euclidprobe/euclidprobe.github.io/pages/mydoc/02a_Omron.md

---
title: "Omron Fotek Conversion mounts for Euclid Probe"
keywords: tool mount, Omron Fotek
tags: [mounts]
last_updated: February 5, 2022
permalink: 02a_Omron.html
sidebar: mydoc_sidebar
folder: mydoc
toc: false
summary: Euclid Probe Conversion Mount Omron Fotek 
---

### Omron Mounts

The modular building blocks provided are meant to be integrated into users own printer and other CNC machine designs.  

They are provided in surface mounted and recessed configurations, with pilot holes for M2.5 self tapping screws, M3 tap pilot holes and bores for M3 heatserts. 

<div style="width:100%;text-align:center;"> <a href="stls\Omron\02_OmronFotec.png" data-lity>
</a>

 <a href="stls\Omron\02_OmronFotec90.png" data-lity>
</a></div>  

<P>
Omron Mounts are <a href='https://github.com/nionio6915/Euclid_Probe/tree/stls/Mount%20Adapters/Omron' target="_blank"><b> here.</b></a>
