euclidprobe/euclidprobe.github.io/pages/mydoc/02c_Voron.md

---
title: "Voron Overview"
keywords: Voron
tags: [mounts, docks]
last_updated: February 5, 2022
permalink: 02c_Voron.html
sidebar: mydoc_sidebar
folder: mydoc
toc: true
summary: Voron Probe Docks & Mounts Overview 
---

## Mounts & Docks for Voron
Below is a general summary for Voron printers. More specific information on the individual model pages. 

Screen snips, CAD's and stl's in are <a href="https://raw.githubusercontent.com/nionio6915/Euclid_Probe/main/stls/Voron/" targer="blank">in the github repo</a> and linked from the individual pages. 

Voron printers can utilize the Omton/Fotek conversion mount for existing builds. 

Modified carraige shells (both MGN9 & MGN 12 versions) locate the toolboard in the same realtive (X,Y) location as the inductive probe, but ~4.5mm higher. 

{% include note.html content="Using conversion mounts offers the most flexibility and fine tuning of probe height." %}

{% include note.html content="<b> Stealthburner / CW2 has been implemented. As the source was finally released, we have integrated Euclid's mounting into the native carriage.    
.</b>" %}

## Clcockwork1 - 2xMGN9 Rail & MGN12 - Afterburner Native Mounts
The left and right halves of the Afterburner carriage are modified to accept the probe with M3 screws and heatserts or M2.5 self tapping screws from underneath. Fine tuning and tweaking credited to garbqgebag.  

<div style="width:100%;text-align:center;">
<a href="images\02-voron\afterburner-1.8.png" data-lity>
</a>

<a href="images\02-voron\Voron_Afterburner-Native.png" data-lity>
</a>

<a href="images\02-voron\image1.jpg" data-lity>
</a>

<a href="images\02-voron\image2.jpg" data-lity>
</a>
</div>  

## Omron Mounts  
The standard Omron mount is 0 degree relative rotation to the mounting face of the Omron device. Adjustment slots are similar to the original device.  Designed to be printed upside-down without supports.  Screens are out of date, but the stls and CAD models are updated

<div style="width:100%;text-align:center;"> <a href="stls\Omron\02_OmronFotec.png" data-lity>
</a>  

 <a href="stls\Omron\02_OmronFotec90.png" data-lity>
</a>  
</div>  

Omron Mounts are <a href='https://github.com/nionio6915/Euclid_Probe/tree/main/stls/Mount%20Adapters/Omron' target="_blank"><b> here.</b></a>

## Skinny Mount- Improved Airflow mount by v6cl 
Github user v6cl posted a video to Youtube that we came across and we were impressed by their deployment. They designed a ‘skinny mount’ to  <a href="https://github.com/v6cl/My-Voron2.4-Customs/tree/main/euclid_mount_slim" targer="blank">open up the cooling vents in the toolhead.</a>

<div style="width:100%;text-align:center;"> <a href="images\02-voron\v6cl.png" data-lity>
</a>  

 <a href="images\02-voron\v6cl_dtl.png" data-lity>
</a>  
</div>  
<br>  

Their repo is at <a href="https://github.com/v6cl/My-Voron2.4-Customs">https://github.com/v6cl/My-Voron2.4-Customs</a>  

## Stealthburner / Clockwork2 - MGN12 Native Mounts

New in the github repo are the revised Omron-Fotek Inductive Sensor adapters, .stp's and .stl's. 

 <div style="width:100%;text-align:center;"> 
  <a href="images\02-voron\CW2_Native.jpg" data-lity>  
 </a>

  <a href="images\02-voron\OmronFotekV4.jpg" data-lity>  
 </a>

</div>
<hr>
The left and right halves of the native carriage shells for Voron Stealthburner / CW2 / Clockwork 2 have been modified to accept the probe with M2.5 self tapping screws from underneath. 

## Trident & 2.4 Native Gantry Dock & Mount 

The mount attaches with screws in the holes of the left side motor bracket and clears the radius of the cable chain. M5x16 & M5x30's  
     
The dock attaches to the mount with an M5 nut dropped in the keyholed channel and thru-bolts with an M5x16 screw. Adjust the elevation as required to allow for a clean exit of the probe PCB. Fine tuning and tweaking credited to Dattas and StvPtrsn.

<div style="width:100%;text-align:center;">
<a href="images\02-voron\Trident_TopMount.png" data-lity>
</a>  

<a href="images\02-voron\Trident_TopMountXRay.png" data-lity>
</a>  

<a href="images\02-voron\Trident_TopMountXRay2.png" data-lity>
</a>  
</div> 

## Straight Armed Gantry Dock & Mount
This mount attaches to the rear extrusion of the gantry, in the native holes of the left side motor bracket. Requires the use of the Omron90 mount. Lateral adjustment buy the thru-bolt on the bottom, M5x16. Fine vertical adjustment via the slotted holes in the Omron mount. 

This probe orientation / configuration should be compatible with the other detachable probe macros for Voron. 

<div style="width:100%;text-align:center;">
<a href="images\02-voron\Voron2.4_XRailMount2.png" data-lity>
</a>  

<a href="images\02-voron\Voron2.4_XRailMount.png" data-lity>
</a>  
</div>

## 90 Degree Gantry Dock & Mount
This dock is orientated in the X direction and attaches to the rear extrusion of the gantry, in the native holes of the left side motor bracket. Requires the use of the Omron90 mount. Attaches with longer screws. Lateral Y adjustment via the thru-bolt on the bottom, M5x16. Fine vertical adjustment via the slotted holes in the Omron mount or with shims between the Y adjuster.   

<div style="width:100%;text-align:center;">
<a href="images\02-voron\Voron2.4_XRailMount90.png" data-lity>
</a>  

<a href="images\02-voron\Voron2.4_XRailMount90a.png" data-lity>
</a>  
</div>

## Voron 2.4 Bed Rail Mounted Dock  
The bed mounts are provided in 2 heights to suit the overall stack height of the bed plate and printing surfaces. This dock has been tested by multiple users. Fine tuning and tweaking credited to kageurufu.  

The stls are provided to print 'nose' down and have minimal print in place supports to ensure that the back shoulder is printed and aligned.  

The bed rail mount uses 2-M5x16 screws and extrusion nuts to attach to either side of the extrusions that support the bed.  

There are 2 hex-shaped cross holes to the main mounting screws- these are provide to insert M3 screws to use as fine adjusters without tapping. They can be M3 setscrews and left in place or any M3 screw used temporarily.   
<div style="width:100%;text-align:center;">

<a href="images\02-voron\Voron2.4BedMount.png" data-lity>
</a>  

<a href="images\02-voron\Voron2.4BedMount.png" data-lity>
</a>  
</div>
