euclidprobe/euclidprobe.github.io/pages/mydoc/02c_VCore.md

---
title: "VCore"
keywords: probe dock, tool mount
tags: [mounts, docks]
last_updated: January 24, 2022
permalink: 02c_VCore.html
sidebar: mydoc_sidebar
folder: mydoc
toc: false
summary: Euclid Probe Docks & Probes 
---

## Mounts by Printer VCore
EVA carriage mount brackets and front cross rail mounted docks have been modeled and placed in the repo by series. 

Print the dock on the angled back face with the dock arms pointed up. The back chamfer and reveal a hex shaped bore to install the M5x20 screw and T-nut for the slot. The alignment bosses are sized for an 8mm slot width.  

<div style="width:100%;text-align:center;">
  <a href="images\02-VCore\Print_Orientation.png" data-lity>
  </a>
</div>

The initial EVA carriage mounts was proportioned for Duct V2.1 Straight and has recessed for nuts to attach the toolboard from the underside. Use M3x10 button head, or countersink the PCB for M3X10 flat head screws.

The EVA 2.4 mount was designed to fit around the regular tri-horn mount. Use with either the mid-width or wide width tri-horn will require spacers to adjust the mount outwards, and will result in a reduced print area.

EVA 3 mount and dock is user contributed. 

The V-Core3 dock is proportioned for 3030 extrusion.

The V-Core Legacy dock is proportioned to fit under the 2040 front extrusion. This dock is in 2 parts and uses an M3 drawbolt to provide a small amount of vertical adjustability .
