euclidprobe/euclidprobe.github.io/pages/mydoc/02c_VCore3.md

---
title: "VCore3"
keywords: probe dock, tool mount
tags: [mounts, docks]
last_updated: January 24, 2022
permalink: 02c_VCore3.html
sidebar: mydoc_sidebar
folder: mydoc
toc: false
summary: Euclid Probe Docks & Mounts RatRig V-Core3
---

## Mounts by Printer VCore3
<div style="width:100%;text-align:center;">
<style type="text/css">
.tg  {border-collapse:collapse;border-spacing:0;}
.tg td{border-color:black;border-style:solid;border-width:0px;font-family:Arial, sans-serif;font-size:14px;
  overflow:hidden;padding:0px;word-break:normal;}
.tg th{border-color:black;border-style:solid;border-width:0px;font-family:Arial, sans-serif;font-size:14px;
  font-weight:normal;overflow:hidden;padding:0px;word-break:normal;}
.tg .tg-0pky{border-color:inherit;text-align:center;vertical-align:middle}
</style>

<table class="tg">
<tbody>
<tr>
<td>
<div style="width:100%;text-align:center;">
  <a href="images\02-VCore\Euclid_Probe_Screen1.jpg" data-lity>
  </a>
</div>
</td>
<td>
<div style="width:100%;text-align:center;">
  <a href="images\02-VCore\Euclid_Probe_Screen2.jpg" data-lity>
  </a>
</div>
</td>
</tr>
<tr>
<td>
<div style="width:100%;text-align:center;">
  <a href="images\02-VCore\Euclid_Probe_Screen3.jpg" data-lity>
  </a>
</div>
</td>
<td>
<div style="width:100%;text-align:center;">
  <a href="images\02-VCore\Euclid_Probe_Screen4.jpg" data-lity>
  </a>
</div>
</td>
</tr>

<tr>
<td>
<div id="stl_cont0" style="width:450px;height:450px;margin:5 auto">
    <script>
        var stl_viewer=new StlViewer
        (
        document.getElementById("stl_cont0"), 
          {
            allow_drag_and_drop: false,
            auto_rotate:true,
            auto_resize:true,
            zoom:110,
            models: 
            [ 
             {filename:"https://raw.githubusercontent.com/nionio6915/Euclid_Probe/main/stls/V-Core/V-Core3/Euclid_EVA_DockV5_3030.stl",color:"#1E73BE", rotationx:5.0,    rotationy:-0.50, rotationz:0.0} 
            ]
          }
        );
    </script>
</div> 
</td>

<td>
<div id="stl_cont1" style="width:450px;height:450px;margin:5 auto">
    <script>
        var stl_viewer=new StlViewer
        (
        document.getElementById("stl_cont1"), 
          {
            allow_drag_and_drop: false,
            auto_rotate:true,
            auto_resize:true,
            zoom:110,
            models: 
            [ 
             {filename:"https://raw.githubusercontent.com/nionio6915/Euclid_Probe/main/stls/V-Core/V-Core3/Euclid_EVA_MountV5_M2.5SelfTapping.stl",color:"#1E73BE", rotationx:5.0,    rotationy:-0.50, rotationz:0.0} 
            ]
          }
        );
    </script>
</div> 
</td>
</tr>
<tr>
    <td class="tg-0pky"><a href="https://raw.githubusercontent.com/nionio6915/Euclid_Probe/main/stls/V-Core/V-Core3/Euclid_EVA_DockV5_3030.stl">V-Core3 3030 Extrusion Dock</a></td>
    <td class="tg-0pky"><a href="https://raw.githubusercontent.com/nionio6915/Euclid_Probe/main/stls/V-Core/V-Core3/Euclid_EVA_MountV5_M2.5SelfTapping.stl">V-Core3 EVA Carriage Mount</a></td>
</tr>
</tbody>
</table>  
</div>  

## Print Orientation

<div style="width:100%;text-align:center;">
  <a href="images\02-VCore\Print_Orientation.png" data-lity>
  </a>  
</div>

## CAD Files
The current CAD files are <a href='https://github.com/nionio6915/Euclid_Probe/tree/main/CAD' target="_blank"><b> available here in the repo.</b></a>
