euclidprobe/euclidprobe.github.io/pages/mydoc/00-kit.md

---
title: "Buy a Euclid Probe Kit"
keywords: euclid probe magnetic z-probe endstop
tags: [resellers, buying, EU, USA, UK, DK]
last_updated: February 16, 2022
sidebar: mydoc_sidebar
permalink: 00_kit.html
toc: false
summary: Where to get the highly accurate, magnetically coupled, Z probe
---

## How to get Euclid Probe

### Buy a kit from a reseller 
Due to numerous inquiries and customer demand, we have begun producing kits and make them available through select resellers.  Part of the proceeds of these sales directly support both the creators of Euclid Probe and the reseller. These funds provide for further research and development for Euclid Probe, the continual dock and mount creation and adaptations, and the ongoing firmware improvements. 

Kit assembly instructions are <a href="/01_kitbuild.html">here</a>

### We don't offshore 
We don't offshore the labor to package and label Euclid kits- we believe in the ethos of putting community first and that sound business practices can serve a greater good.  

While we are not a 'B Corp' we look to the World's B Corps for inspiration and example of putting community at the heart of what they do.  

We believe in the importance to serve those in need locally over the maximization of profit: we have begun a partnership that engages the services of local community organizations whose mission is to improve the quality of life for individuals with disabilities through vocational and related programming to produce the kits from our sourced materials.  

### Resellers:

<div style="width:100%;text-align:center;">
<style type="text/css">
.tg  {border-collapse:collapse;border-spacing:0;}
.tg td{border-color:white;border-style:solid;border-width:4px;font-family:Arial, sans-serif;font-size:14px;
  overflow:hidden;padding:10px 5px;word-break:normal;}
.tg th{border-color:white;border-style:solid;border-width:4px;font-family:Arial, sans-serif;font-size:14px;
  font-weight:normal;overflow:hidden;padding:10px 5px;word-break:normal;}
.tg .tg-0lax{text-align:left;vertical-align:middle}
</style>

<table class="tg">
  <thead>
  </thead>

<tbody>
  <tr>
    <td class="tg-0lax"></td>
    <td class="tg-0lax"><a href="https://lukeslabonline.com/products/euclid-probe-kit" target="blank">&nbsp;&nbsp;LukesLab.Online&nbsp;&nbsp;</a></td>
    <td class="tg-0lax">&nbsp;&nbsp;</td>
    <td class="tg-0lax"></td>
  </tr>

  <tr>
    <td class="tg-0lax"></td>
    <td class="tg-0lax"><a href="https://713maker.com/en/euclid" target="blank">&nbsp;&nbsp;713maker.com &nbsp;&nbsp;</a></td>
    <td class="tg-0lax">&nbsp;&nbsp;</td>
    <td class="tg-0lax"></td>
  </tr>

  <tr>
    <td class="tg-0lax"></td>
    <td class="tg-0lax"><a href="https://www.fabreeko.com/products/euclid-probe-kit-24v" target="blank">&nbsp;&nbsp;Fabreeko&nbsp;&nbsp;</a></td>
    <td class="tg-0lax">&nbsp;&nbsp;</td>
    <td class="tg-0lax"></td>
  </tr>
  <tr>
    <td class="tg-0lax"></td>
    <td class="tg-0lax"><a href="https://3do.dk/soeg?controller=search&s=euclid" target="blank">&nbsp;&nbsp;3do.eu&nbsp;&nbsp;</a></td>
    <td class="tg-0lax">&nbsp;&nbsp;</td>
    <td class="tg-0lax"></td>
  </tr>

  <tr>
    <td class="tg-0lax"><a href="https://gingerbeard3d.de/" target="blank">&nbsp;&nbsp;</a></td>
    <td class="tg-0lax"><a href="https://gingerbeard3d.de/" target="blank">&nbsp;&nbsp; Gingerbeard3D&nbsp;&nbsp;</a></td>
    <td class="tg-0lax">&nbsp;&nbsp;</td>
    <td class="tg-0lax"></td>
  </tr>

  <tr>
    <td class="tg-0lax"></td>
    <td class="tg-0lax"><a href="https://www.ratrig.com/" target="blank">&nbsp;&nbsp;RatRig&nbsp;&nbsp;</a></td>
    <td class="tg-0lax">&nbsp;  &nbsp; </td>
    <td class="tg-0lax"></td>
  </tr>

  <tr>
    <td class="tg-0lax"></td>
    <td class="tg-0lax"><a href="https://www.jayuk.org/" target="blank">&nbsp;&nbsp; Jay's UK&nbsp;&nbsp;</a></td>
    <td class="tg-0lax">&nbsp;&nbsp;</td>
    <td class="tg-0lax"></td>
  </tr>

  <tr>
    <td class="tg-0lax"></td>
    <td class="tg-0lax"><a href="https://www.raven3dtech.com.au/" target="blank">&nbsp;&nbsp;Raven 3D Tech&nbsp;&nbsp;</a></td>
    <td class="tg-0lax">&nbsp;  &nbsp;</td>
    <td class="tg-0lax">  </td>
  </tr>
</tbody>
</table>
</div>
