euclidprobe/euclidprobe.github.io/pages/mydoc/03_misc.md

---
title: "Euclid Wiring to Duet3 Hardware"
keywords: probe wiring
tags: [wiring, RAMPS, ReARM, MKS, MKS_BASE, Fystec, Spider]
last_updated: Feb 5, 2022
permalink: 03_misc.html
sidebar: mydoc_sidebar
folder: mydoc
toc: true
summary: Euclid Wiring to Duet3 Hardware
---
### RAMPS Controller Commissioning
MEGA/RAMPS mainboard can use either the standard 5V or 24V Euclid models. Wire Euclid Probe to any open endstop connector.    

<table>
<tr>
   <td> <a href="images\04-wiring\boards_misc\Slide1.PNG" data-lity>
        </a>
   </td>
</tr>
<tr>
   <td><b>RAMPS Mainboard Wiring Diagram</b></td>
</tr>
</table>

### MKS_BASE Commissioning
MKS_BASE mainboard can use either the standard 5V or 24V Euclid models. Wire Euclid Probe to any open endstop connector. 
<table>
<tr>
   <td> <a href="images\04-wiring\boards_misc\Slide2.PNG" data-lity>
        </a>
   </td>
</tr>
<tr>
   <td><b>MKS_BASE 1.6 Wiring Diagram</b></td>
</tr>
</table>

### Panucatt ReARM Commissioning
ReARM mainboard can use either the standard 5V or 24V Euclid models. Wire Euclid Probe to any open endstop connector. 
<table>
 <tr>
    <td> <a href="images\04-wiring\boards_misc\Slide3.PNG" data-lity>
         </a>
    </td>
 </tr>
 <tr>
    <td><b>ReARM Mainboard Wiring Diagram</b>
    </td>
 </tr>
</table>

### Fystec Spider Commissioning
Fystec Spider mainboard can use either the standard 5V or 24V Euclid models depending on the application. Wire Euclid Probe to any open endstop connector or to the probe connector.

Wiring to the probe connector via a toolboard requres coordination- do not wire multiple BAT85 diodes in series. 
<table>
 <tr>
    <td> <a href="images\04-wiring\boards_misc\Slide4.PNG" data-lity>
         </a>
    </td>
 </tr>
 <tr>
     <td><b>Fystec Spider Wiring Diagram as endstop</b>
     </td>
 </tr>
 <tr>
     <td> <a href="images\04-wiring\boards_misc\Slide5.PNG" data-lity>
         </a>
     </td>
 </tr>
 <tr>
     <td><b>Fystec Spider Wiring Diagram to toolboard</b>
     </td>
 </tr>

 </table>
