euclidprobe/euclidprobe.github.io/pages/mydoc/03_fly.md

---
title: "Euclid Wiring to FLY Mellow boards"
keywords: probe wiring
tags: [wiring, FLY, Mellow, FLY-Mellow]
last_updated: Feb 5, 2022
permalink: 03_fly.html
sidebar: mydoc_sidebar
folder: mydoc
toc: true
summary: Euclid Wiring to Fly-Mellow Hardware
---
FLY Mellow boards can use either the standard 5V or 24V Euclid models wired to any open endstop connector.  

### FLY Mellow RRF3-E3
<table>
 <tr>
     <td> <a href="images\04-wiring\boards_Fly\Slide1.PNG" data-lity>
         </a>
     </td>
 </tr>
 <tr>
     <td><b>Fly RRF E3 Wiring Diagram</b></td>
 </tr>
</table>

### FLY Mellow FLY-CDYV3
<table>
 <tr>
     <td> <a href="images\04-wiring\boards_Fly\Slide3.PNG" data-lity>
         </a>
     </td>
 </tr>
 <tr>
     <td><b>FLY-Mellow FLY-CDY Wiring Diagram</b></td>
 </tr>
 </table>

### FLY Mellow FLY-F407ZG
<table>
 <tr>
     <td> <a href="images\04-wiring\boards_Fly\Slide2.PNG" data-lity>
         </a>
     </td>
 </tr>
 <tr>
     <td><b>FLY-Mellow FLY-F407ZG Wiring Diagram</b></td>
 </tr>
 </table>

### FLY Mellow Super 8
<table>
 <tr>
     <td> <a href="images\04-wiring\boards_Fly\Slide4.PNG" data-lity>
         </a>
     </td>
 </tr>
 <tr>
     <td><b>FLY-Mellow Super 8 Wiring Diagram</b></td>
 </tr>
 </table>
