euclidprobe/euclidprobe.github.io/pages/mydoc/03_smoothie.md

---
title: "Euclid Wiring to Smoothieboard"
keywords: probe wiring
tags: [wiring, smoothie, smoothieboard]
last_updated: Feb 5, 2022
permalink: 03_smoothie.html
sidebar: mydoc_sidebar
folder: mydoc
toc: false
summary: Euclid Wiring to Smoothieboard Hardware
---
### Smoothiebaord Commissioning
Smoothieboards can use either the standard 5V or 24V Euclid models wired to any open endstop connector.    

<table>
 <tr>
     <td> <a href="images\04-wiring\boards_misc\smoothieV1.png" data-lity>
         </a>
     </td>
 </tr>
 <tr>
     <td><b>Smoothieboard Wiring Diagram</b></td>
 </tr>
 </table>
