euclidprobe/euclidprobe.github.io/pages/mydoc/03_duet2.md

---
title: "Euclid Wiring to Duet2 Hardware"
keywords: probe wiring
tags: [wiring, Duet2]
last_updated: Feb 5, 2022
permalink: 03_duet2.html
sidebar: mydoc_sidebar
folder: mydoc
toc: false
summary: Euclid Wiring to Duet2 Hardware
---
### Duet2 Commissioning
Duet2 boards can use either the standard 5V or 24V Euclid models. Wire Euclid Probe to the Probe port any open endstop connector.    

<table>
 <tr>
     <td> <a href="images\04-wiring\boards_Duet\Slide3.PNG" data-lity>
         </a></td>
 <tr>
     <td><b>Duet2 Mainboard Wiring Diagram</b></td>
 </tr>
 <tr>
     <td> <a href="images\04-wiring\boards_Duet\Slide4.PNG" data-lity>
         </a></td>
 <tr>
     <td><b>Duet2 Mainboard Wiring as Picture</td>
 </tr>
 </table>
