euclidprobe/euclidprobe.github.io/pages/mydoc/00-HT.md

---
title: "Industrial, High Temperature, Bulk Buy"
keywords: euclid probe magnetic z-probe endstop
tags: [Industrial, High Temp, bulk buy, white box, custom]
last_updated: February 16, 2022
sidebar: mydoc_sidebar
permalink: 00_HT.html
toc: false
summary: Where to get the highly accurate, magnetically coupled, Z probe
---

## How to get other versions of Euclid Probe

### High Temp & Industrial Versions
Higher service temperature versions of both both 100C and 120C have been developed and are at this time, custom order, hand built options. Please contact us through the web form for details.

### White Box / Bulk buy
In response to customer inquiry, bulk packs of Euclid Probe are available at modest discounts to printer builders and integrators. Please contact us through the web form for details.
