euclidprobe/euclidprobe.github.io/pages/mydoc/02c_Ender5.md

---
title: "Ender5"
keywords: probe dock, tool mount
tags: [mounts, docks]
last_updated: Feb 5, 2022
permalink: 02c_Ender5.html
sidebar: mydoc_sidebar
folder: mydoc
toc: false
summary: Euclid Probe Docks & Probes 
---

## Mounts by Printer Ender5
Page currently undergoing maintenance. 

The following .zip files includes .step and .DXF files of all the modular docks and mounts for CAD interchange.

The mounting instructions and dock for the Ender5 are similar to the Ender3 above, with the exception that the toolboard mount has a cutout for the X-axis belt crimp, and the mount faces the front of the printer.
The dock keys into the corner clamp and hopefully reuses the M5 mounting screw and T-nut.

<div style="width:100%;text-align:center;"> <a href="images\02-ender\Ender5Front.jpg " data-lity>
</a></div>

<div style="width:100%;text-align:center;"> <a href=" images\02-ender\Ender5Iso.jpg" data-lity>
</a></div>

<div style="width:100%;text-align:center;"> <a href="images\02-ender\Ender5Dock.jpg " data-lity>
</a></div>

<div style="width:100%;text-align:center;"> <a href="images\02-ender\Ender5XRayFront.jpg " data-lity>
</a></div>

<div style="width:100%;text-align:center;"> <a href=" images\02-ender\Deploy.jpg" data-lity>
</a></div>

<div style="width:100%;text-align:center;"> <a href=" images\02-ender\Retract.jpg" data-lity>
</a></div>
