euclidprobe/euclidprobe.github.io/pages/mydoc/02c_Ender.md

---
title: "Ender"
keywords: Ender Overview 
tags: [mounts, docks]
last_updated: Feb 5, 2022
permalink: 02c_Ender.html
sidebar: mydoc_sidebar
folder: mydoc
toc: false
summary: Ender Probe Docks & Mounts 
---

## Mounts by Printer Ender
Page currently undergoing maintenance. 

The following .zip files includes .step and .DXF files of all the modular docks and mounts for CAD interchange.
