euclidprobe/euclidprobe.github.io/pages/mydoc/02a_BLTouch.md

---
title: "BL Touch / CR Touch Conversion mount for Euclid Probe"
keywords: BL Touch, conversion
tags: [mounts]
last_updated: February 5, 2022
permalink: 02a_BLTouch.html
sidebar: mydoc_sidebar
folder: mydoc
toc: false
summary: Euclid Probe BL Touch & CR Touch Conversion mount 
---

The BL Touch mounts are designed to be printed either on the side or upside-down, with the top against the build plate (the stl previewer may render them in their upright orientation).

The current recommended model is this skeletonized version of the BL Touch Mount.  
<P>
BLTouch Mounts are  <a href='https://github.com/nionio6915/Euclid_Probe/tree/main/stls/Mount%20Adapters/BLTouch' target="_blank"><b> here.</b></a>  

>

<script>
    var stl_viewer=new StlViewer
    (
      document.getElementById("stl_cont"), 
      {
          allow_drag_and_drop: false,
          auto_rotate:true,
          auto_resize:true,
          models: 
          [ 
            {filename:"../stls/BLTouch/BLTouchV3.stl", color:"#1E73BE", rotationx:5.0, rotationy:-0.50, rotationz:0.0} 
          ]
      }
    );
</script>  

There are also further customized versions of BLTouch mount for Hypercube with a slightly wider (5mm) lateral offset.  

In the following renders, the yellow items are the single wall PIP supports to be removed after printing.

<div style="width:100%;text-align:center;"> <a href="stls\BLTouch\02_BLT_Adapter.jpg" data-lity>
</a>

<div style="width:100%;text-align:center;"> <a href="stls\BLTouch\02_BLT.jpg" data-lity>
</a>

 <a href="stls\BLTouch\02_BL_Touch_M3HeatSerts.jpg" data-lity>
</a></div>
