euclidprobe/euclidprobe.github.io/pages/mydoc/02a_Inductive.md

---
title: "Inductive Probe Conversion mounts for Euclid Probe"
keywords: inductive, conversion
tags: [mounts]
last_updated: February 5, 2022
permalink: 02a_Inductive.html
sidebar: mydoc_sidebar
folder: mydoc
toc: false
summary: Euclid Probe BL Touch Conversion mount 
---

### Inductive Toolboard Mounts

The modular building blocks provided are meant to be integrated into users own printer and other CNC machine designs. They are provided in surface mounted and recessed configurations, with pilot holes for M2.5 self tapping screws, M3 tap pilot holes and bores for M3 heatserts. 
<div style="width:100%;text-align:center;">  
<table>
<tr>
  <td><div style="width:100%;text-align:center;"> </div></td>
  <td><div style="width:100%;text-align:center;"> </div></td>
</tr>
<tr>
  <td>
  <script>
    var stl_viewer=new StlViewer
    (
      document.getElementById("stl_cont0"), 
      { 
          allow_drag_and_drop: false, 
          auto_rotate:true, 
          auto_resize:true, 
          models: 
           [ 
            {filename:"../stls/Inductive/12mmInductive.stl", color:"#1E73BE", scale:3, rotationx:5.0, rotationy:-0.50, rotationz:0.0} 
           ] 
      }
    );
  </script>
  </td>

  </td>
  <td>
  <script>
    var stl_viewer=new StlViewer
    (
      document.getElementById("stl_cont1"), 
      { 
          allow_drag_and_drop: false, 
          auto_rotate:true, 
          auto_resize:true, 
          models: 
           [ 
            {filename:"../stls/Inductive/18mmInductive.stl", color:"#1E73BE", scale:3, rotationx:5.0, rotationy:-0.50, rotationz:0.0} 
           ] 
      }
    );
  </script>
  </td>
</tr>
<tr>
  <td>12mm Diameter Probe</td>
  <td>18mm Diameter Probe</td>
</tr>
</table>
</div>
