euclidprobe/euclidprobe.github.io/pages/mydoc/02c_Croxy.md

---
title: "Crocyr"
keywords: probe dock, tool mount
tags: [mounts, docks]
last_updated: Feb 5, 2022
permalink: 02c_Croxy.html
sidebar: mydoc_sidebar
folder: mydoc
toc: false
summary: Euclid Probe Docks & Probes 
---

## Mounts by Printer Voron 

The following .zip files includes .step and .DXF files of all the modular docks and mounts for CAD interchange.
