euclidprobe/euclidprobe.github.io/pages/mydoc/02_conversion.md

---
title: "Euclid Probe Conversion Mounts"
keywords: probe dock, tool mount
tags: [mounts, docks]
last_updated: January 29, 2022
permalink: 02_conversion.html
sidebar: mydoc_sidebar
folder: mydoc
toc: false
summary: Euclid Probe Conversion Mounts 
---
# Euclid Probe Conversion Mounts 
Below are the conversion mounts designed buy Euclid Probe’s team to replace other probe technologies on existing printers.

Determine the best orientation of the tool board and probe before assembly. 

The orientation of the tool board does not necessarily have to match the orientation of the probe. 

The probe is designed to enter the dock like an arrow, the wider section self-centering the PCB in case of misalignment. 

The 'arrows' can point in opposite ways. In fact, this is the orientation for an i3 style printer like an Ender3 or Wanhao i3, where the tool board motion points it to Xmin and the probe entering the Y-moving dock towards Xmax.   

<hr>
Reminder that community discussion and support is available as a subgroup to the <a href='https://discord.gg/jfnVrUx2uK'>CroXY Discord</a> <a href='https://discord.gg/jfnVrUx2uK'> CroXY Discord</a>
