euclidprobe/euclidprobe.github.io/pages/mydoc/02_modular.md

---
title: "Modular Docks & Mounts"
keywords: probe dock, tool mount
tags: [mounts, docks]
last_updated: January 24, 2022
permalink: 02_modular.html
sidebar: mydoc_sidebar
folder: mydoc
toc: false
summary: Euclid Probe Docks & Probes 
---

## Modular Docks & Toolboard Mounts

The following .zip files includes .step and .DXF files of all the modular docks and mounts for CAD interchange.
