euclidprobe/euclidprobe.github.io/images/00-accuracy-fixed.png

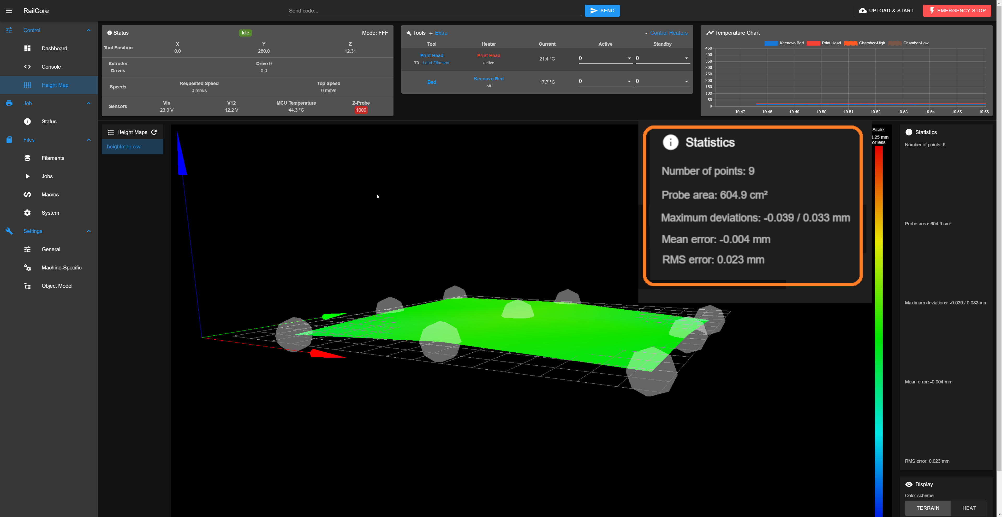
images/00-accuracy-fixed.png
