euclidprobe/euclidprobe.github.io/images/00-accuracyA.png

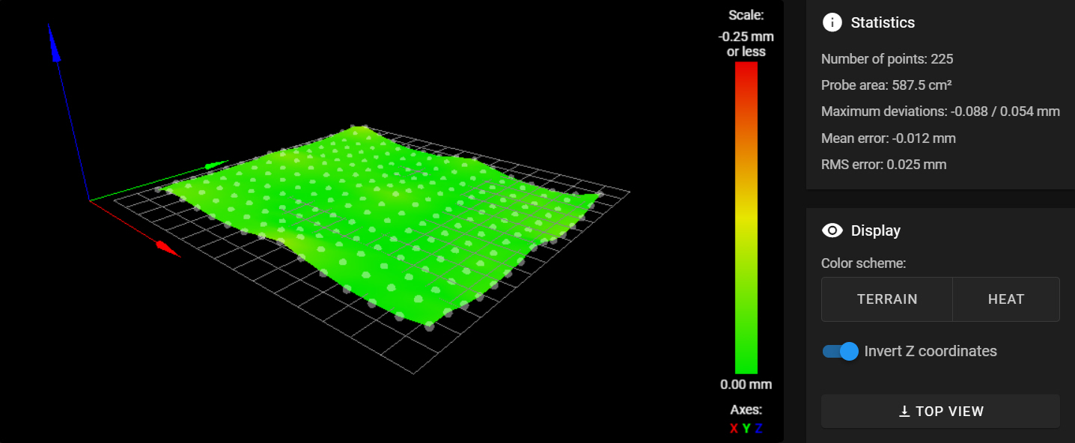
images/00-accuracyA.png
