euclidprobe/euclidprobe.github.io/images/00-aisler.png

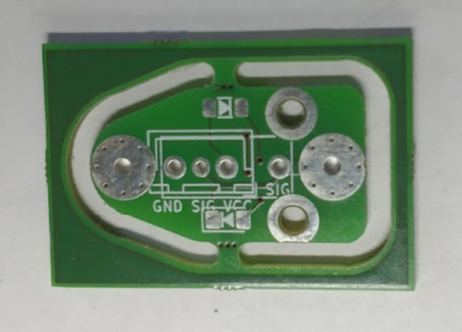
images/00-aisler.png
