euclidprobe/euclidprobe.github.io/images/00-BLTouch.png

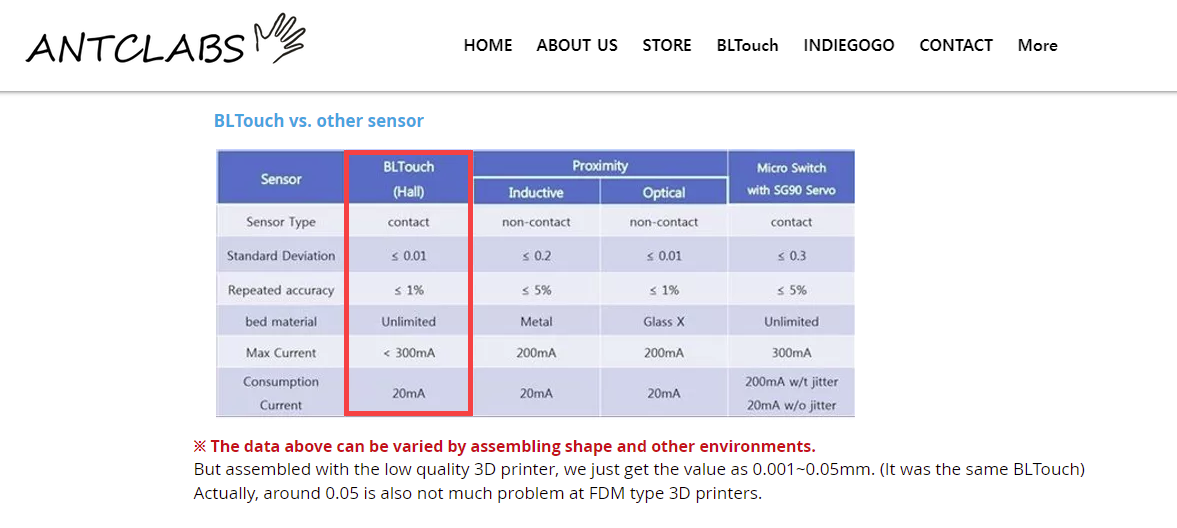
images/00-BLTouch.png
