euclidprobe/euclidprobe.github.io/images/00-falstad24V.jpg

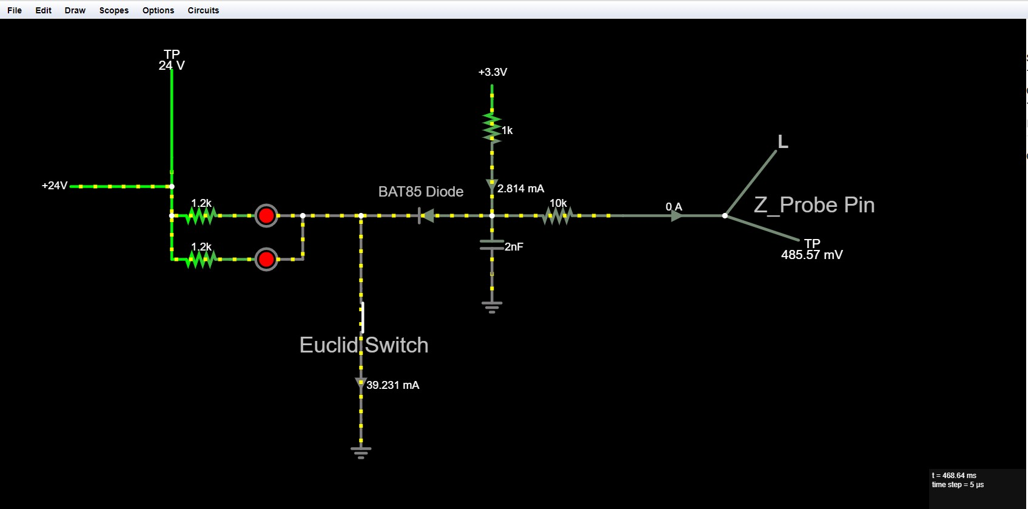
images/00-falstad24V.jpg
