euclidprobe/euclidprobe.github.io/images/00-falstad.jpg

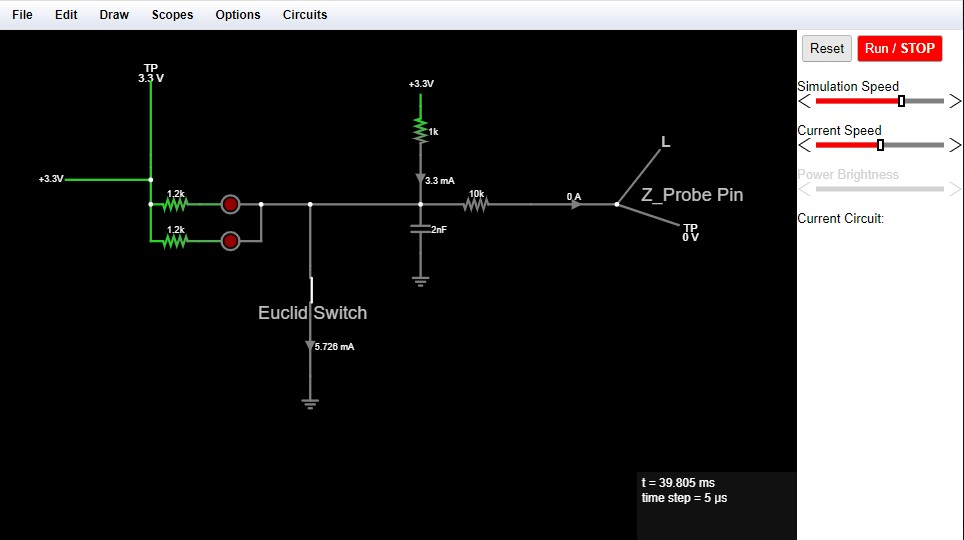
images/00-falstad.jpg
