euclidprobe/euclidprobe.github.io/images/01-ISO_View.png

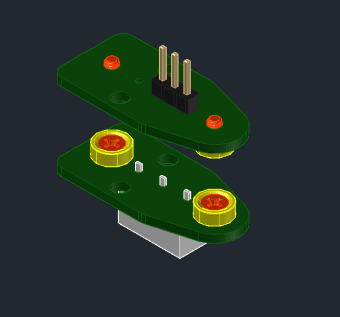
images/01-ISO_View.png
