euclidprobe/euclidprobe.github.io/images/01-isobtm2.png

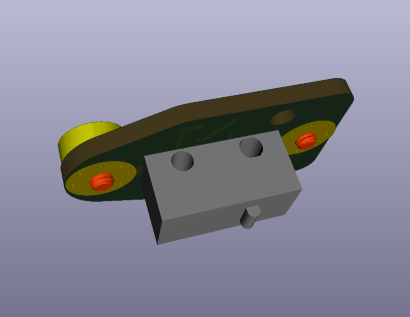
images/01-isobtm2.png
