euclidprobe/euclidprobe.github.io/images/01-isobtm.png

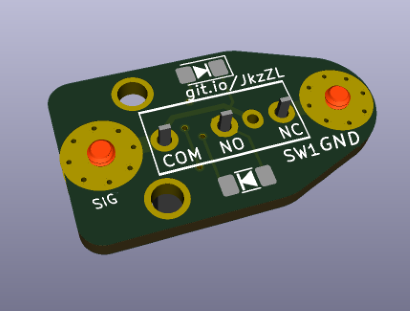
images/01-isobtm.png
