euclidprobe/euclidprobe.github.io/images/01-isotop2.png

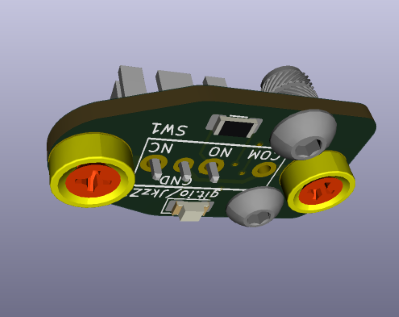
images/01-isotop2.png
