euclidprobe/euclidprobe.github.io/images/01-isotop.png

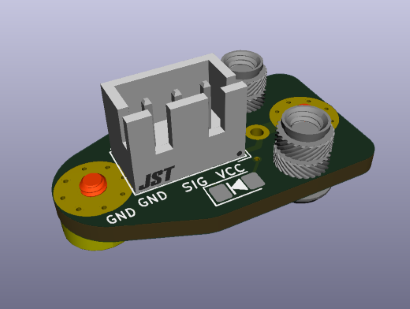
images/01-isotop.png
