euclidprobe/euclidprobe.github.io/images/01-mag-polarity-1024x480.jpg

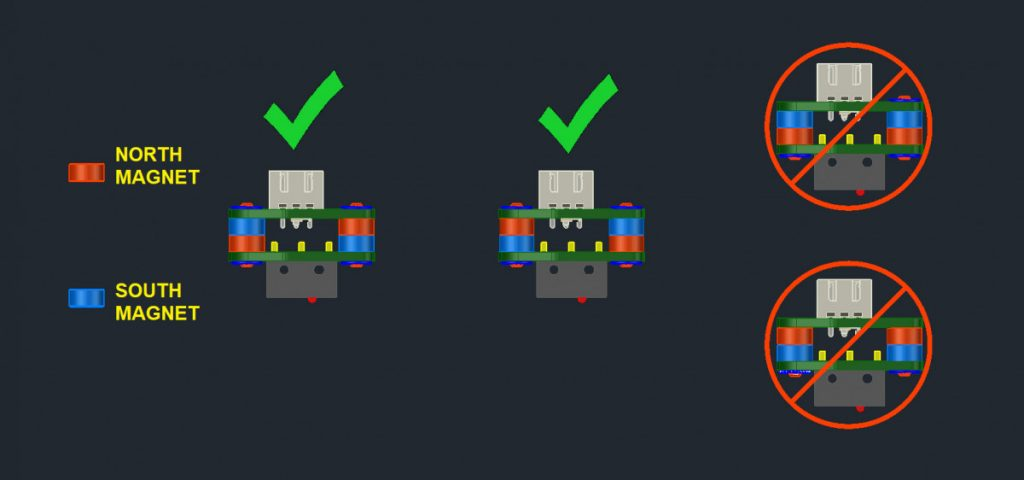
images/01-mag-polarity-1024x480.jpg
