euclidprobe/euclidprobe.github.io/images/01_5VPCB.jpg

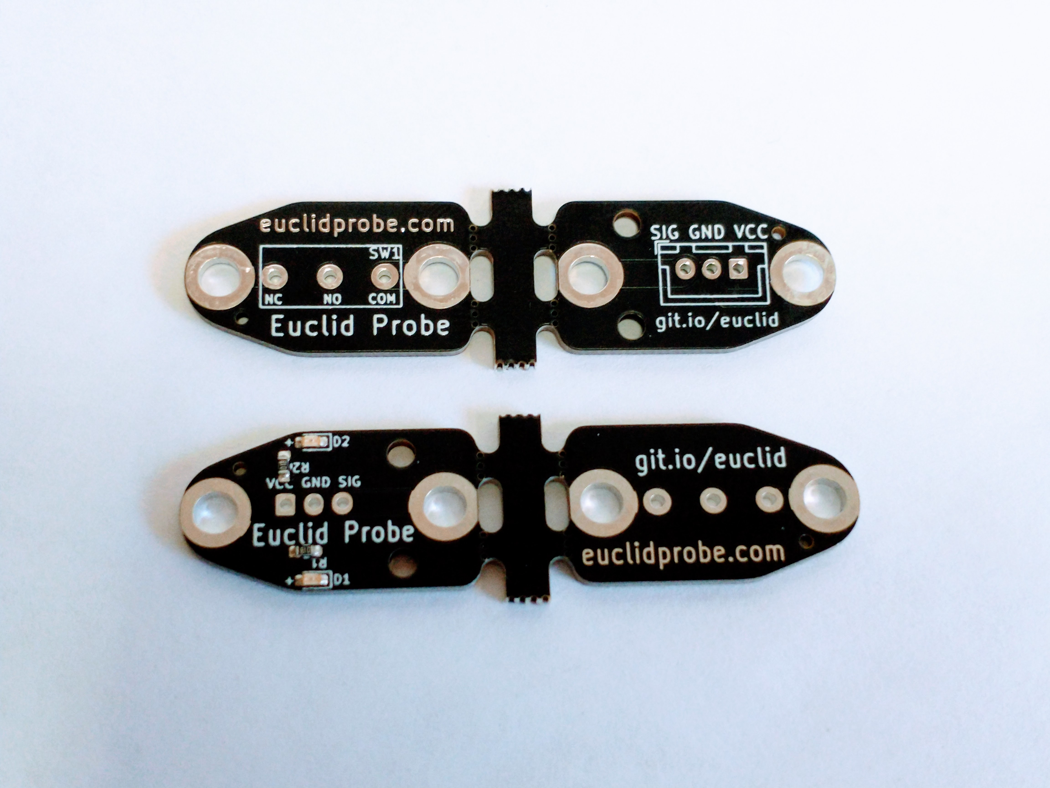
images/01_5VPCB.jpg
