euclidprobe/euclidprobe.github.io/images/01_24VPCB.jpg

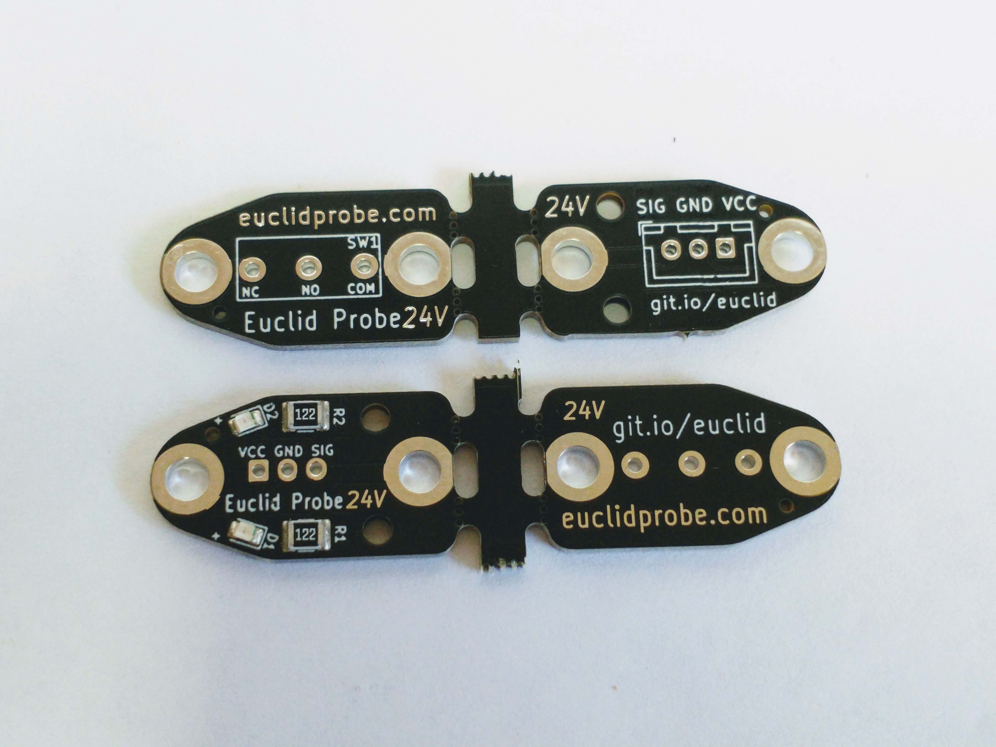
images/01_24VPCB.jpg
