euclidprobe/euclidprobe.github.io/images/01_Aisler2.png

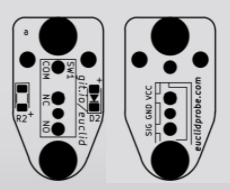
images/01_Aisler2.png
