euclidprobe/euclidprobe.github.io/images/01_OSHPark.png

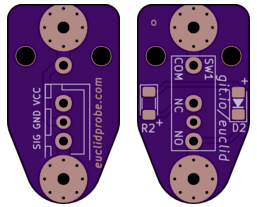
images/01_OSHPark.png
