euclidprobe/euclidprobe.github.io/images/02-ender/618f49b32c049.png

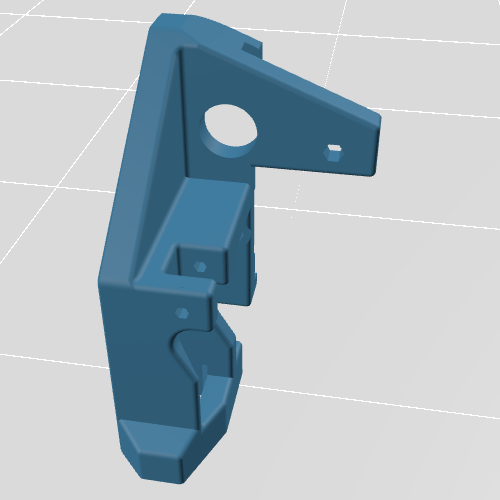
images/02-ender/618f49b32c049.png
