euclidprobe/euclidprobe.github.io/images/02-ender/61510d945ea5e.png

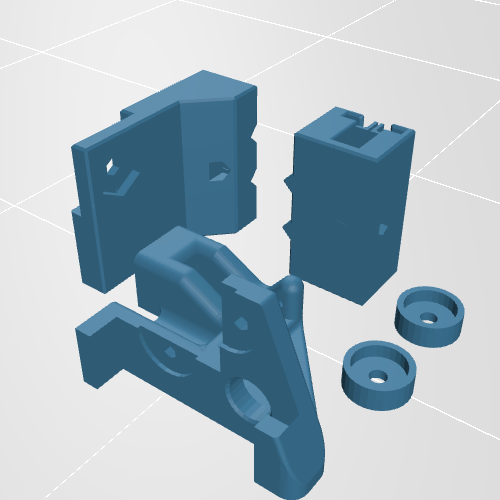
images/02-ender/61510d945ea5e.png
