euclidprobe/euclidprobe.github.io/images/02-ender/6151111f49dd7.png

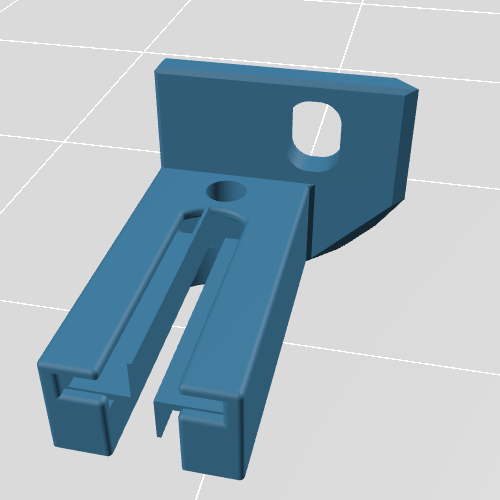
images/02-ender/6151111f49dd7.png
