euclidprobe/euclidprobe.github.io/images/02-ender/615111046e8de.png

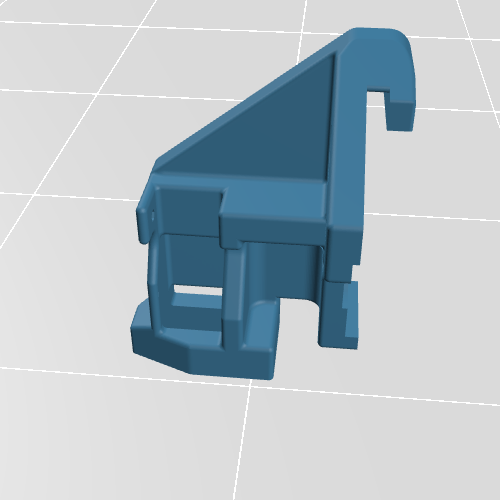
images/02-ender/615111046e8de.png
