euclidprobe/euclidprobe.github.io/images/02-ender/Deploy.jpg

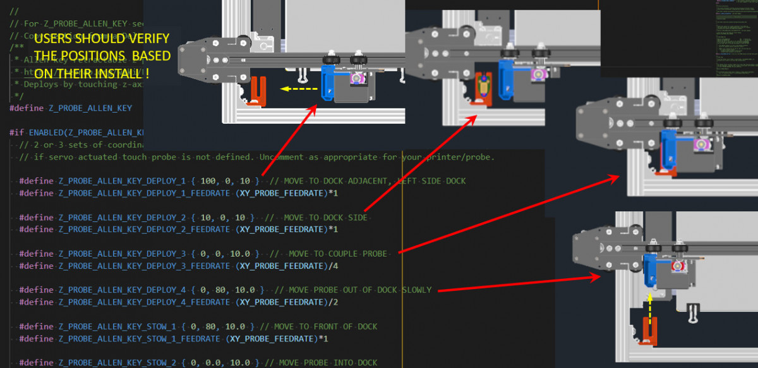
images/02-ender/Deploy.jpg
