euclidprobe/euclidprobe.github.io/images/02-ender/Ender3_Mount_Screw.jpg

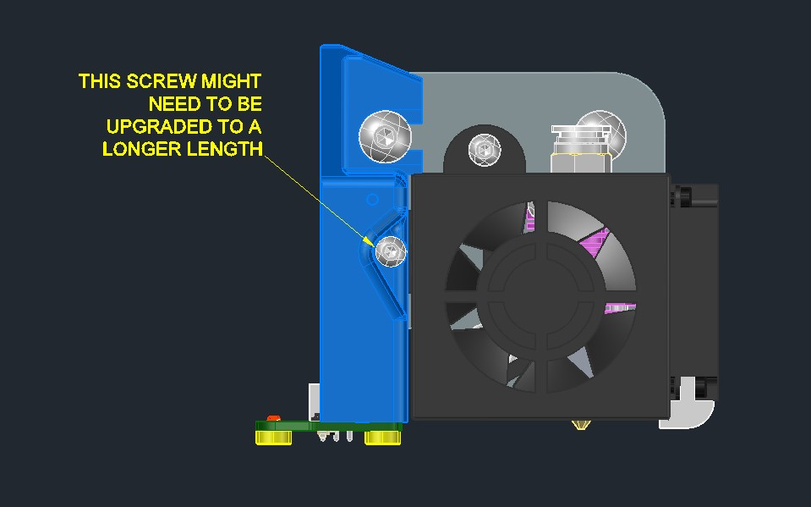
images/02-ender/Ender3_Mount_Screw.jpg
