euclidprobe/euclidprobe.github.io/images/02-ender/Ender5-1-150x150.jpg

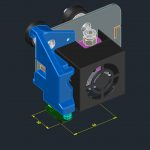
images/02-ender/Ender5-1-150x150.jpg
