euclidprobe/euclidprobe.github.io/images/02-ender/Ender5-263x300.jpg

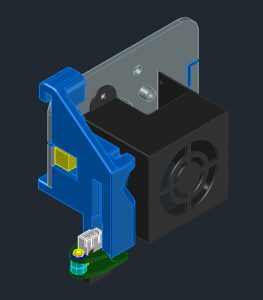
images/02-ender/Ender5-263x300.jpg
