euclidprobe/euclidprobe.github.io/images/02-ender/Ender5Dock-300x214.jpg

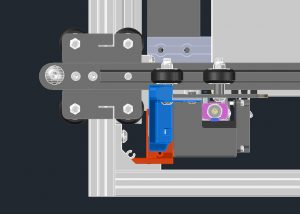
images/02-ender/Ender5Dock-300x214.jpg
