euclidprobe/euclidprobe.github.io/images/02-ender/Ender5Front0.jpg

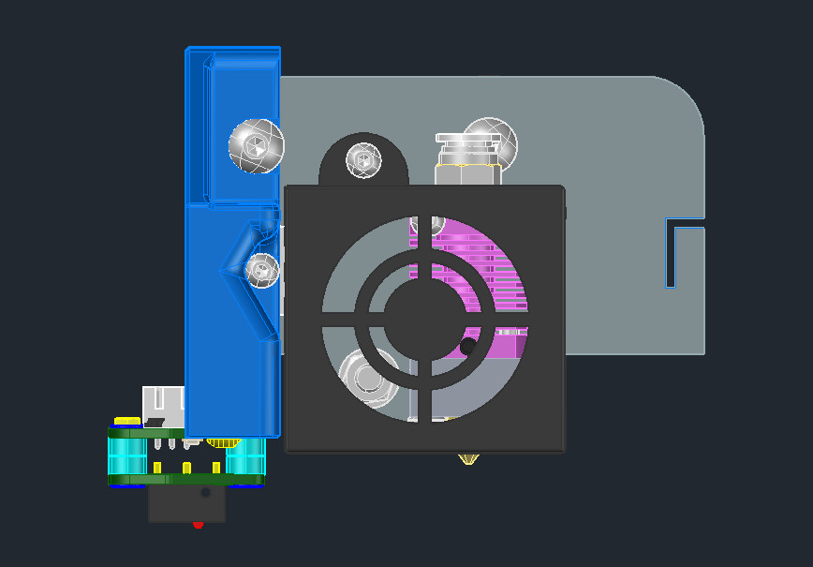
images/02-ender/Ender5Front0.jpg
