euclidprobe/euclidprobe.github.io/images/02-ender/Ender5Front-1-300x229.jpg

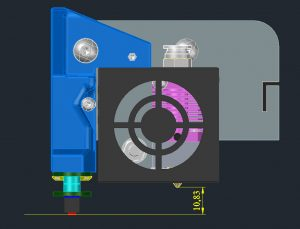
images/02-ender/Ender5Front-1-300x229.jpg
