euclidprobe/euclidprobe.github.io/images/02-ender/Ender5Front-300x271.jpg

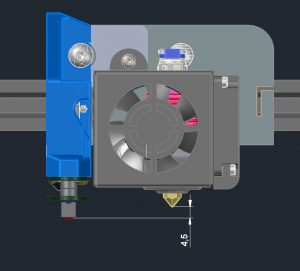
images/02-ender/Ender5Front-300x271.jpg
