euclidprobe/euclidprobe.github.io/images/02-ender/Ender5XRayFront-300x178.jpg

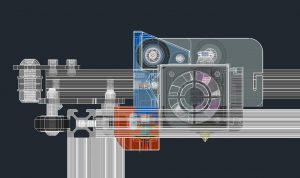
images/02-ender/Ender5XRayFront-300x178.jpg
