euclidprobe/euclidprobe.github.io/images/02-ender/EnderDeployMovments-300x169.jpg

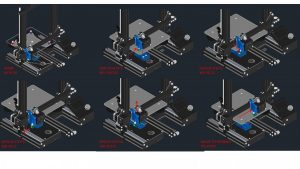
images/02-ender/EnderDeployMovments-300x169.jpg
