euclidprobe/euclidprobe.github.io/images/02-ender/EnderProbeOffsets-300x220.jpg

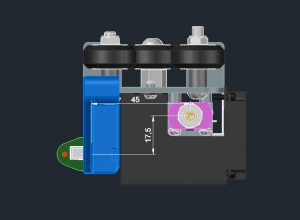
images/02-ender/EnderProbeOffsets-300x220.jpg
