euclidprobe/euclidprobe.github.io/images/02-ender/HDSpacer-150x150.jpg

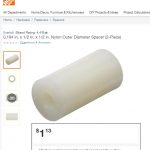
images/02-ender/HDSpacer-150x150.jpg
