euclidprobe/euclidprobe.github.io/images/02-ender/HDSpacer-273x300.jpg

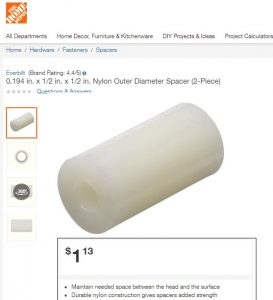
images/02-ender/HDSpacer-273x300.jpg
