euclidprobe/euclidprobe.github.io/images/02-ender/IMG_20220121_100831609_HDR.jpg

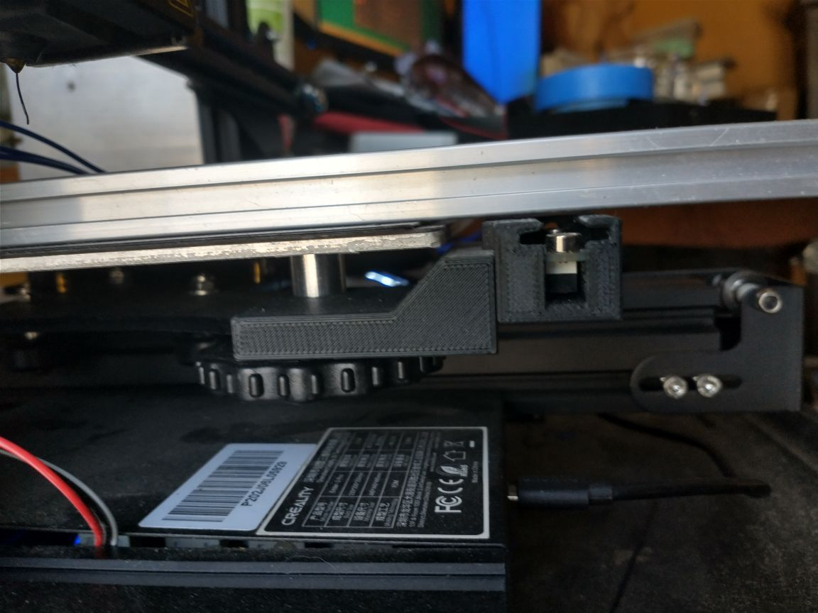
images/02-ender/IMG_20220121_100831609_HDR.jpg
