euclidprobe/euclidprobe.github.io/images/02-ender/M4CouplingNut-150x150.jpg

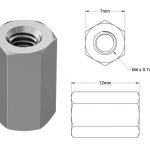
images/02-ender/M4CouplingNut-150x150.jpg
