euclidprobe/euclidprobe.github.io/images/02-ender/M4CouplingNut-300x226.jpg

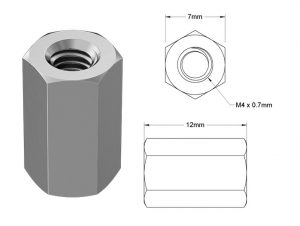
images/02-ender/M4CouplingNut-300x226.jpg
