euclidprobe/euclidprobe.github.io/images/02-ender/Retract.jpg

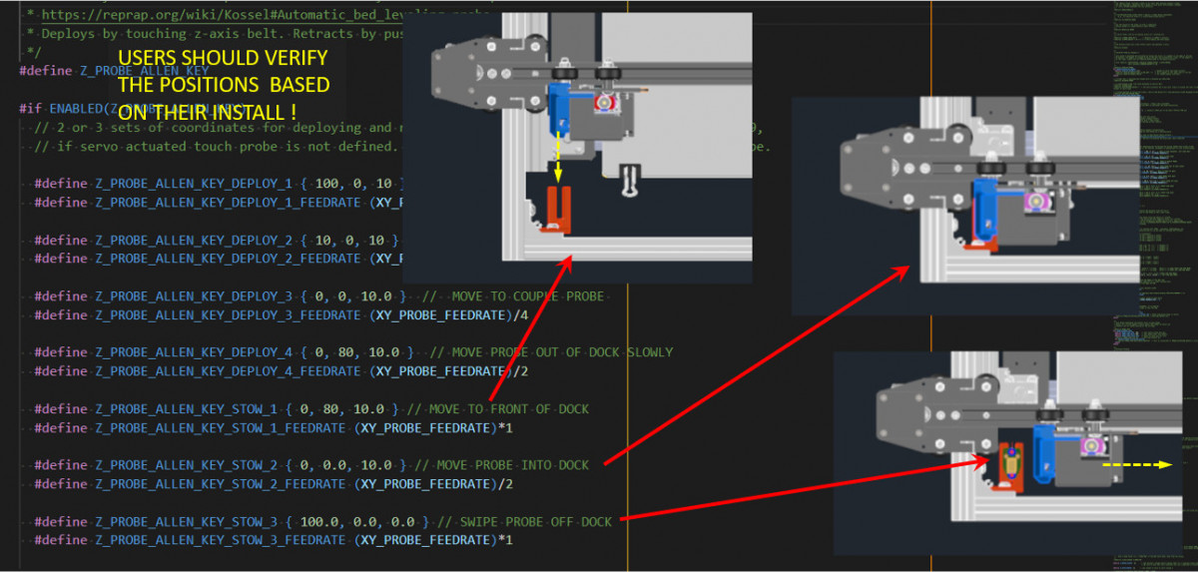
images/02-ender/Retract.jpg
