euclidprobe/euclidprobe.github.io/images/02-ender/unknown.png

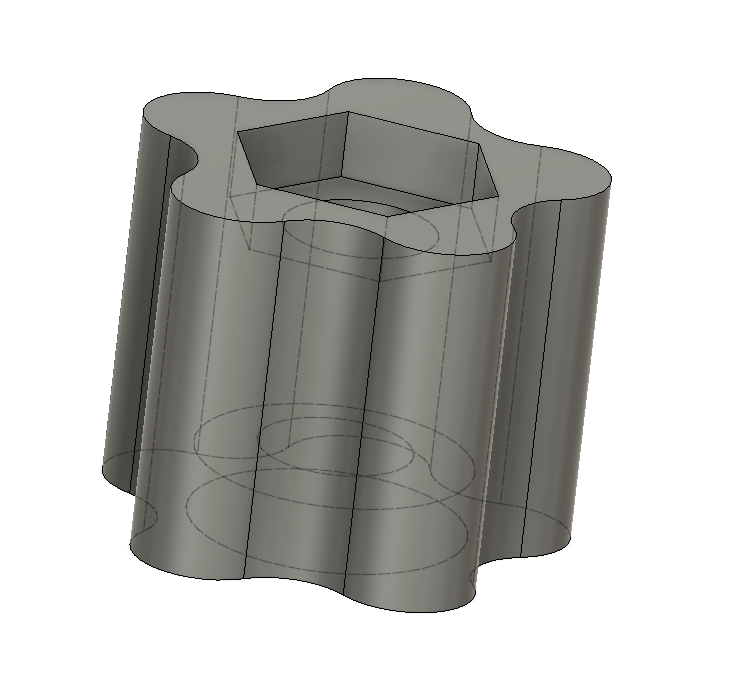
images/02-ender/unknown.png
