euclidprobe/euclidprobe.github.io/images/02-railcore/02_RC_Corner_Dock.png

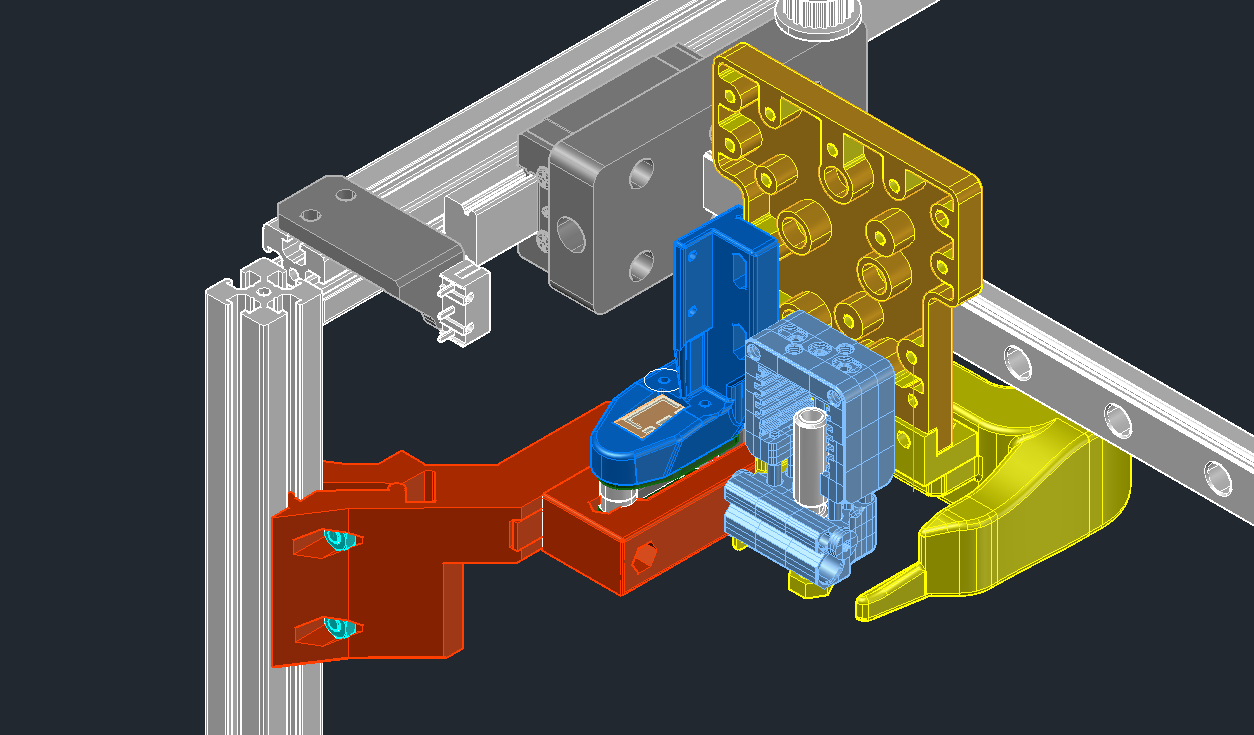
images/02-railcore/02_RC_Corner_Dock.png
