euclidprobe/euclidprobe.github.io/images/02-railcore/jig-01.jpg

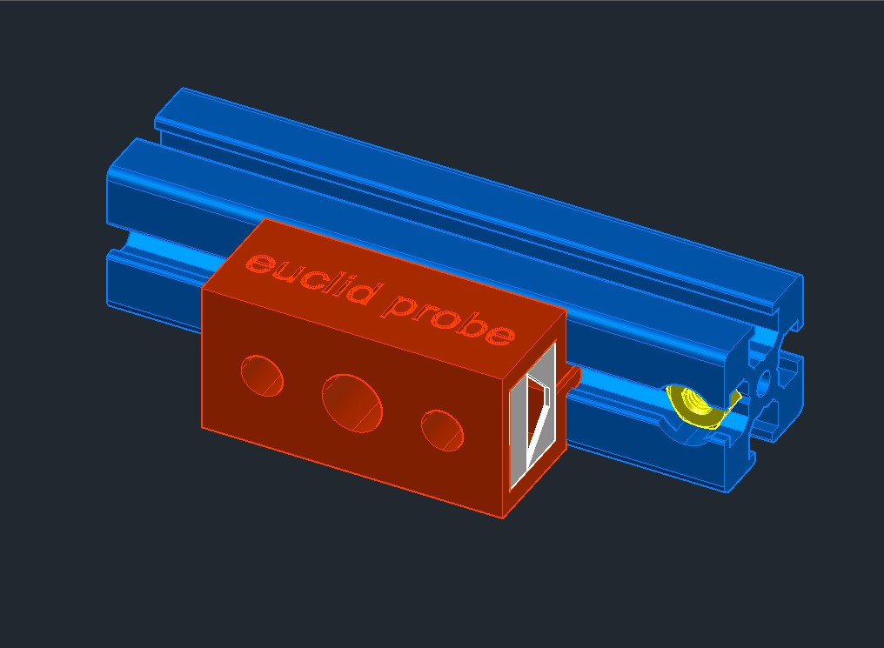
images/02-railcore/jig-01.jpg
