euclidprobe/euclidprobe.github.io/images/02-railcore/jig-02.jpg

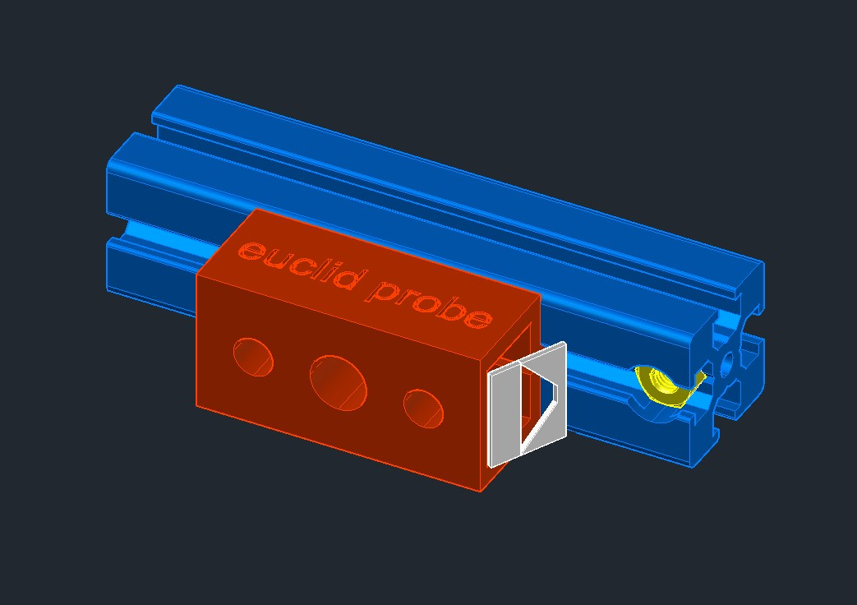
images/02-railcore/jig-02.jpg
