euclidprobe/euclidprobe.github.io/images/02-railcore/jig-03.jpg

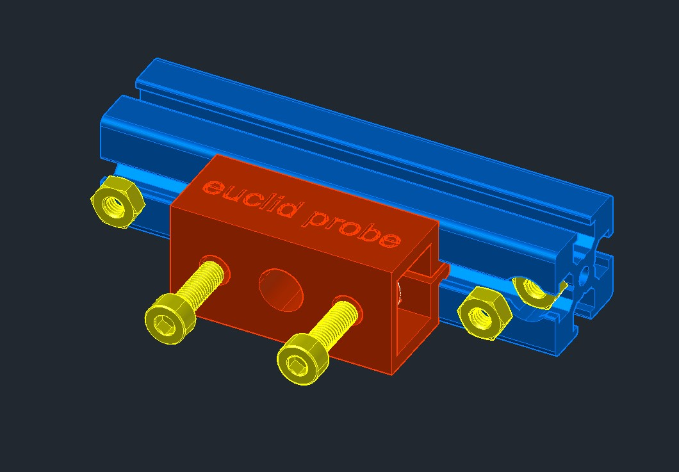
images/02-railcore/jig-03.jpg
