euclidprobe/euclidprobe.github.io/images/02-railcore/jig-04.jpg

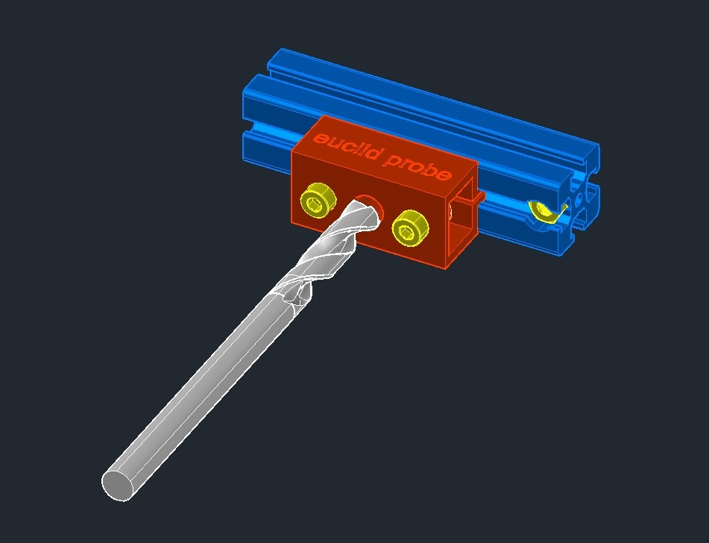
images/02-railcore/jig-04.jpg
