euclidprobe/euclidprobe.github.io/images/02-railcore/PXL_20220415_041242459.jpg

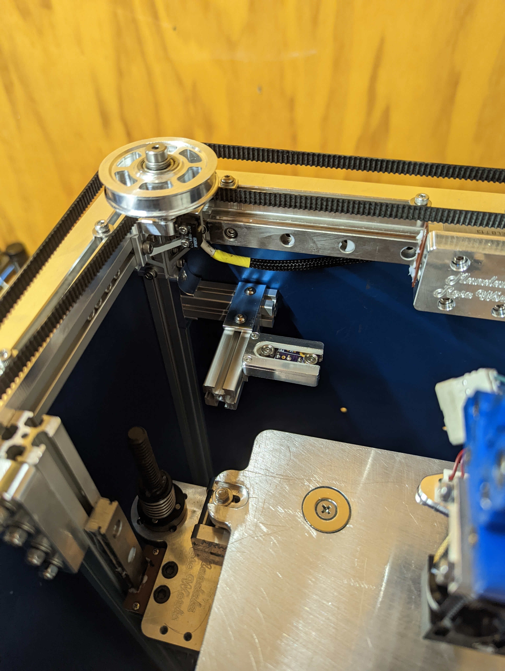
images/02-railcore/PXL_20220415_041242459.jpg
