euclidprobe/euclidprobe.github.io/images/02-railcore/RailCoreCorner713_YElev.jpg

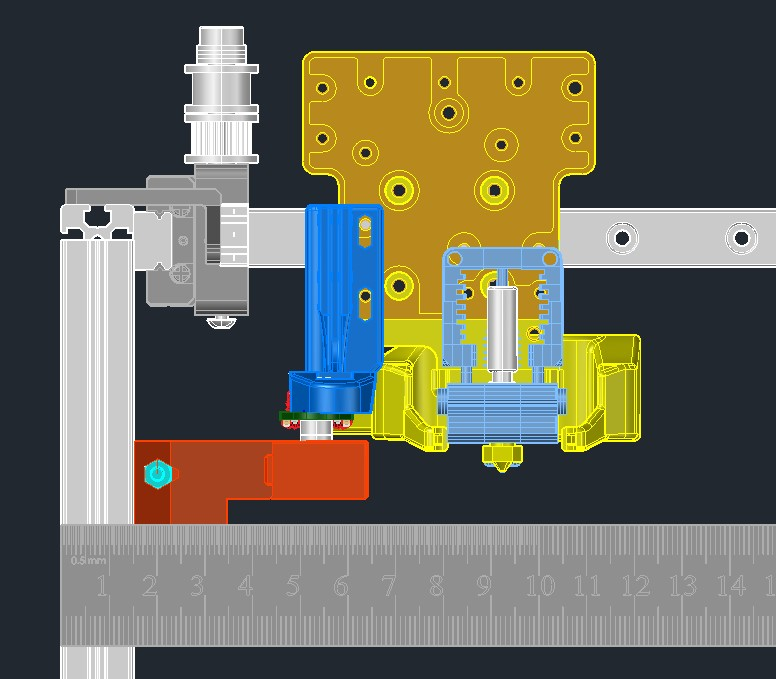
images/02-railcore/RailCoreCorner713_YElev.jpg
