euclidprobe/euclidprobe.github.io/images/02-railcore/RailCoreTopMnt713_YElev.jpg

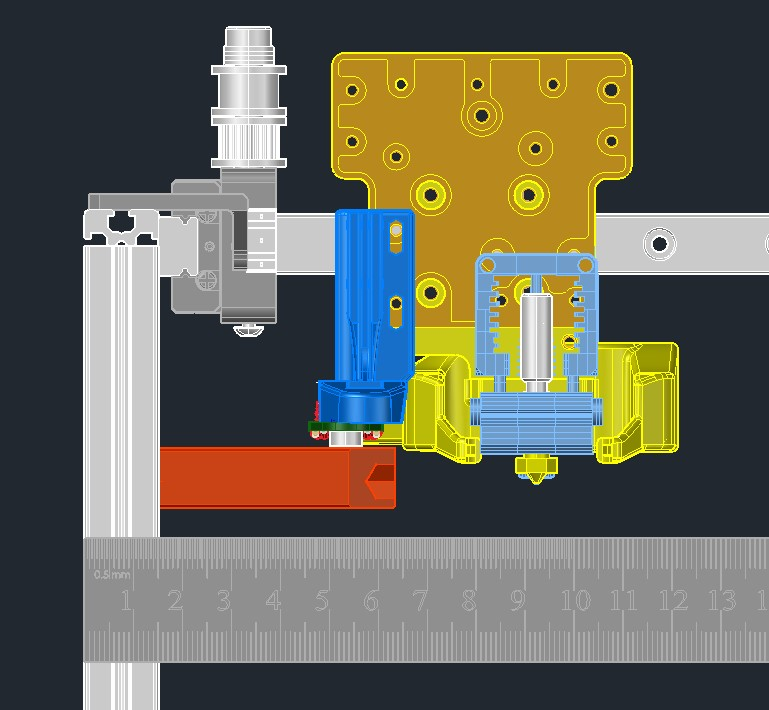
images/02-railcore/RailCoreTopMnt713_YElev.jpg
