euclidprobe/euclidprobe.github.io/images/02-VCore/unknown.png

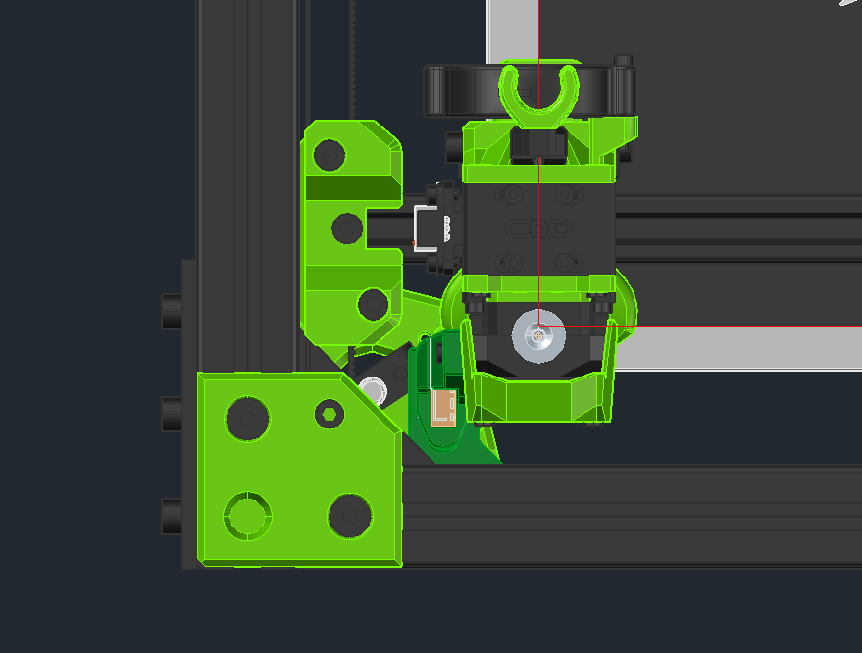
images/02-VCore/unknown.png
