euclidprobe/euclidprobe.github.io/images/02-voron/AD2899C0-A40D-40AC-8573-01F6B85450AD (1).jpg

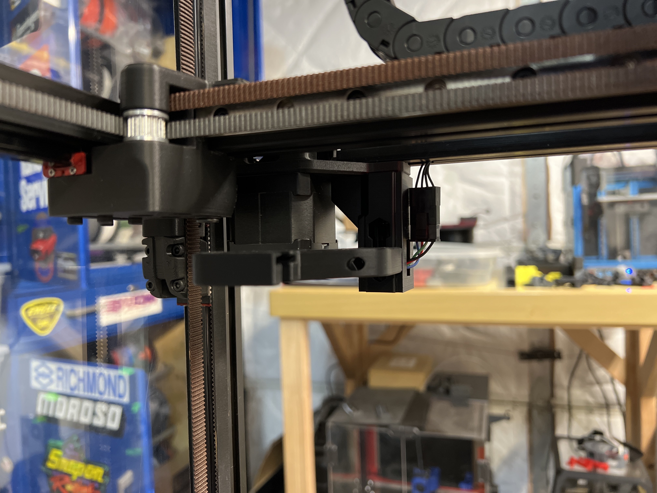
images/02-voron/AD2899C0-A40D-40AC-8573-01F6B85450AD (1).jpg
