euclidprobe/euclidprobe.github.io/images/02-voron/GantryMountV4.png

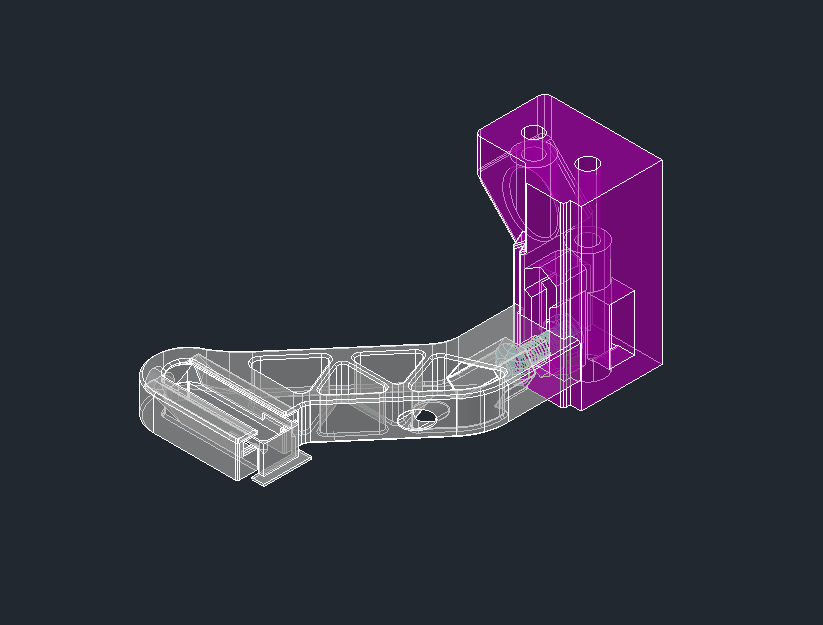
images/02-voron/GantryMountV4.png
