euclidprobe/euclidprobe.github.io/images/02-voron/image_from_ios.jpg

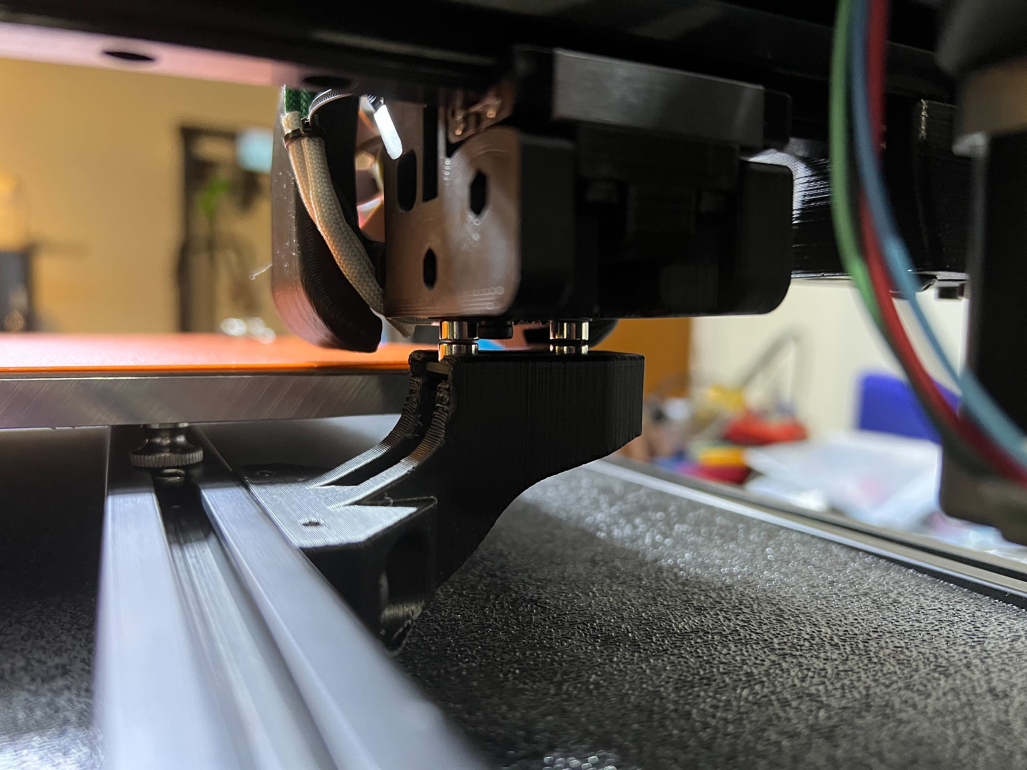
images/02-voron/image_from_ios.jpg
