euclidprobe/euclidprobe.github.io/images/02-voron/IMG_20220428_175241915.jpg

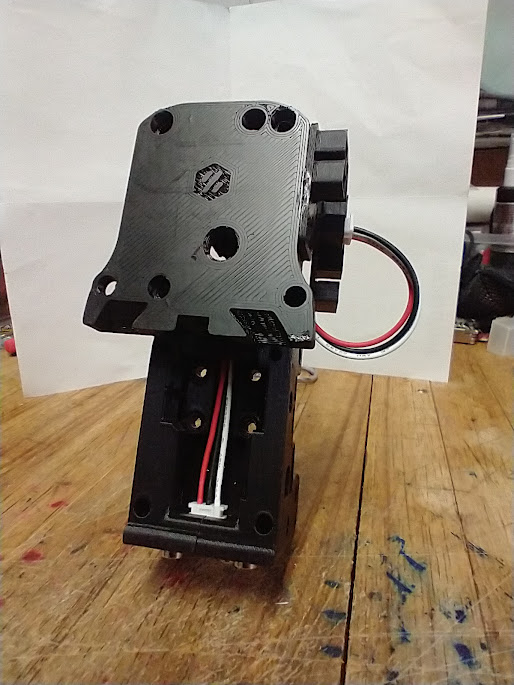
images/02-voron/IMG_20220428_175241915.jpg
