euclidprobe/euclidprobe.github.io/images/02-voron/IMG_20220428_175304532.jpg

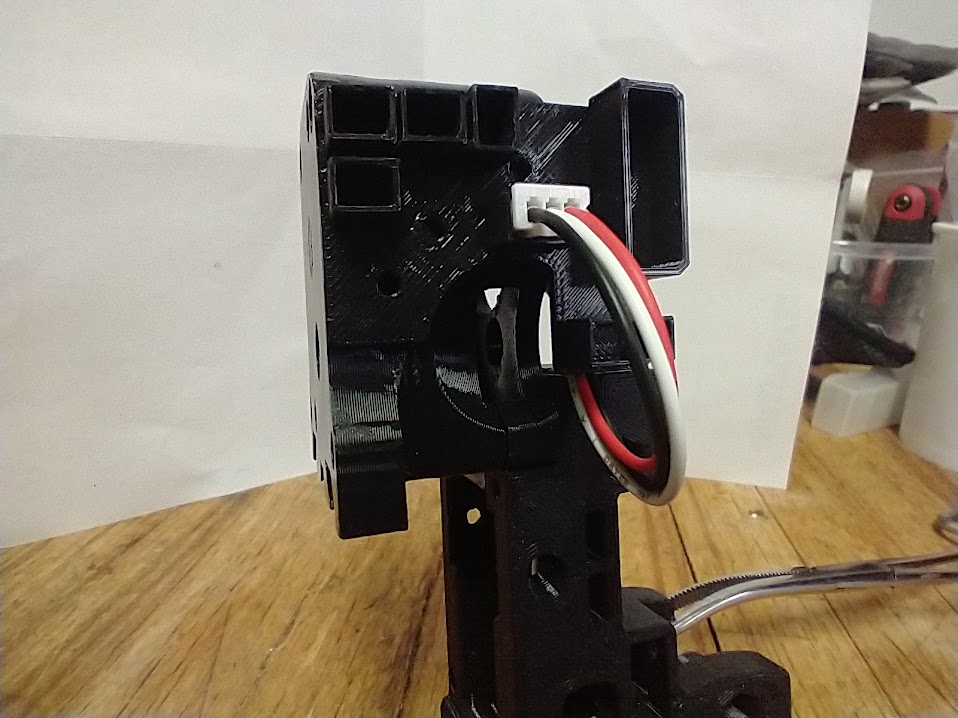
images/02-voron/IMG_20220428_175304532.jpg
