euclidprobe/euclidprobe.github.io/images/02-voron/v6cl.png

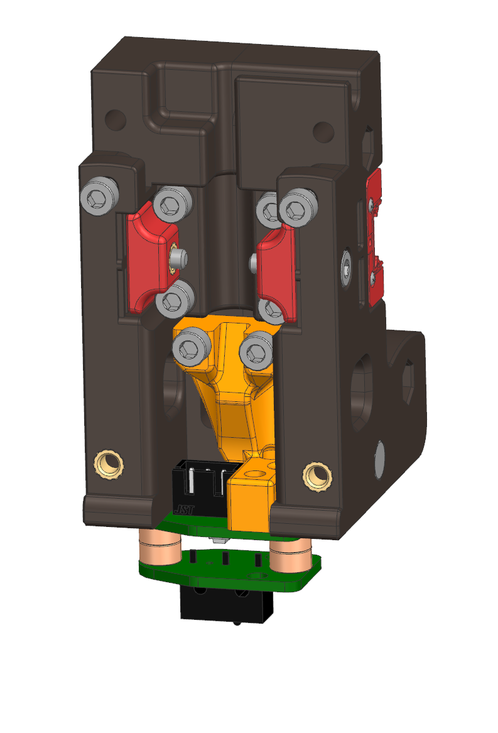
images/02-voron/v6cl.png
