euclidprobe/euclidprobe.github.io/images/02-voron/v6cl_dtl.png

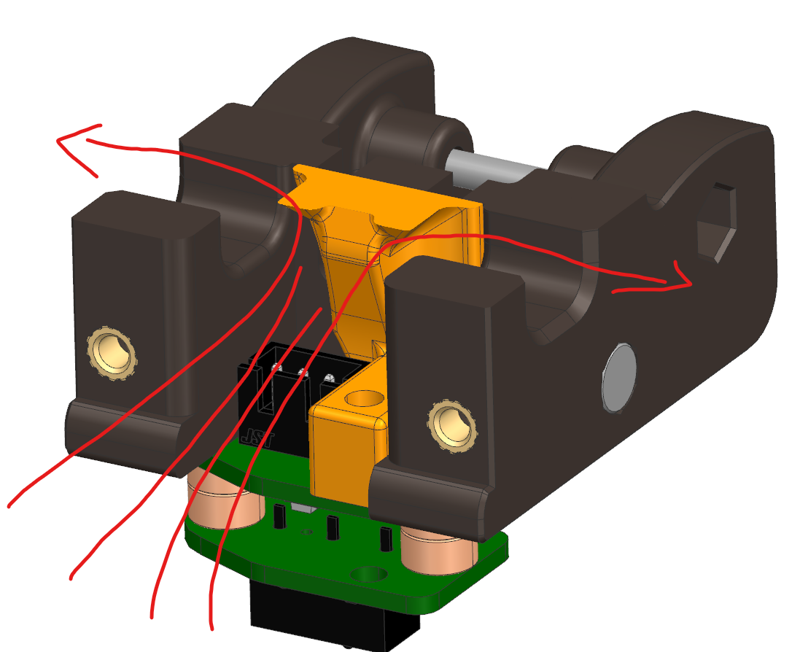
images/02-voron/v6cl_dtl.png
