euclidprobe/euclidprobe.github.io/images/02-voron/VoronGantryMountRev1.1Mirrored2.jpg

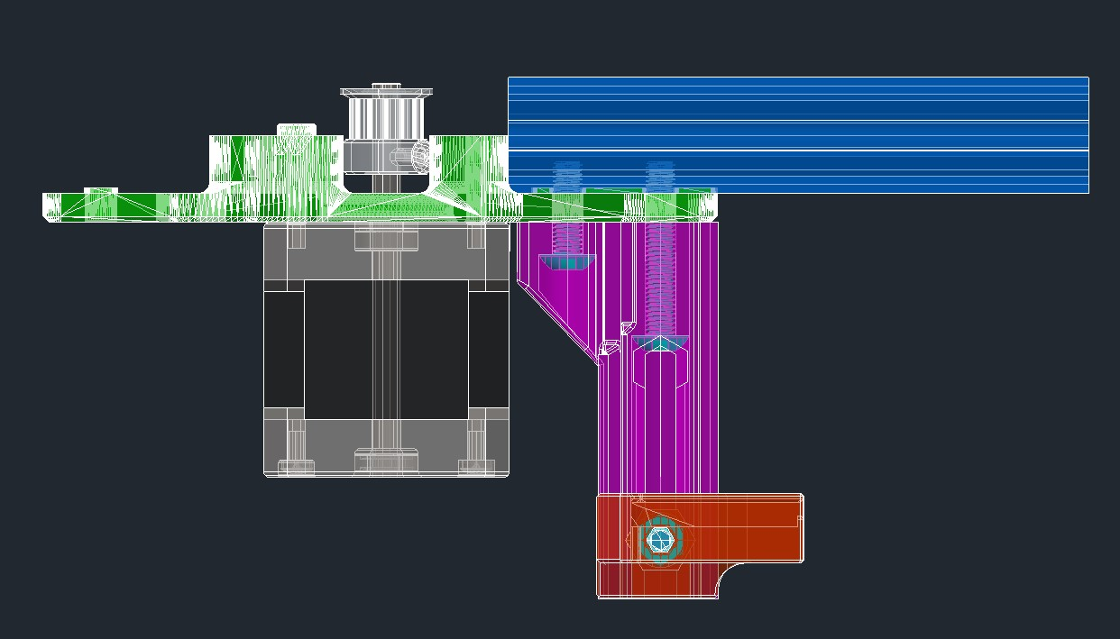
images/02-voron/VoronGantryMountRev1.1Mirrored2.jpg
