euclidprobe/euclidprobe.github.io/images/02-voron/VoronGantryMountRev1.1Mirrored.jpg

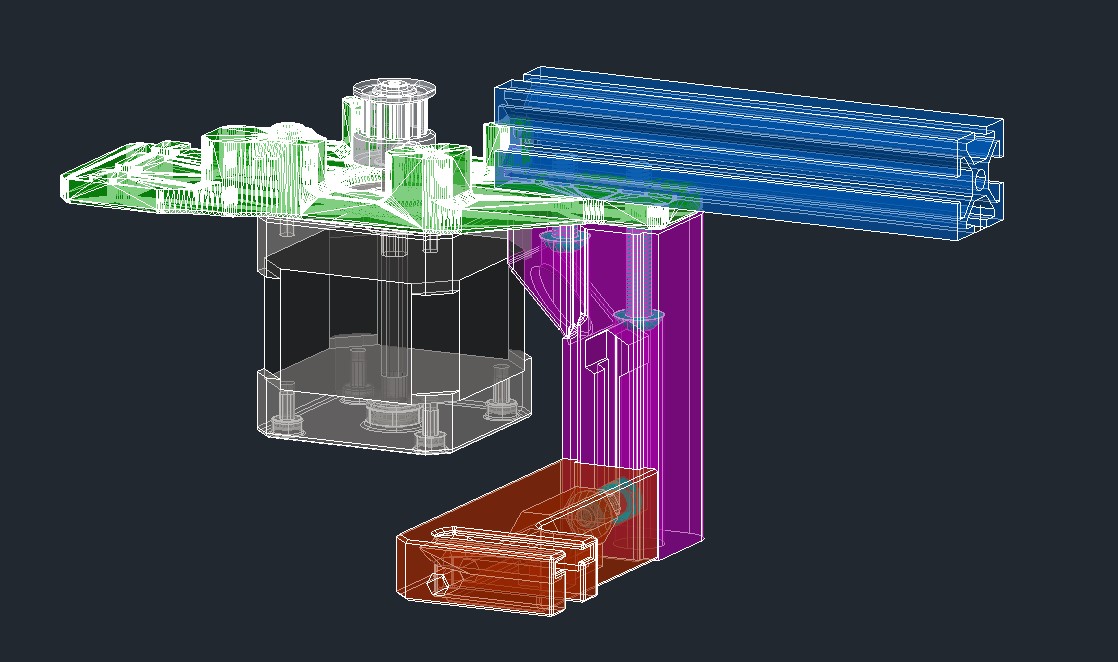
images/02-voron/VoronGantryMountRev1.1Mirrored.jpg
