euclidprobe/euclidprobe.github.io/images/02-voron/VoronGantryMountRev1.5.jpg

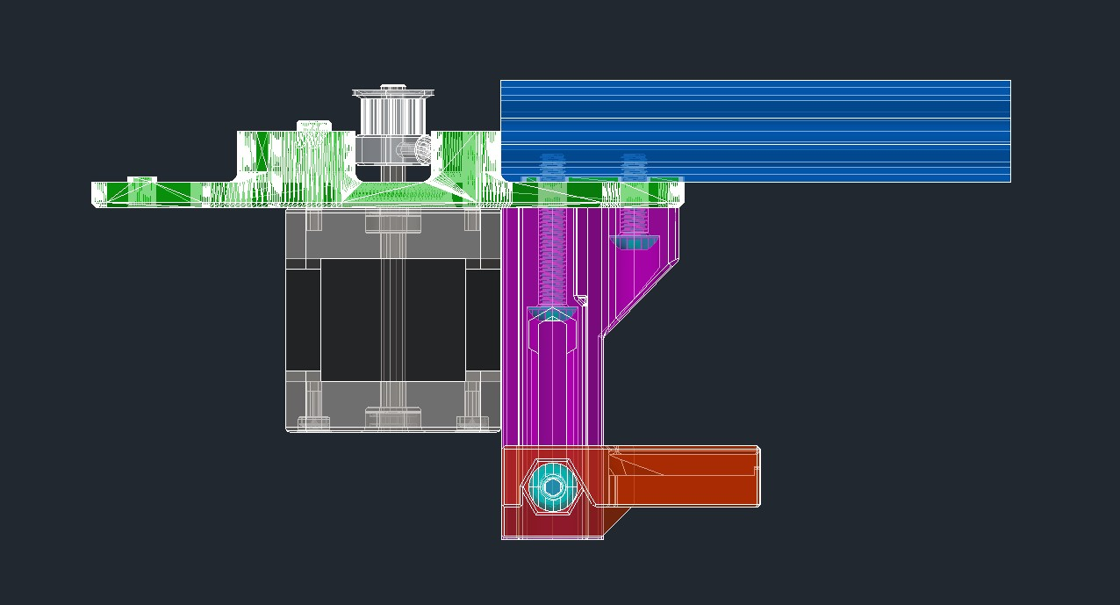
images/02-voron/VoronGantryMountRev1.5.jpg
