euclidprobe/euclidprobe.github.io/images/02-voron/VoronGantryMountRev2.jpg

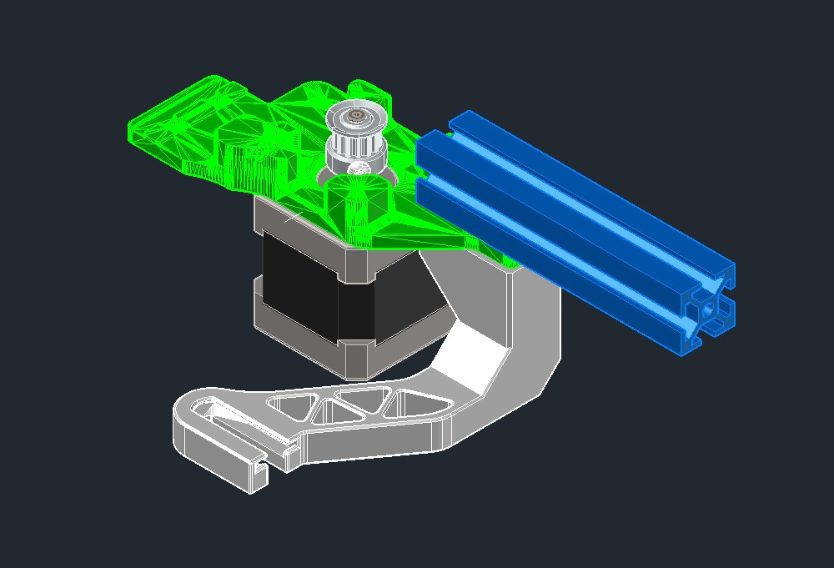
images/02-voron/VoronGantryMountRev2.jpg
