euclidprobe/euclidprobe.github.io/images/02_Dock_Alignment.jpg

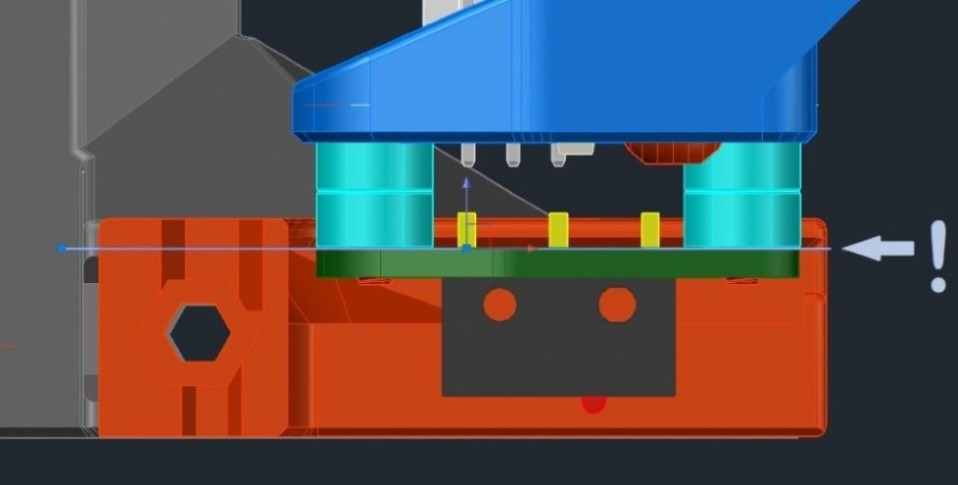
images/02_Dock_Alignment.jpg
