euclidprobe/euclidprobe.github.io/images/02_dock_entry.jpg

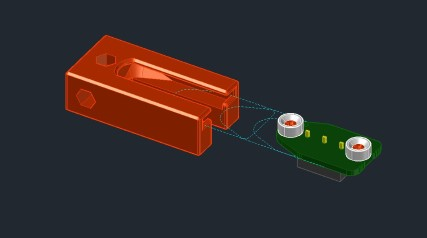
images/02_dock_entry.jpg
