euclidprobe/euclidprobe.github.io/images/02_Dock_Height_2.jpg

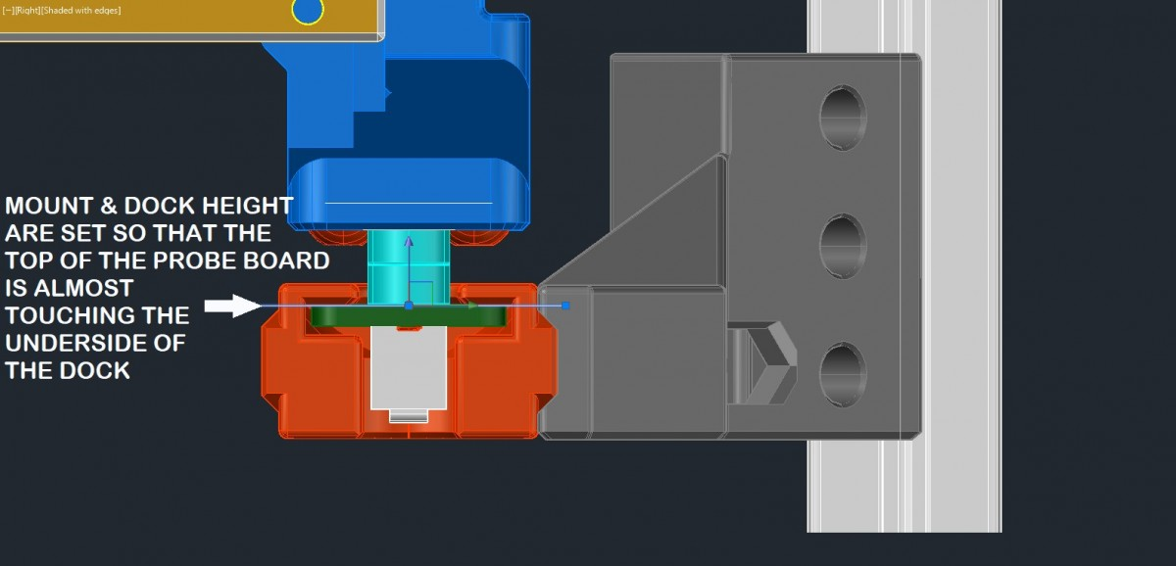
images/02_Dock_Height_2.jpg
