euclidprobe/euclidprobe.github.io/images/02_Ender3_probe_dock.jpg

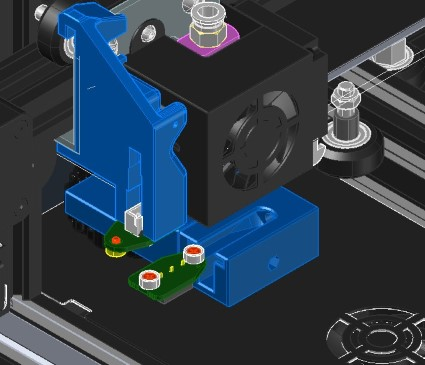
images/02_Ender3_probe_dock.jpg
