euclidprobe/euclidprobe.github.io/images/02_Ender5.jpg

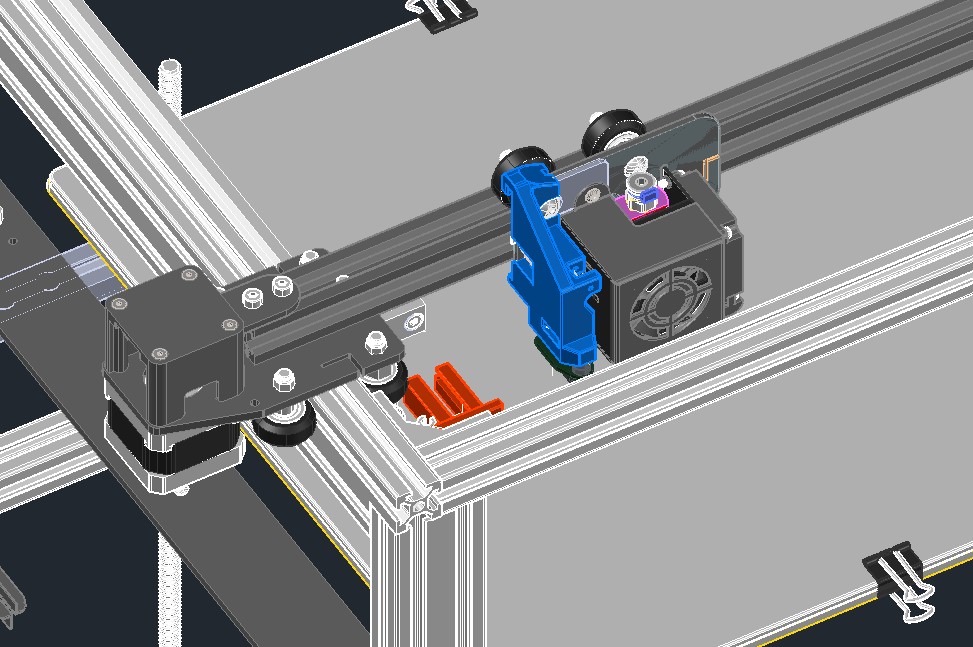
images/02_Ender5.jpg
