euclidprobe/euclidprobe.github.io/images/02_Front-Probe.png

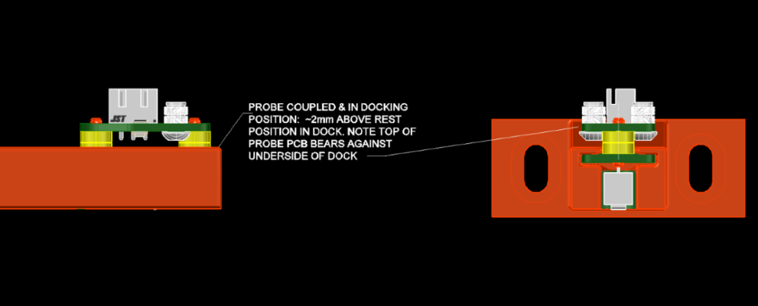
images/02_Front-Probe.png
