euclidprobe/euclidprobe.github.io/images/02_Front-Undocked.png

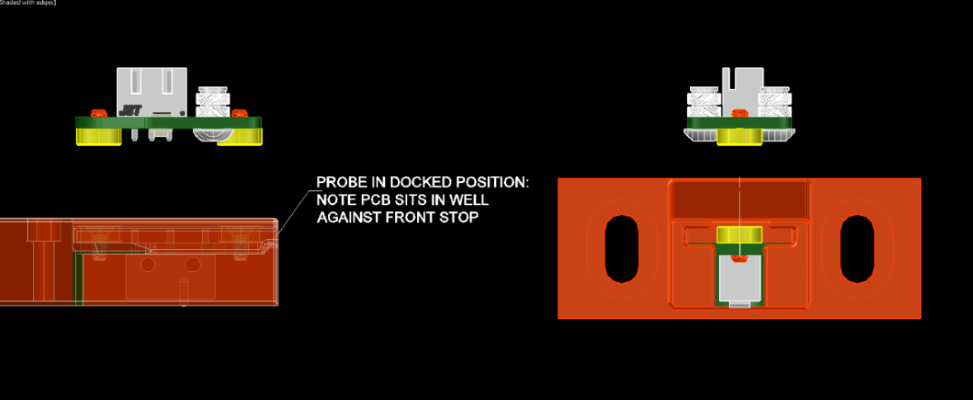
images/02_Front-Undocked.png
