euclidprobe/euclidprobe.github.io/images/02_linear_stage.jpg

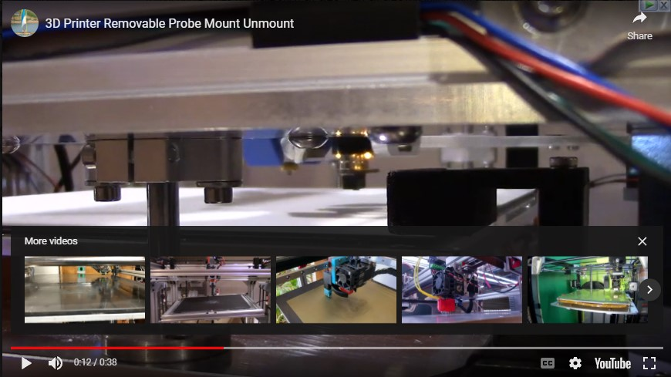
images/02_linear_stage.jpg
