euclidprobe/euclidprobe.github.io/images/02_linear_stageB.jpg

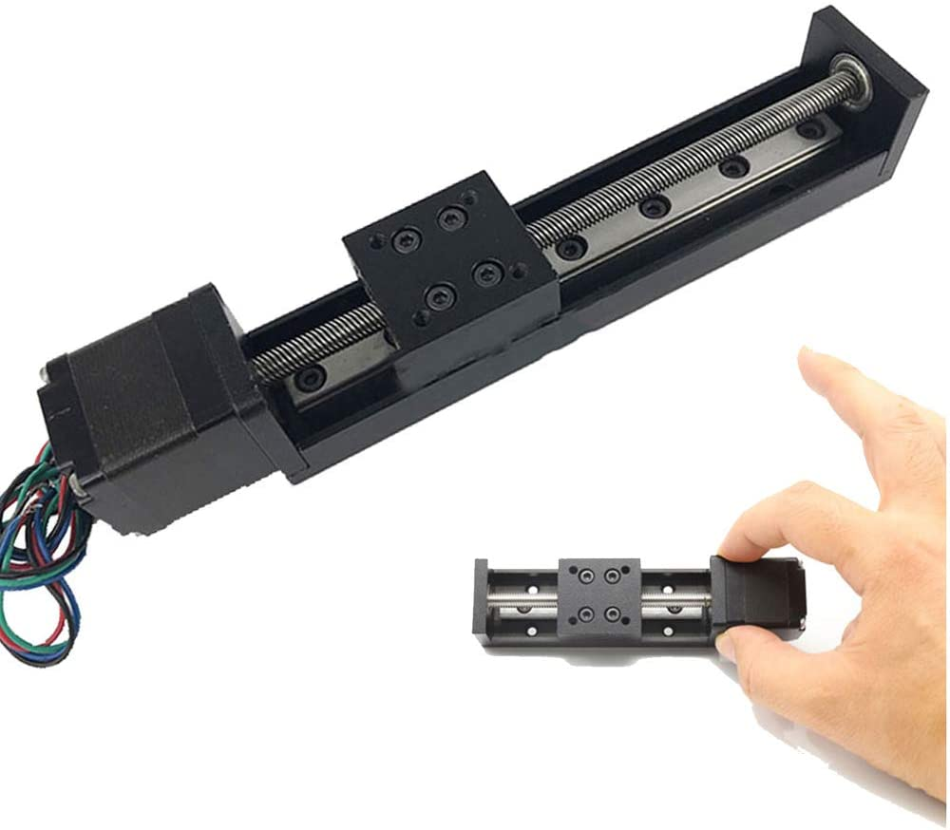
images/02_linear_stageB.jpg
