euclidprobe/euclidprobe.github.io/images/02_ProbeDockPIP_201x300.jpg

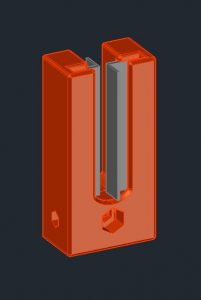
images/02_ProbeDockPIP_201x300.jpg
