euclidprobe/euclidprobe.github.io/images/02_ProbeDockRegBossPIP_201x300.jpg

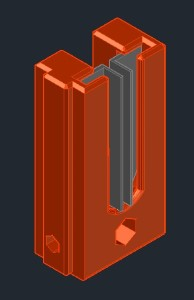
images/02_ProbeDockRegBossPIP_201x300.jpg
