euclidprobe/euclidprobe.github.io/images/02_ProbeV4_model1.jpg

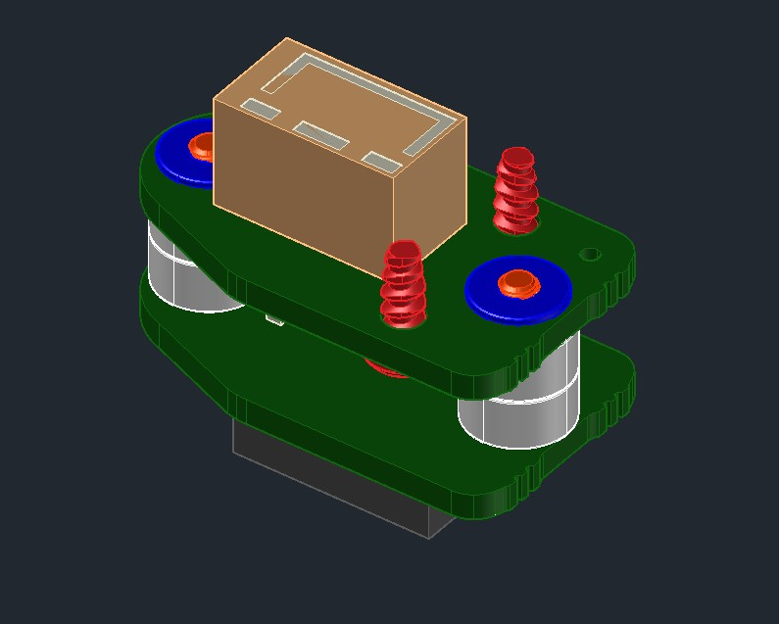
images/02_ProbeV4_model1.jpg
