euclidprobe/euclidprobe.github.io/images/02_ProbeV4_model2.jpg

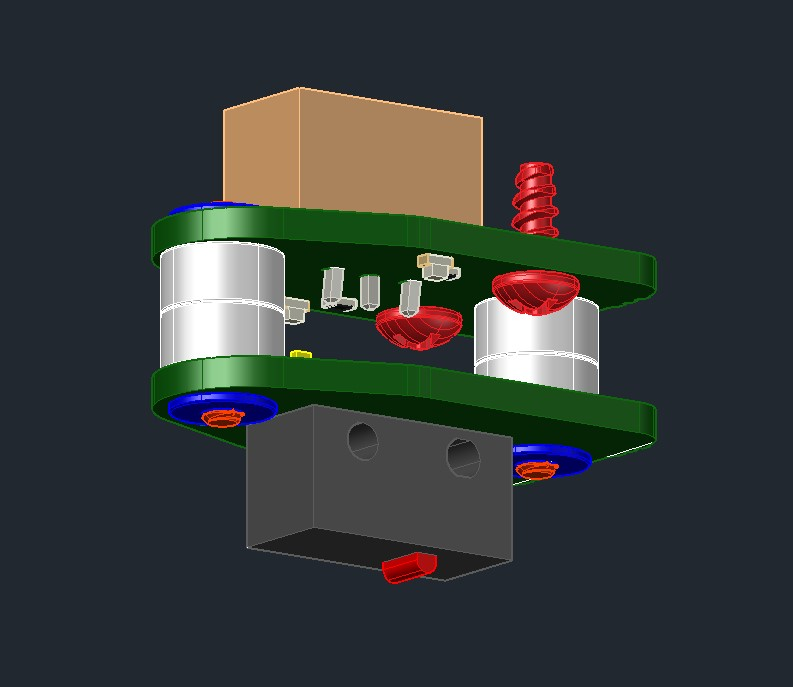
images/02_ProbeV4_model2.jpg
