euclidprobe/euclidprobe.github.io/images/02_RC_Corner.jpg

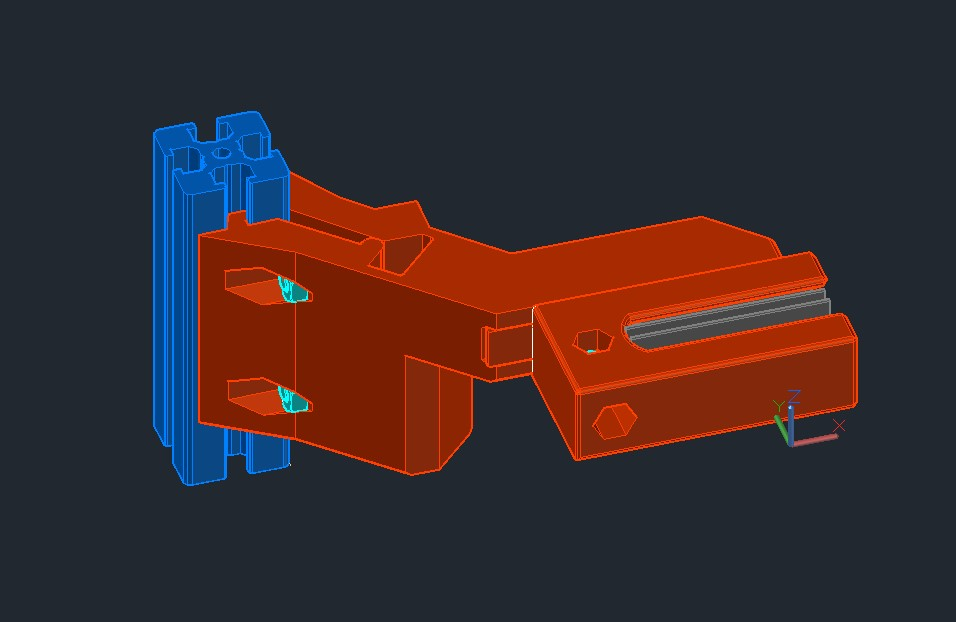
images/02_RC_Corner.jpg
