euclidprobe/euclidprobe.github.io/images/02_RC_Mount.jpg

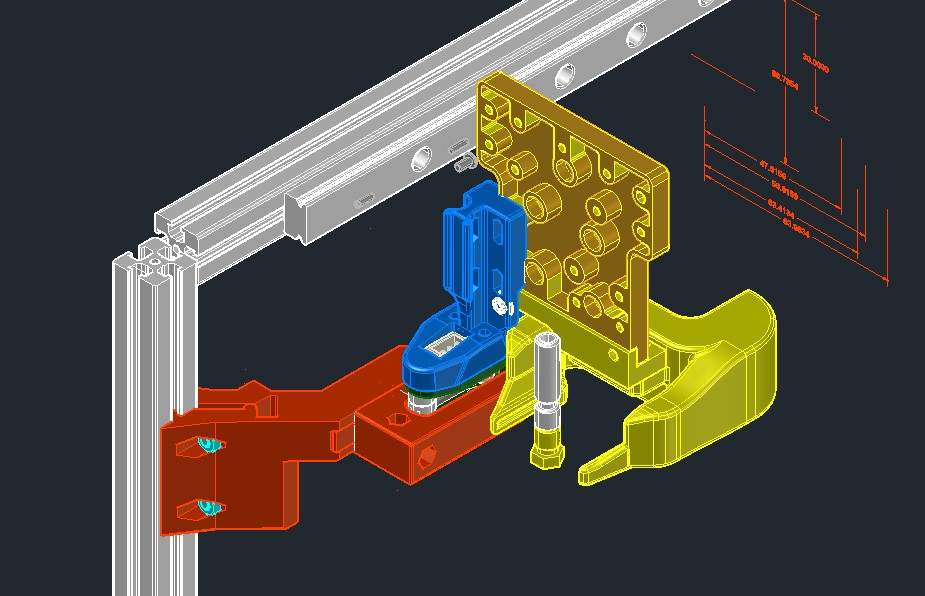
images/02_RC_Mount.jpg
