euclidprobe/euclidprobe.github.io/images/02_Voron2.4BedMountL.png

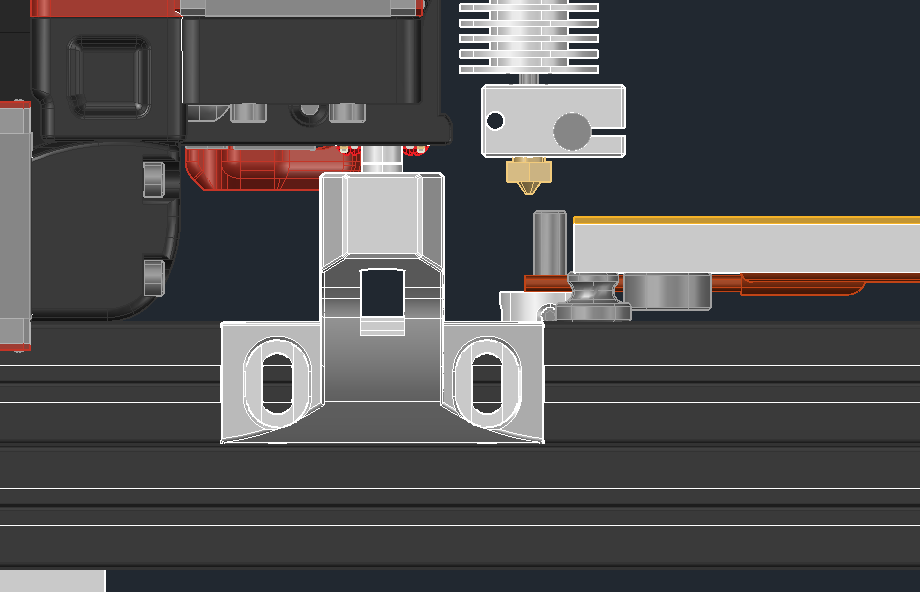
images/02_Voron2.4BedMountL.png
