euclidprobe/euclidprobe.github.io/images/03-4020Fan01-150x150.jpg

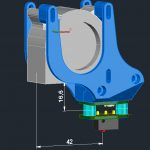
images/03-4020Fan01-150x150.jpg
