euclidprobe/euclidprobe.github.io/images/03-4020Fan02-150x150.jpg

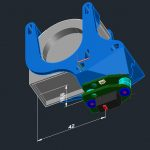
images/03-4020Fan02-150x150.jpg
