euclidprobe/euclidprobe.github.io/images/03-5015FanMount02.jpg

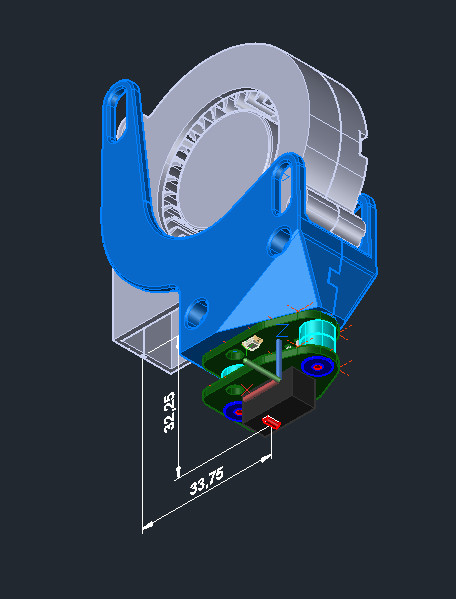
images/03-5015FanMount02.jpg
