euclidprobe/euclidprobe.github.io/images/03-5015FanMount-1-220x300.jpg

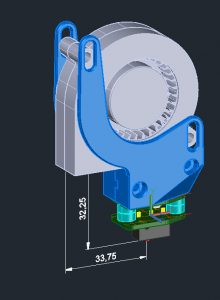
images/03-5015FanMount-1-220x300.jpg
