euclidprobe/euclidprobe.github.io/images/03-5015FanMount-2-150x150.jpg

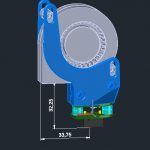
images/03-5015FanMount-2-150x150.jpg
