euclidprobe/euclidprobe.github.io/images/03-5015FanMount-2-241x300.jpg

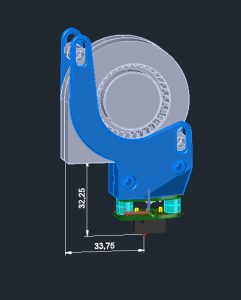
images/03-5015FanMount-2-241x300.jpg
