euclidprobe/euclidprobe.github.io/images/03-Grafting_Mount1-300x291.png

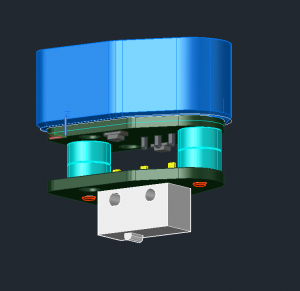
images/03-Grafting_Mount1-300x291.png
