euclidprobe/euclidprobe.github.io/images/03-Grafting_Mount2-300x290.png

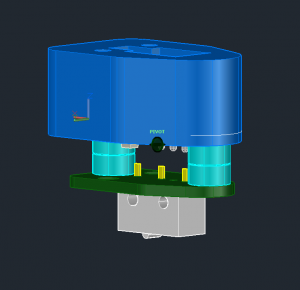
images/03-Grafting_Mount2-300x290.png
