euclidprobe/euclidprobe.github.io/images/03-GraftingDockFlush-150x150.jpg

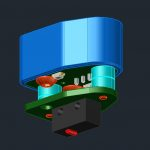
images/03-GraftingDockFlush-150x150.jpg
