euclidprobe/euclidprobe.github.io/images/03-GraftingDockFlush.jpg

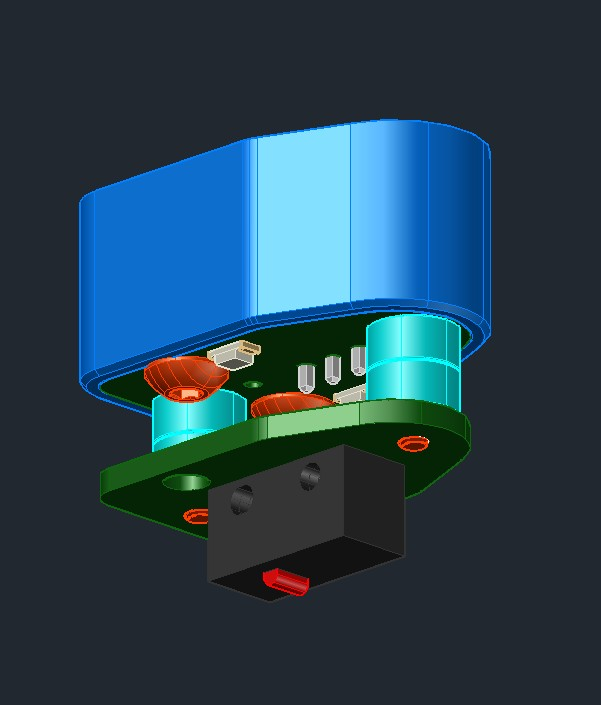
images/03-GraftingDockFlush.jpg
