euclidprobe/euclidprobe.github.io/images/03-GraftingDockSurface-150x150.jpg

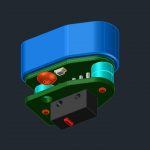
images/03-GraftingDockSurface-150x150.jpg
