euclidprobe/euclidprobe.github.io/images/03-MOUNT-MINWALL-1024x620.jpg

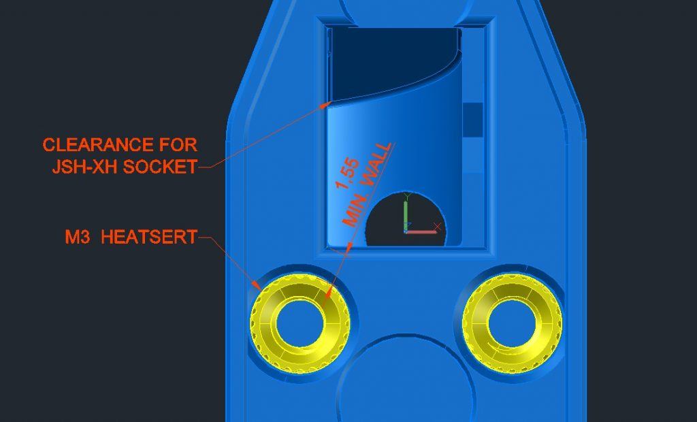
images/03-MOUNT-MINWALL-1024x620.jpg
