euclidprobe/euclidprobe.github.io/images/03/EBB36 CAN V1.0-PIN.png

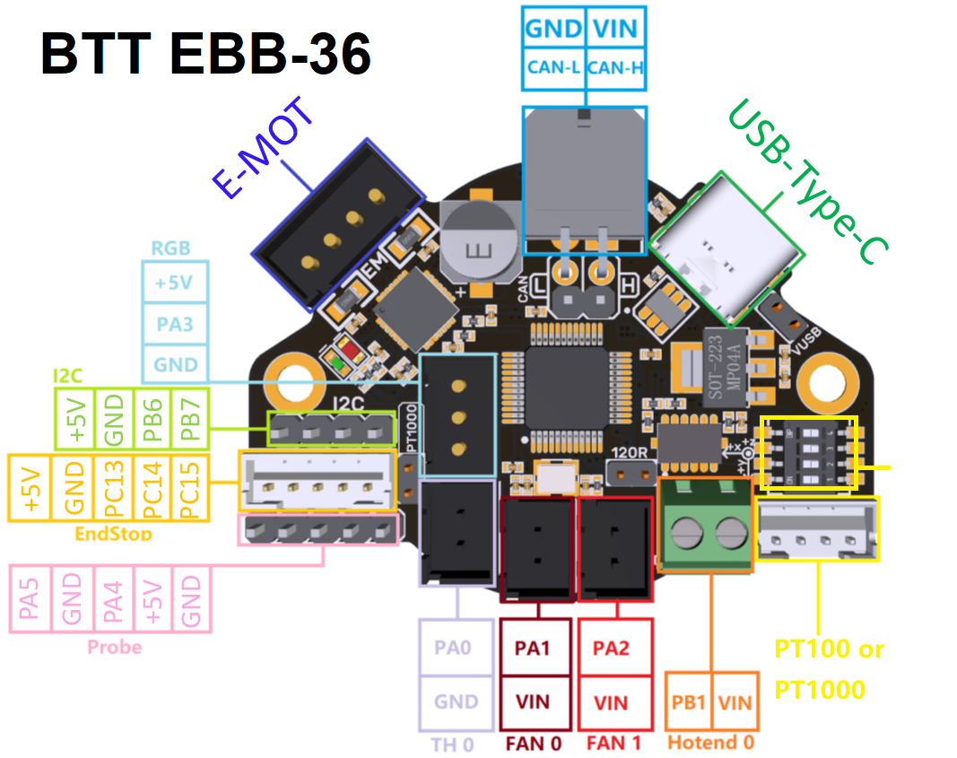
images/03/EBB36 CAN V1.0-PIN.png
