euclidprobe/euclidprobe.github.io/images/03/EBB42 CAN V1.0-PIN.png

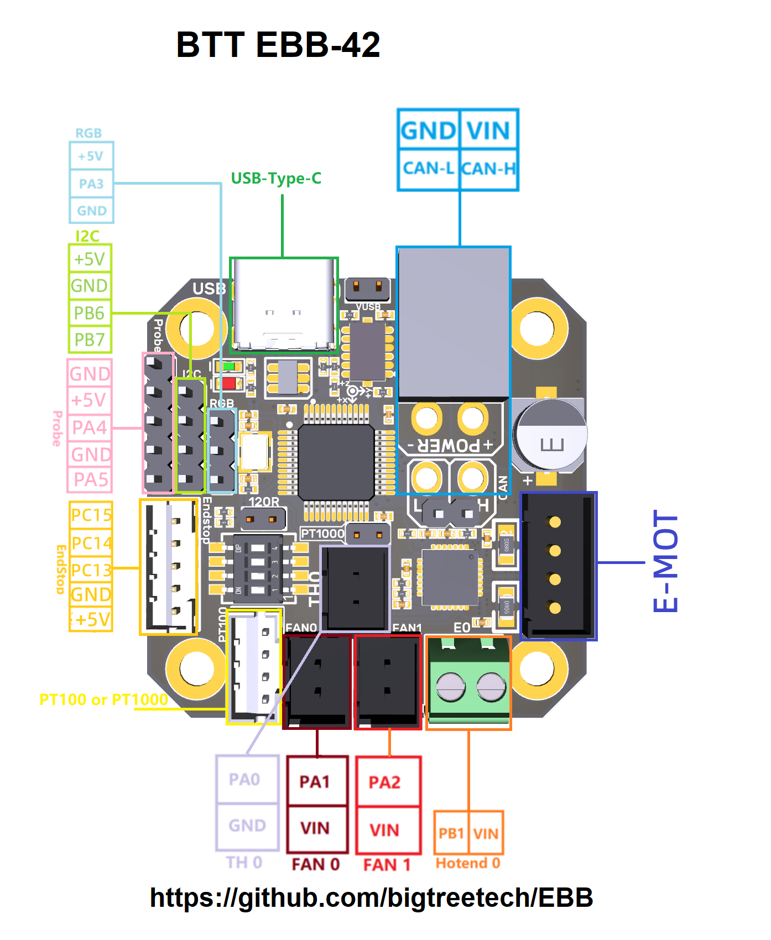
images/03/EBB42 CAN V1.0-PIN.png
