euclidprobe/euclidprobe.github.io/images/03/fly_2040.jpg

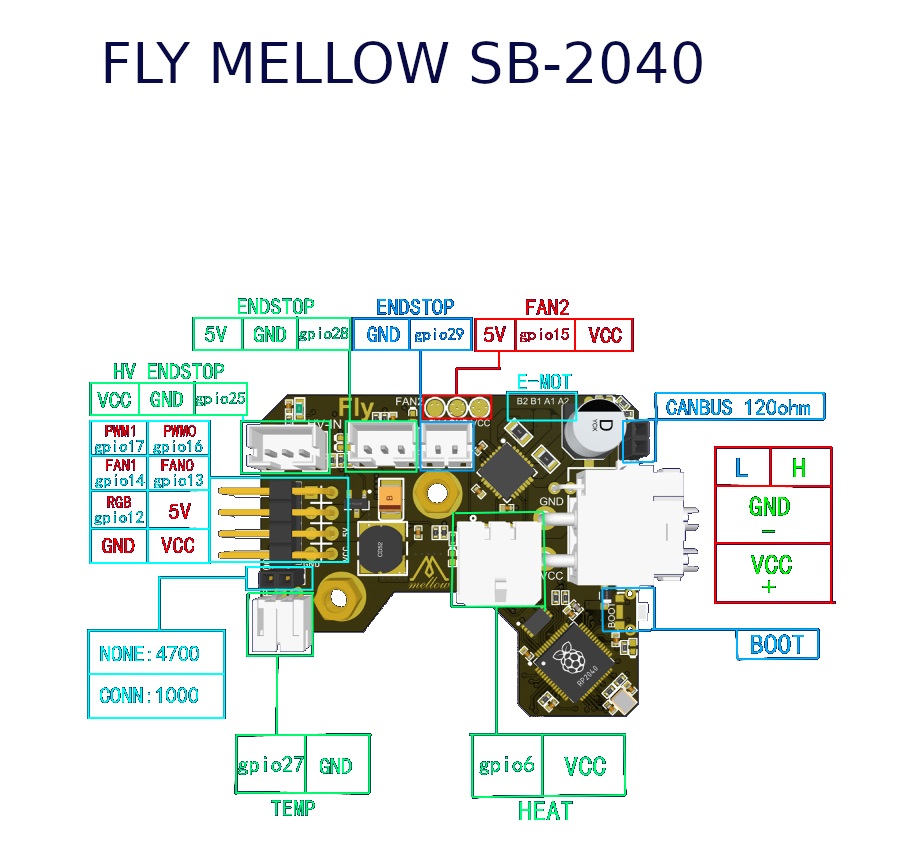
images/03/fly_2040.jpg
