euclidprobe/euclidprobe.github.io/images/03/fly_SHT-36.jpg

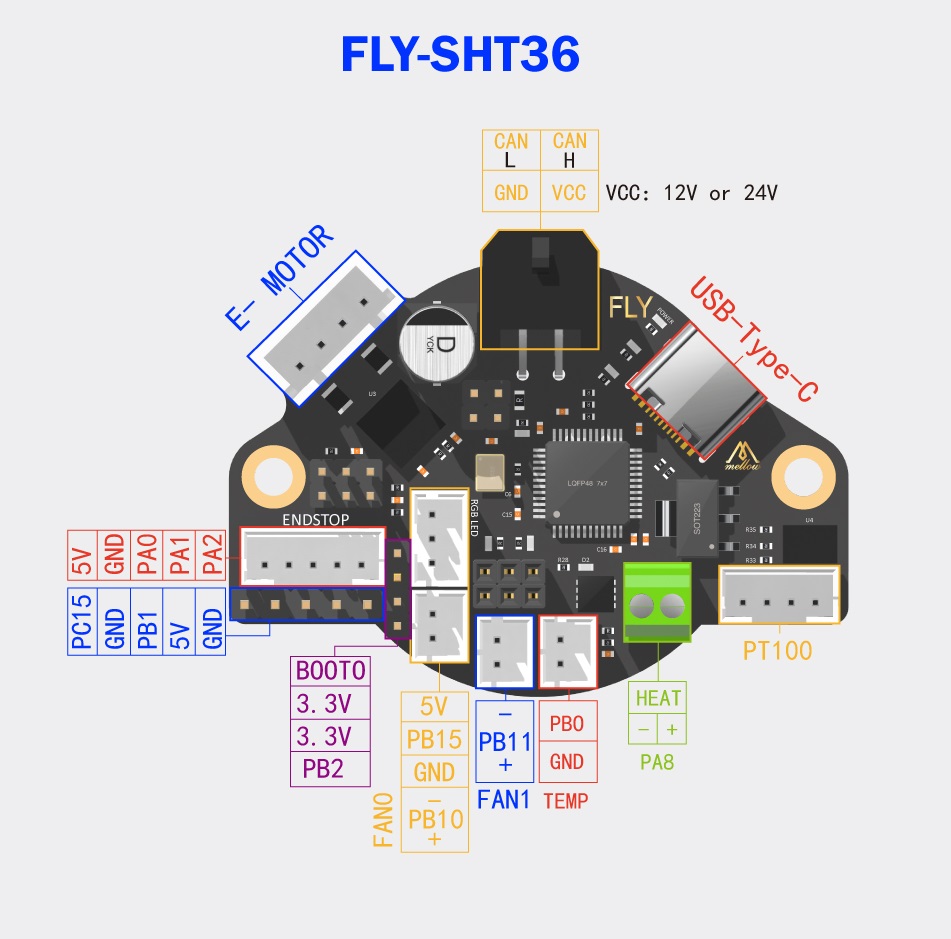
images/03/fly_SHT-36.jpg
