euclidprobe/euclidprobe.github.io/images/03/fly_SHT-42.jpg

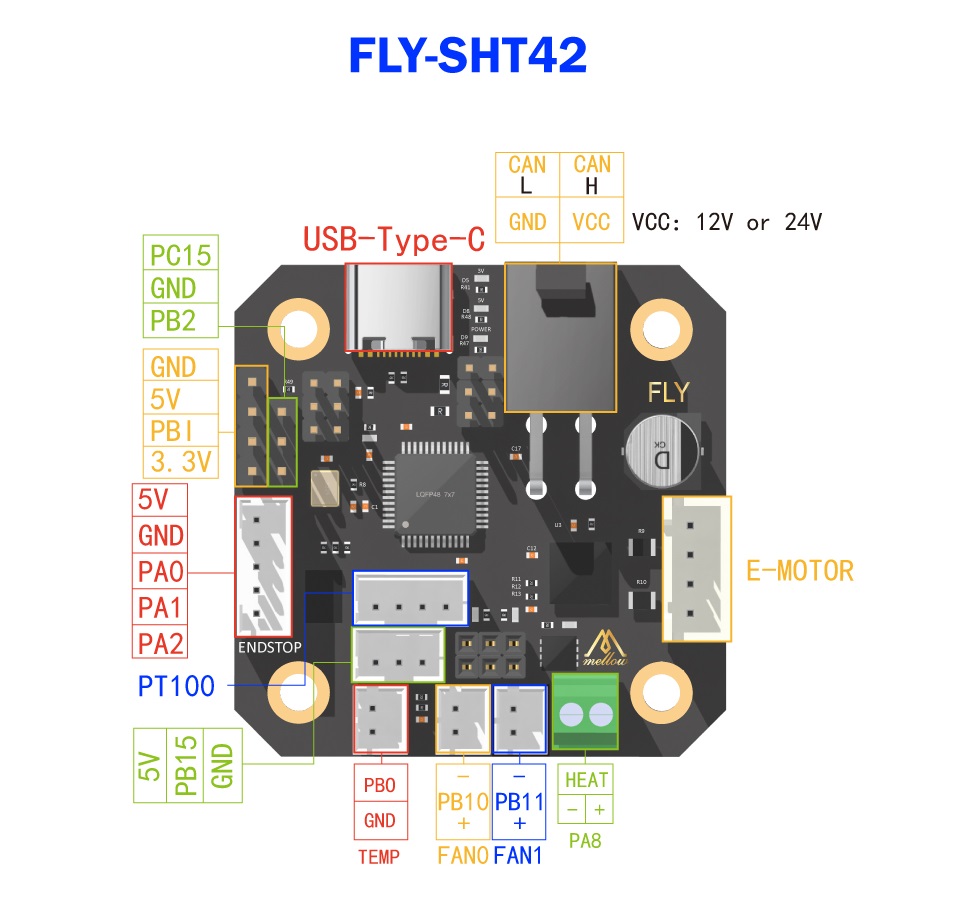
images/03/fly_SHT-42.jpg
