euclidprobe/euclidprobe.github.io/images/03/Slide3.PNG

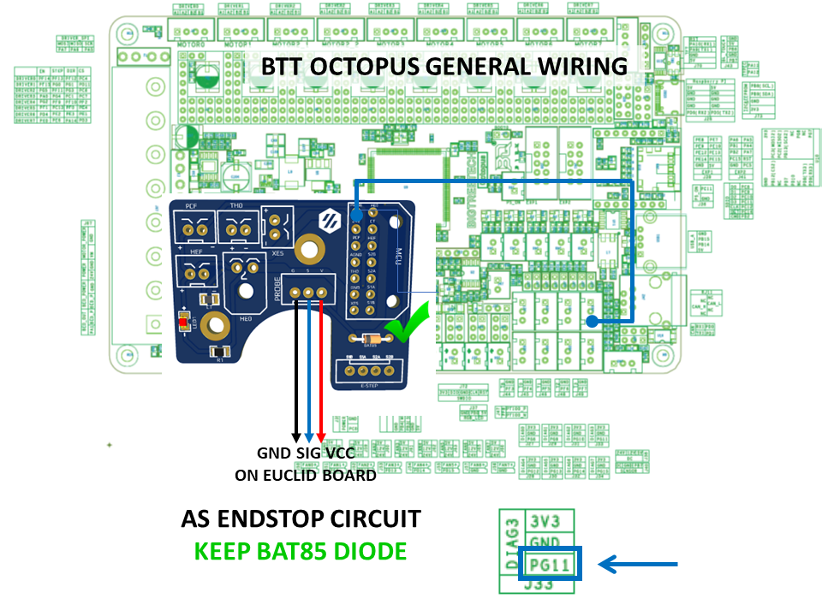
images/03/Slide3.PNG
