euclidprobe/euclidprobe.github.io/images/03/Slide4.PNG

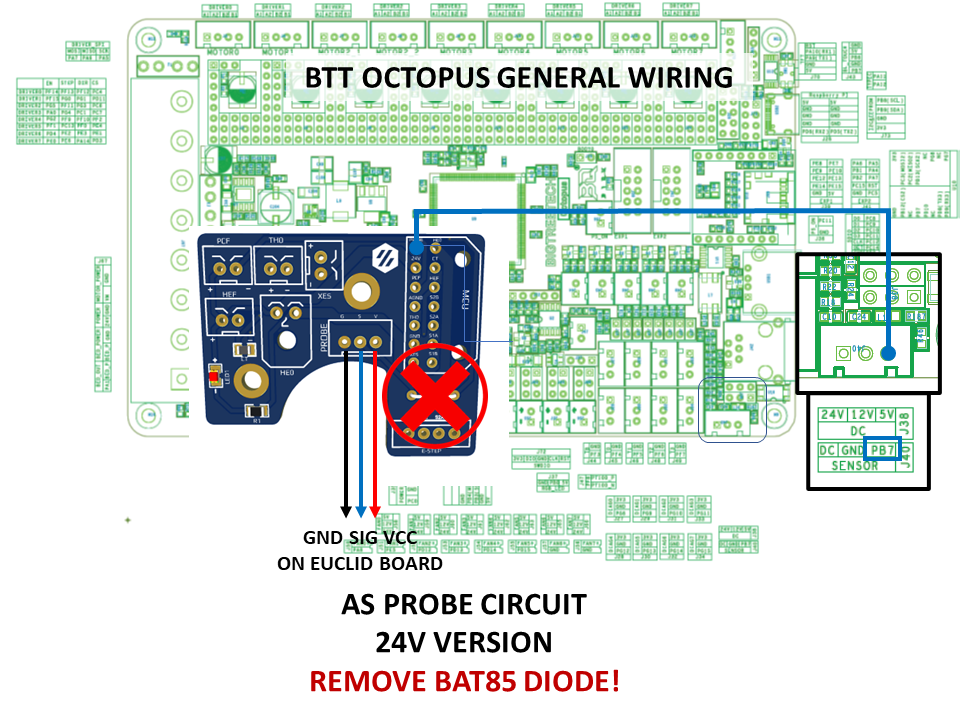
images/03/Slide4.PNG
