euclidprobe/euclidprobe.github.io/images/03/Slide12.PNG

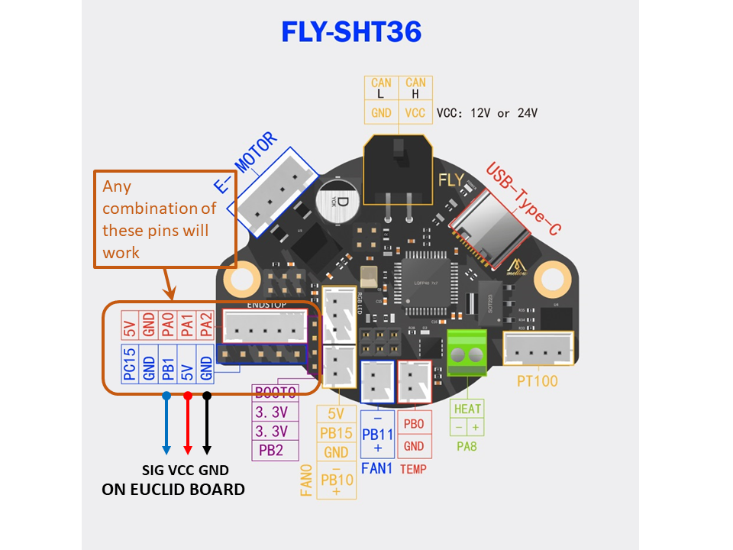
images/03/Slide12.PNG
