euclidprobe/euclidprobe.github.io/images/03/Slide13.PNG

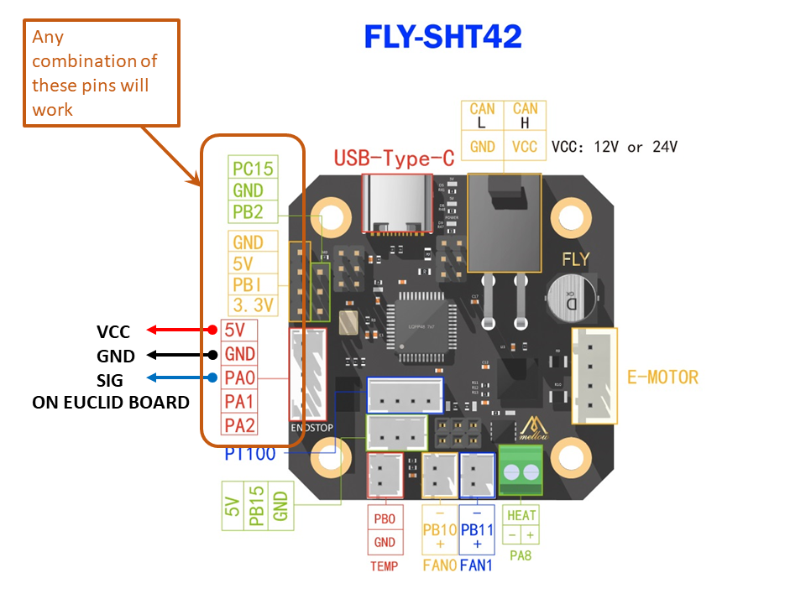
images/03/Slide13.PNG
