euclidprobe/euclidprobe.github.io/images/03/Slide14.PNG

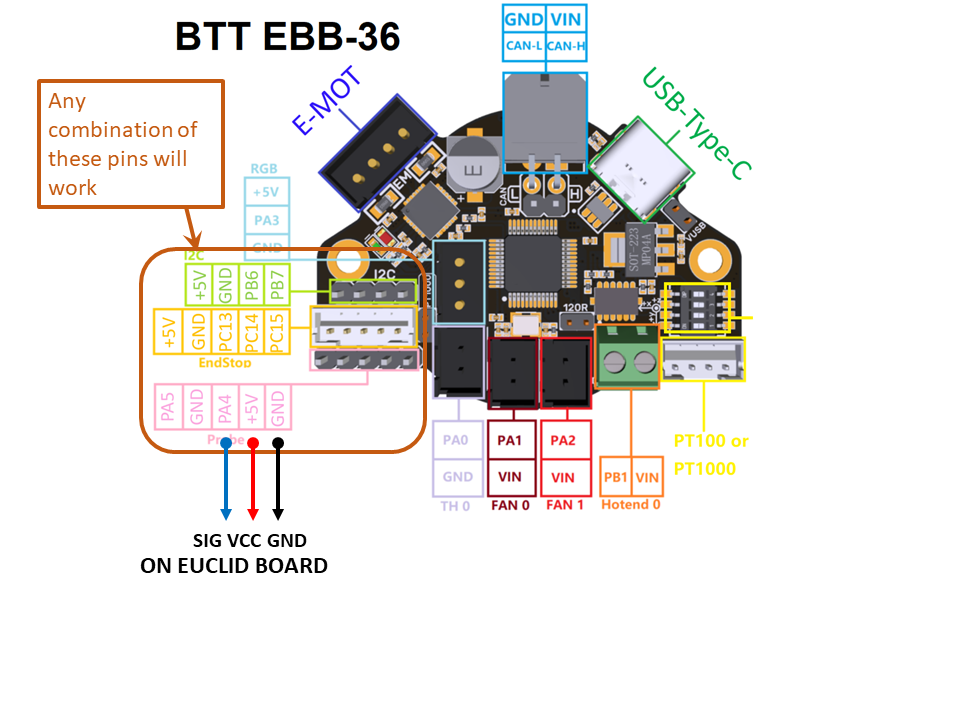
images/03/Slide14.PNG
