euclidprobe/euclidprobe.github.io/images/03/Slide15.PNG

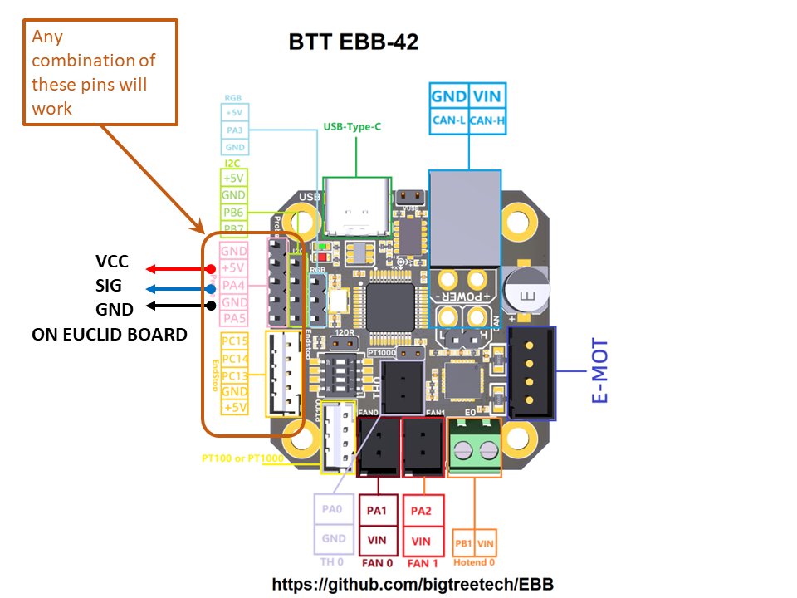
images/03/Slide15.PNG
