euclidprobe/euclidprobe.github.io/images/03/Slide16.PNG

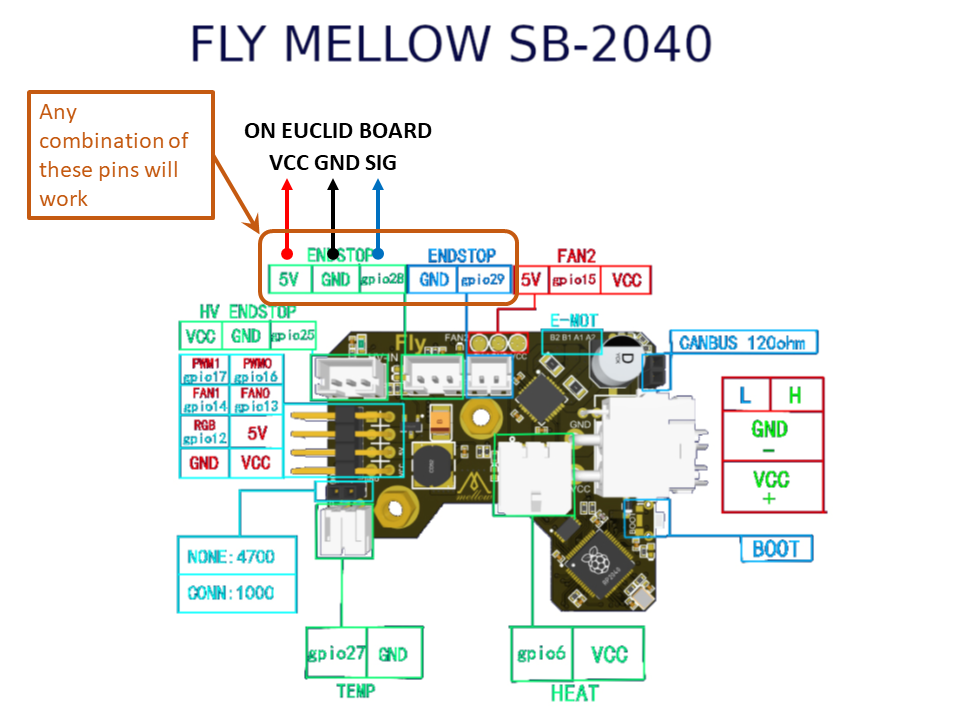
images/03/Slide16.PNG
