euclidprobe/euclidprobe.github.io/images/03_BTT-BAT85.png

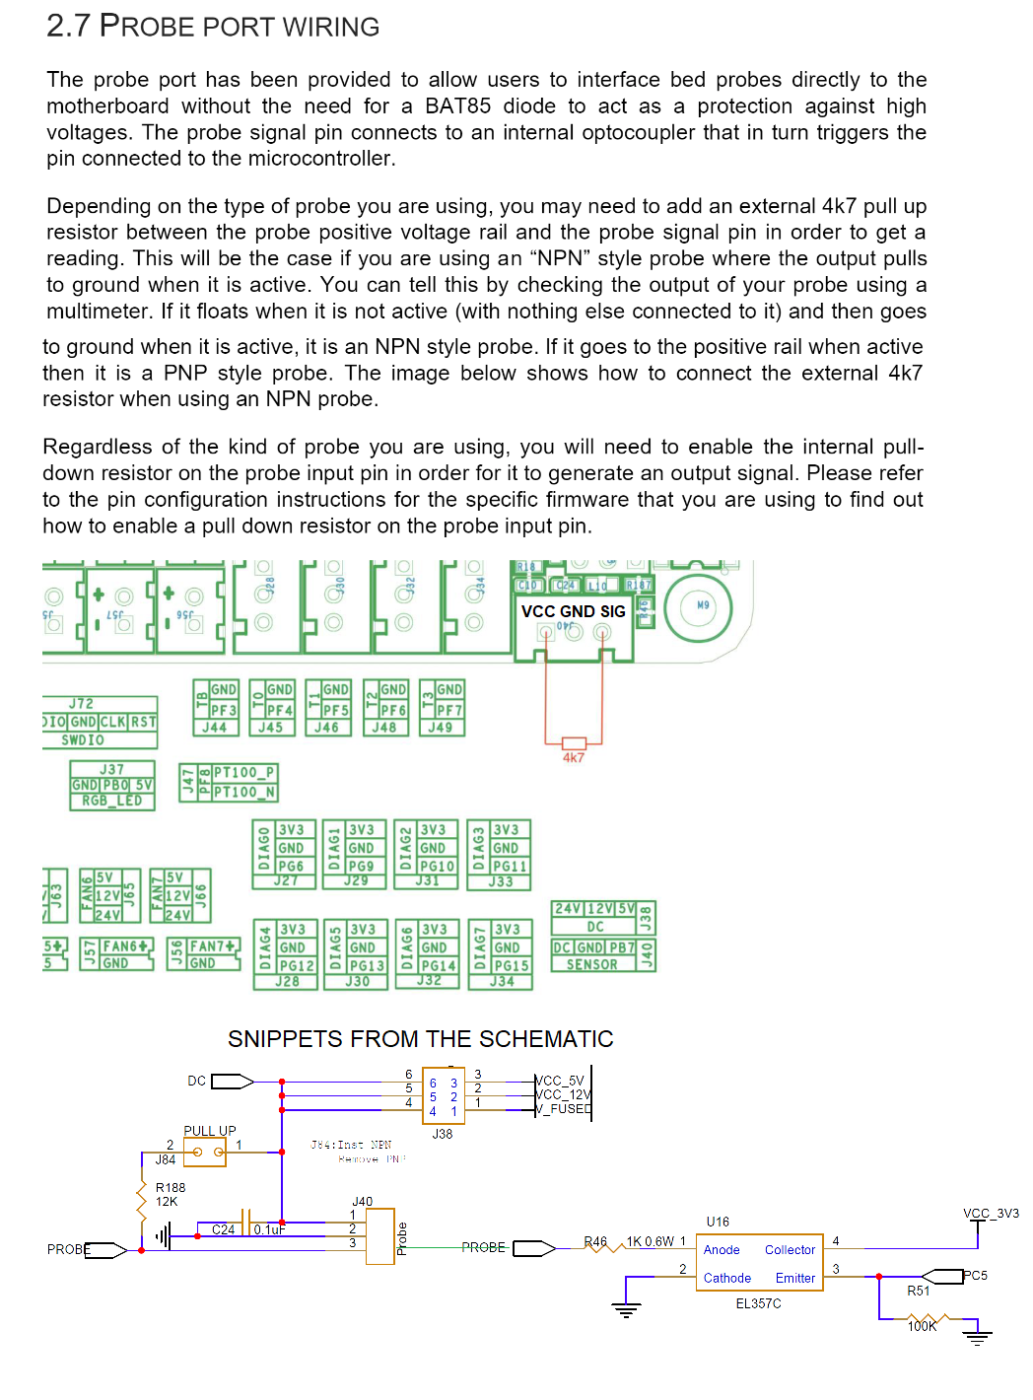
images/03_BTT-BAT85.png
