euclidprobe/euclidprobe.github.io/images/03_jays_servo.png

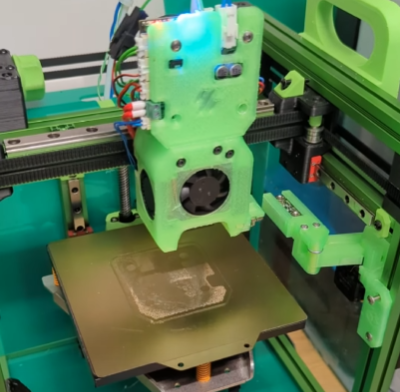
images/03_jays_servo.png
