euclidprobe/euclidprobe.github.io/images/04_2wire_example.jpg

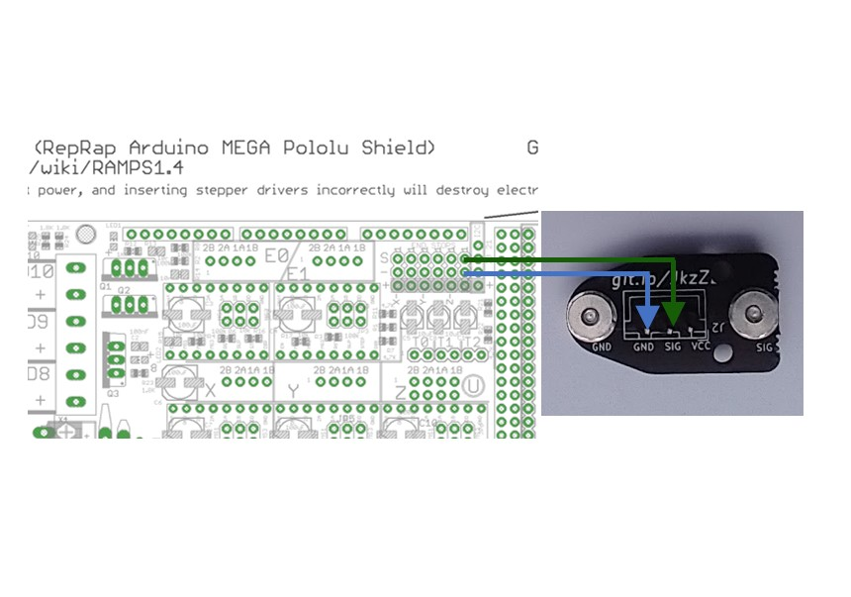
images/04_2wire_example.jpg
