euclidprobe/euclidprobe.github.io/images/04_24VTB_example.jpg

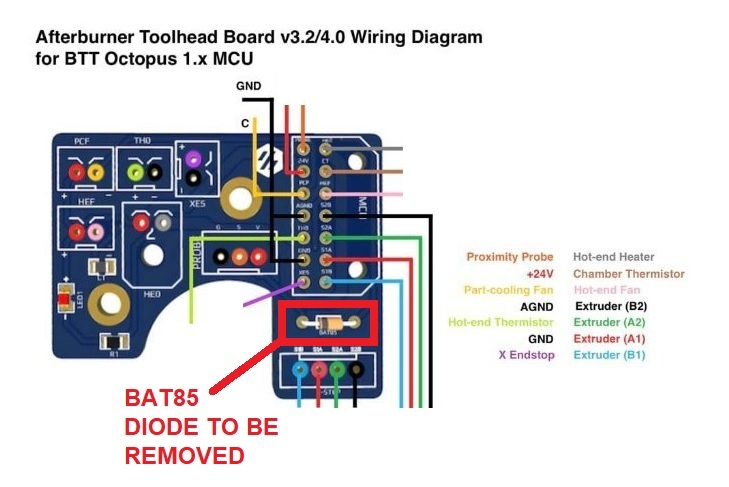
images/04_24VTB_example.jpg
