euclidprobe/euclidprobe.github.io/images/04_BLT_example.jpg

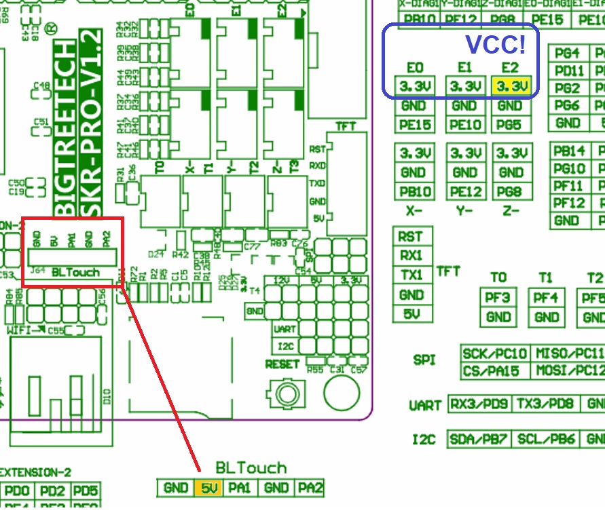
images/04_BLT_example.jpg
