euclidprobe/euclidprobe.github.io/images/04_CANB_example.jpg

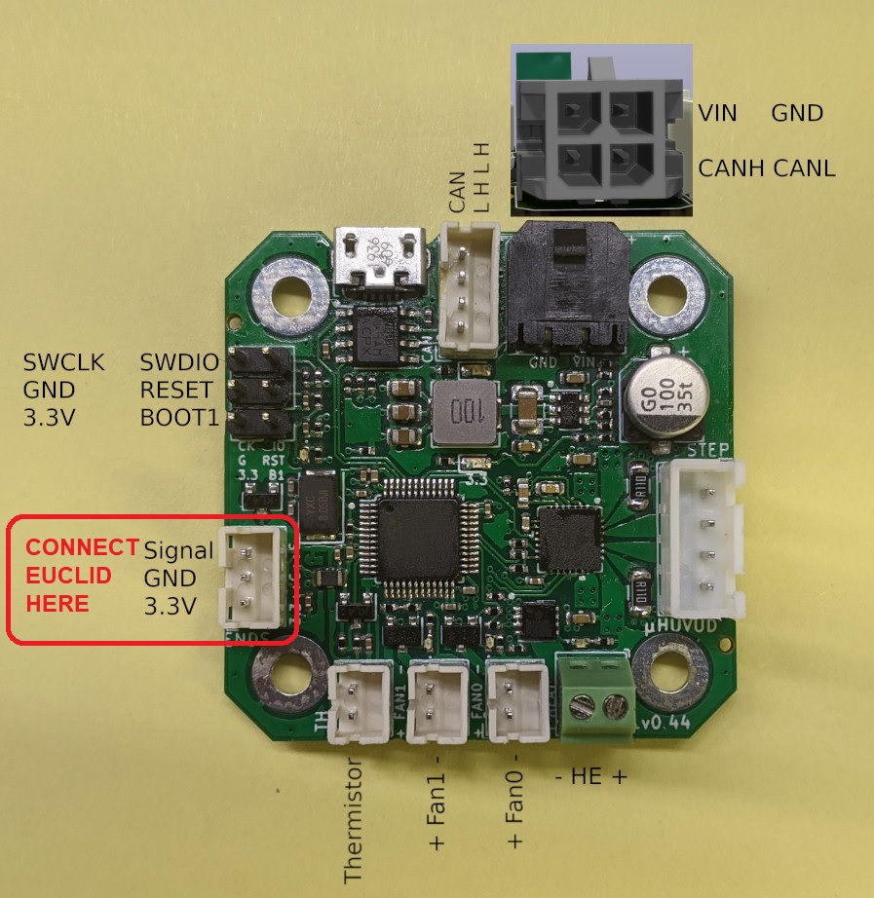
images/04_CANB_example.jpg
