euclidprobe/euclidprobe.github.io/images/05/klipper_console.png

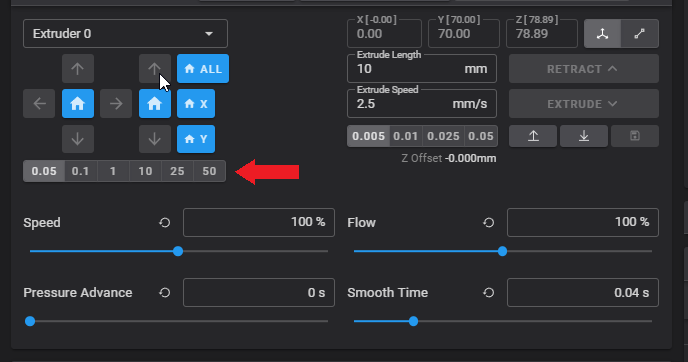
images/05/klipper_console.png
