euclidprobe/euclidprobe.github.io/images/05_feeler_gauges.jpg

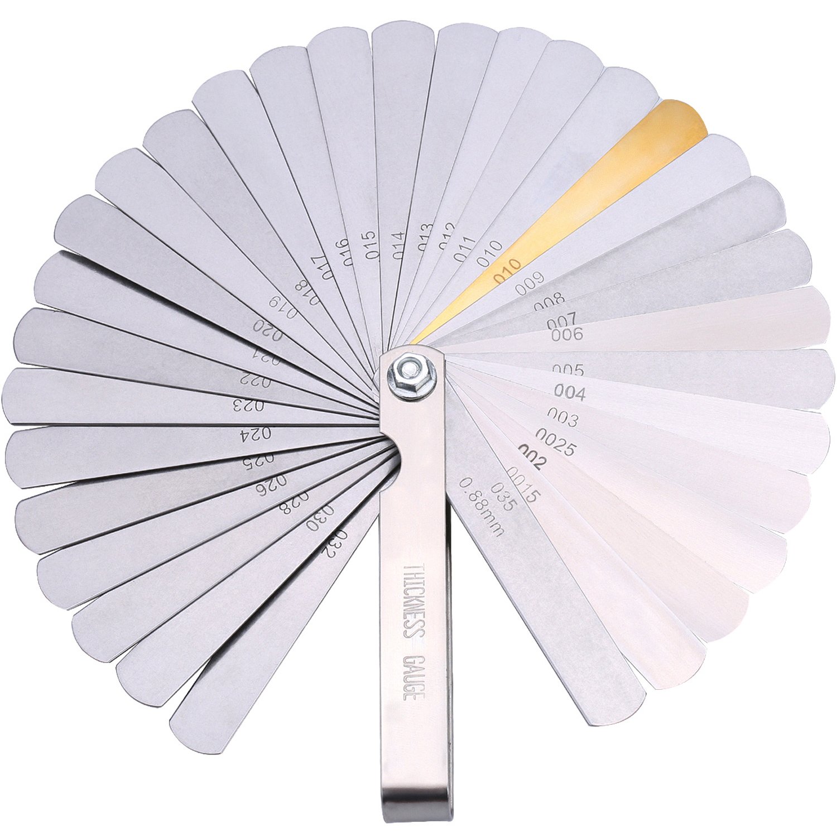
images/05_feeler_gauges.jpg
