euclidprobe/euclidprobe.github.io/images/05_feelers.jpg

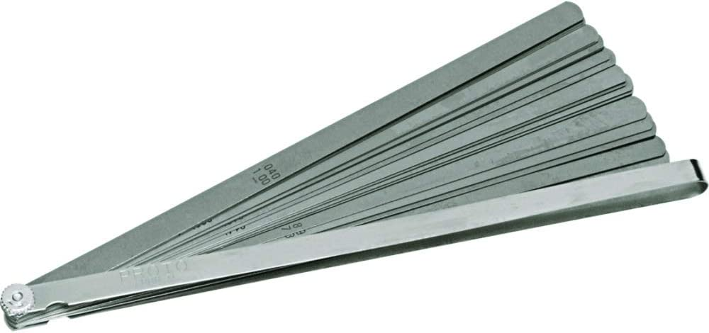
images/05_feelers.jpg
