euclidprobe/euclidprobe.github.io/images/05_offsets.png

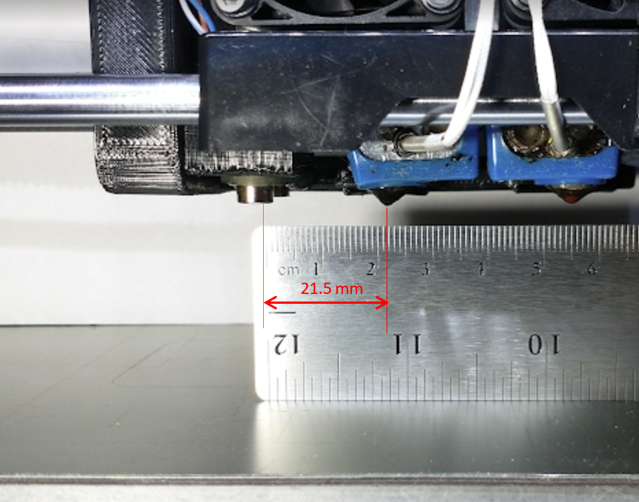
images/05_offsets.png
