euclidprobe/euclidprobe.github.io/images/05_probe-offsets-sm.png

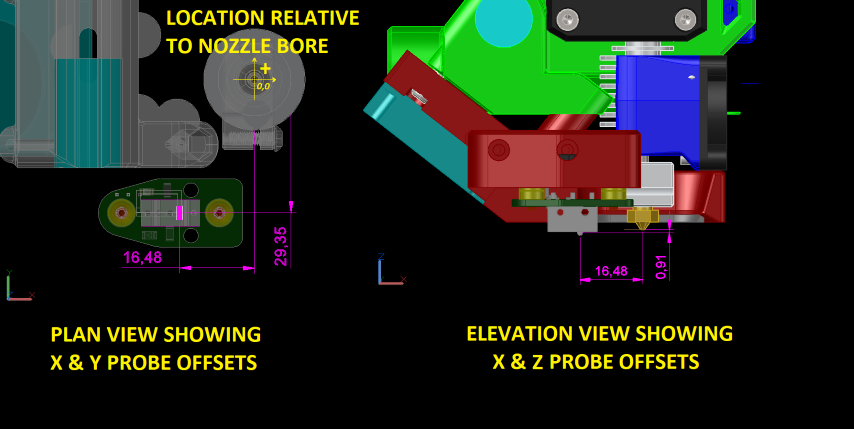
images/05_probe-offsets-sm.png
