euclidprobe/euclidprobe.github.io/images/06-klipper3.png

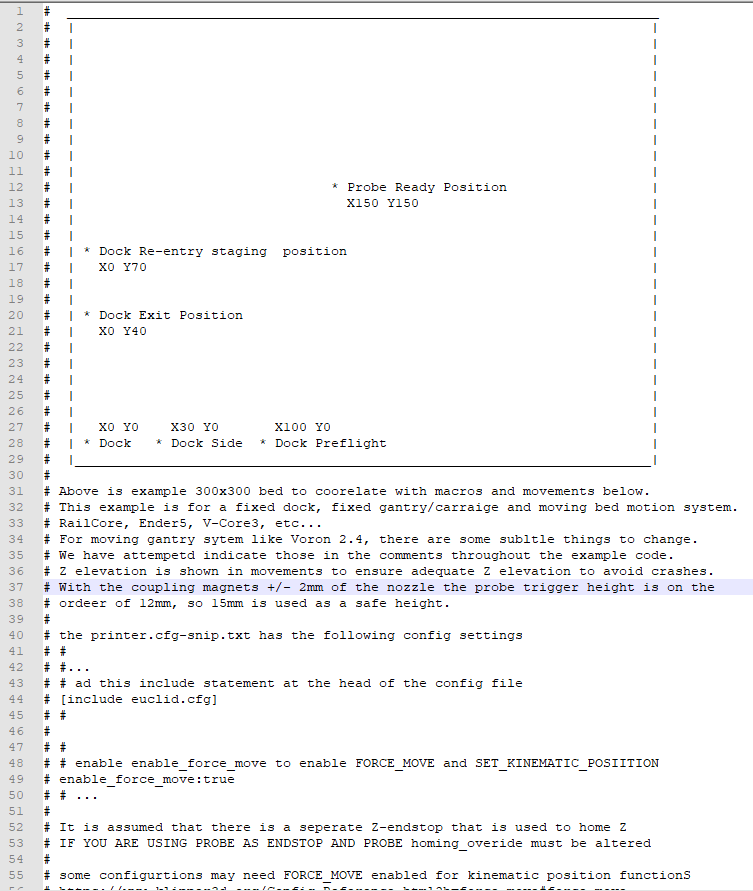
images/06-klipper3.png
