euclidprobe/euclidprobe.github.io/images/06-probe_deploy-1024x610.jpg

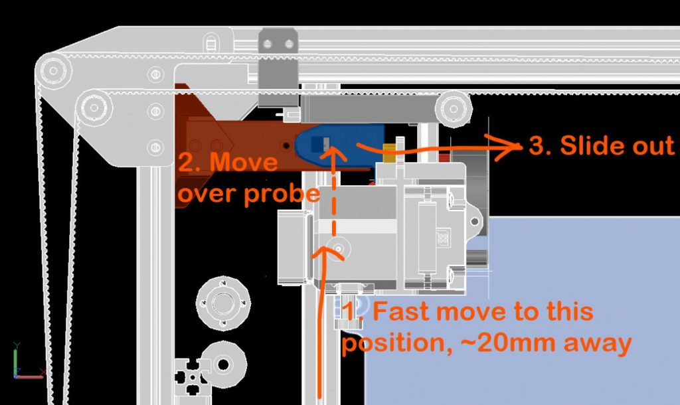
images/06-probe_deploy-1024x610.jpg
