euclidprobe/euclidprobe.github.io/images/24V_restock.jpg

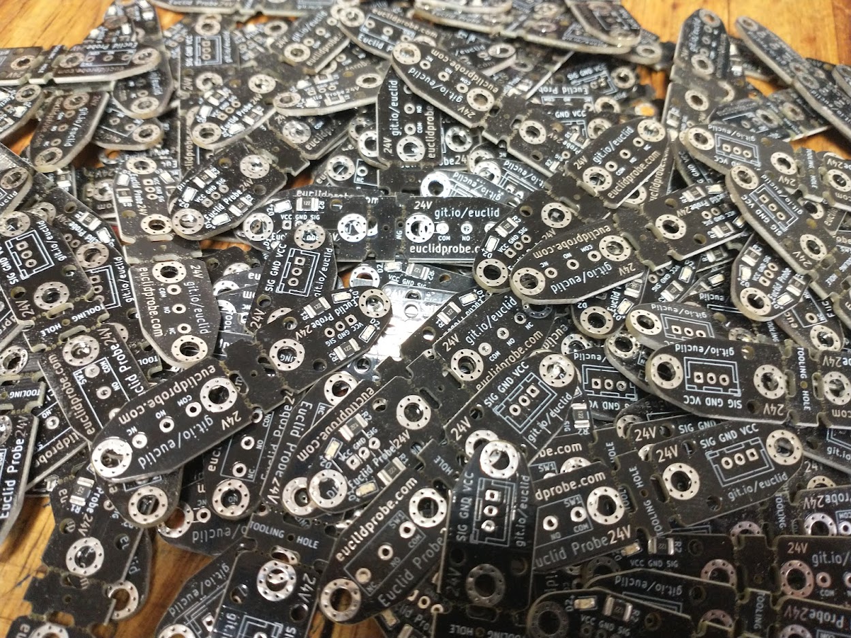
images/24V_restock.jpg
