euclidprobe/euclidprobe.github.io/images/441point_RailCore_image.PNG

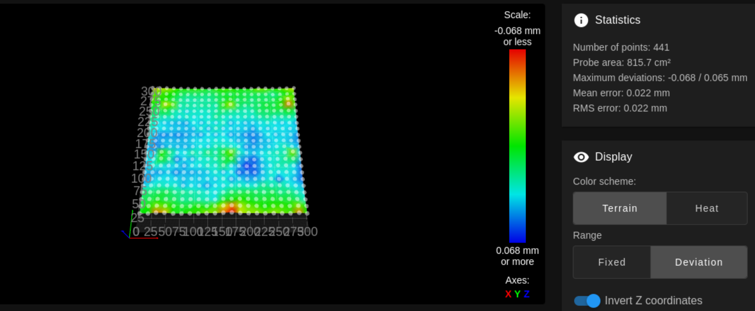
images/441point_RailCore_image.PNG
