euclidprobe/euclidprobe.github.io/images/666-crash.png

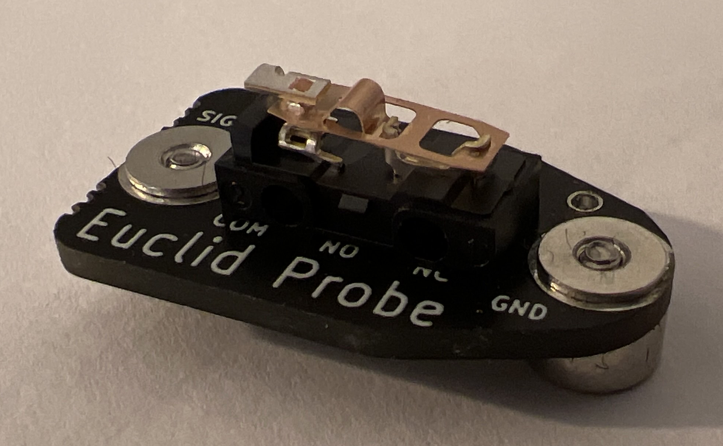
images/666-crash.png
