euclidprobe/euclidprobe.github.io/images/country/Flag_of_Australia.png

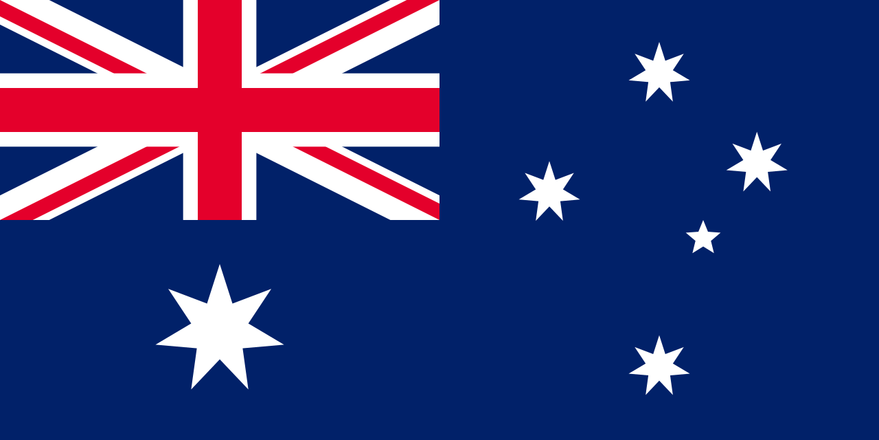
images/country/Flag_of_Australia.png
