euclidprobe/euclidprobe.github.io/images/gingerbeard2.bak - Copy.png

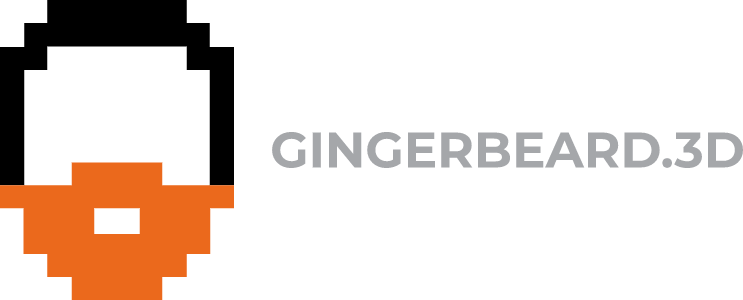
images/gingerbeard2.bak - Copy.png
