euclidprobe/euclidprobe.github.io/stls/BLTouch/02_BL_Touch_M3HeatSerts.jpg

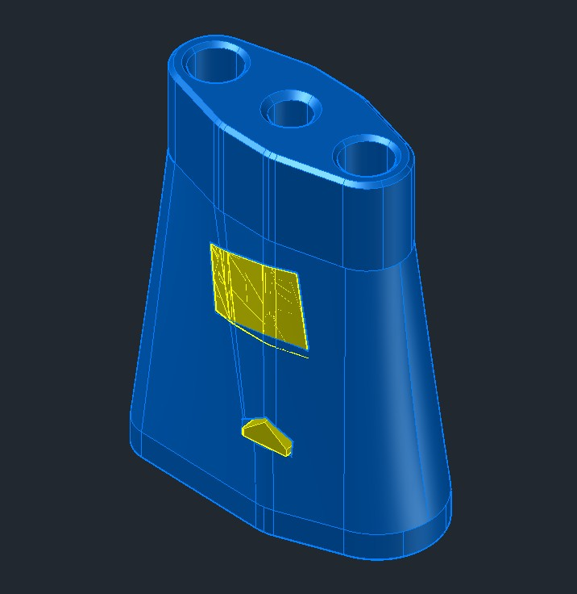
stls/BLTouch/02_BL_Touch_M3HeatSerts.jpg
