euclidprobe/euclidprobe.github.io/stls/BLTouch/02_BLT_Adapter.jpg

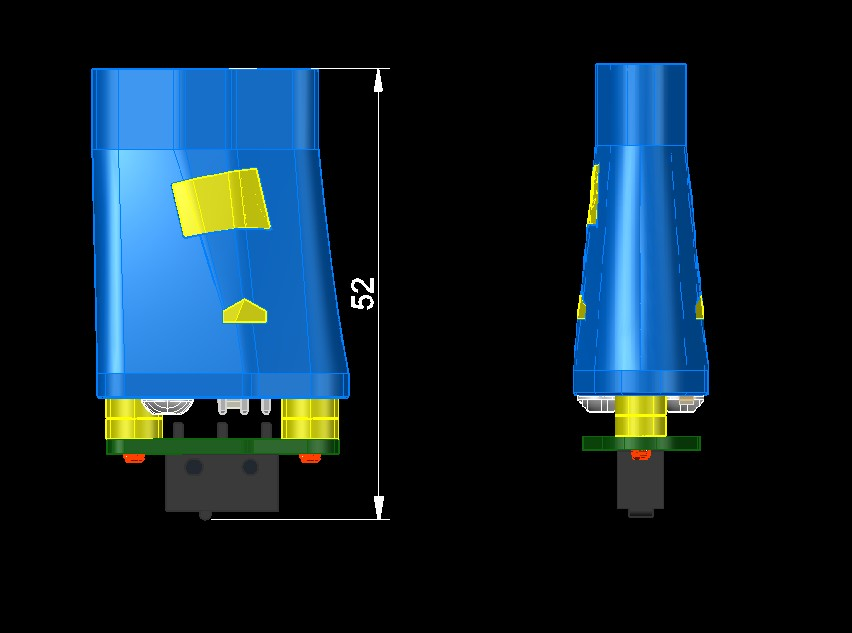
stls/BLTouch/02_BLT_Adapter.jpg
