euclidprobe/euclidprobe.github.io/stls/BLTouch/02_BLTV3.jpg

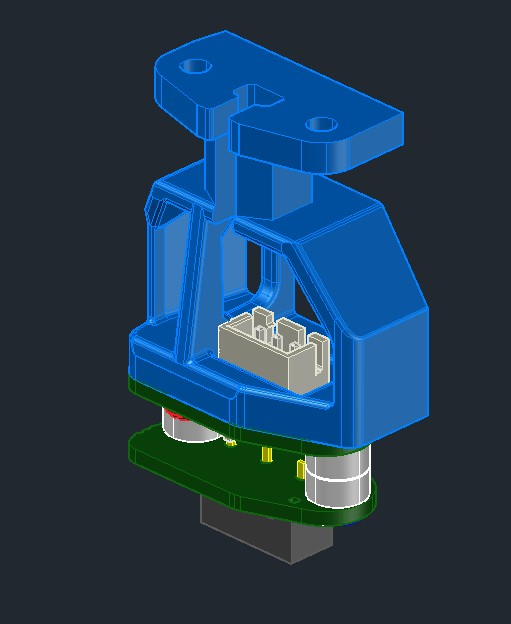
stls/BLTouch/02_BLTV3.jpg
