euclidprobe/euclidprobe.github.io/stls/Inductive/12mm.jpg

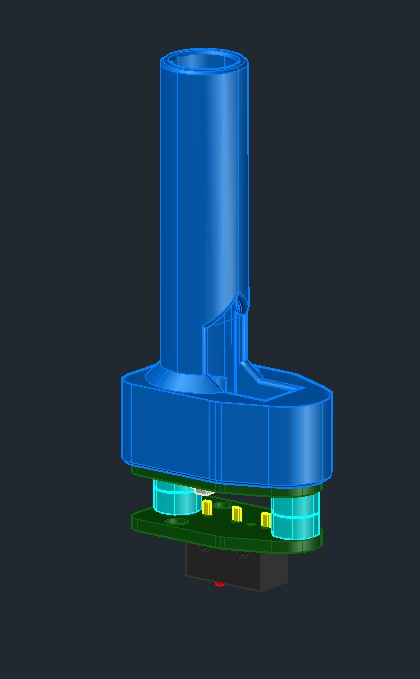
stls/Inductive/12mm.jpg
