euclidprobe/euclidprobe.github.io/stls/Omron/02_OmronFotec90.png

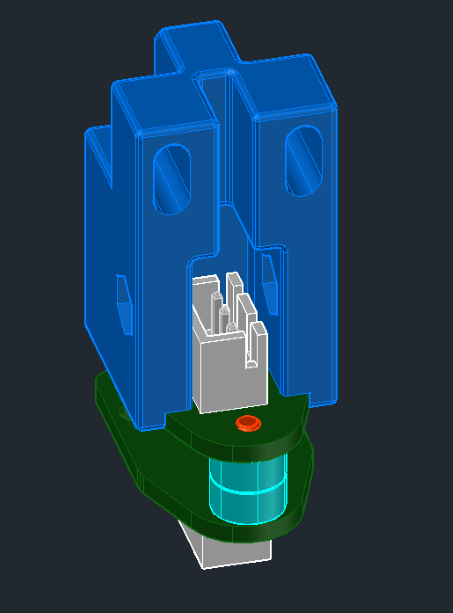
stls/Omron/02_OmronFotec90.png
