euclidprobe/euclidprobe.github.io/images/02-ender/EnderPartsPlate-300x203.jpg

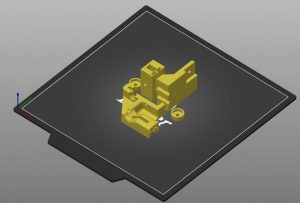
images/02-ender/EnderPartsPlate-300x203.jpg
