euclidprobe/euclidprobe.github.io/images/02_AllParts_300x268.jpg

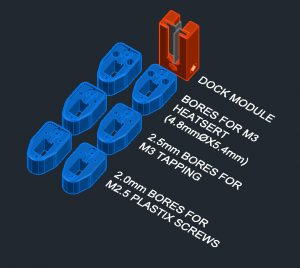
images/02_AllParts_300x268.jpg
