euclidprobe/euclidprobe.github.io/images/04-wiring/pcb_parts/Slide2.PNG

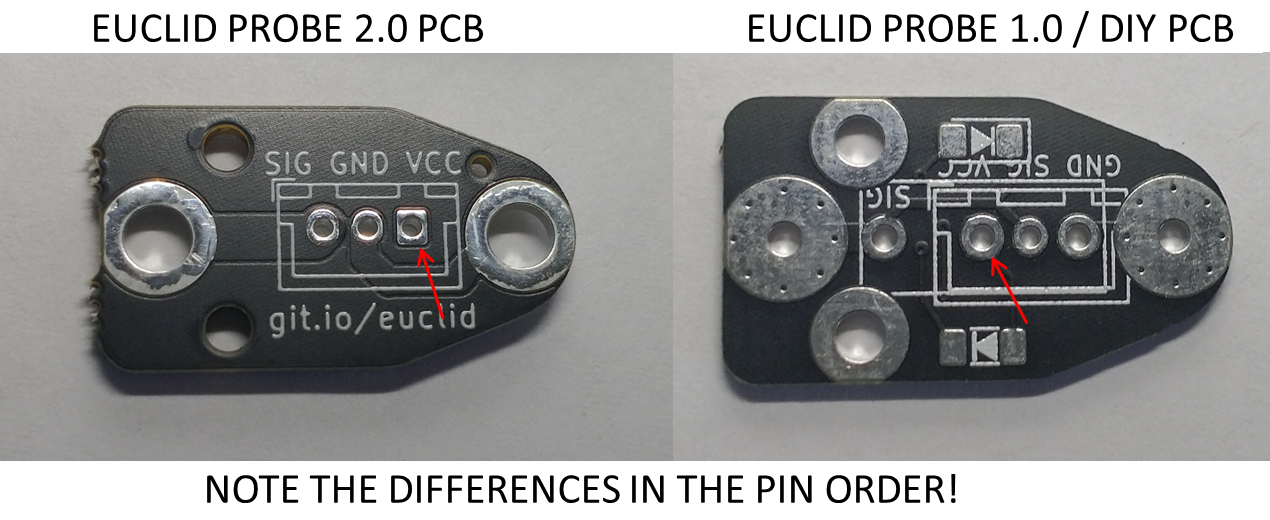
images/04-wiring/pcb_parts/Slide2.PNG
