euclidprobe/euclidprobe.github.io/stls/Assembly Jigs/soldering_jigV5-0.3mm_margin.stl

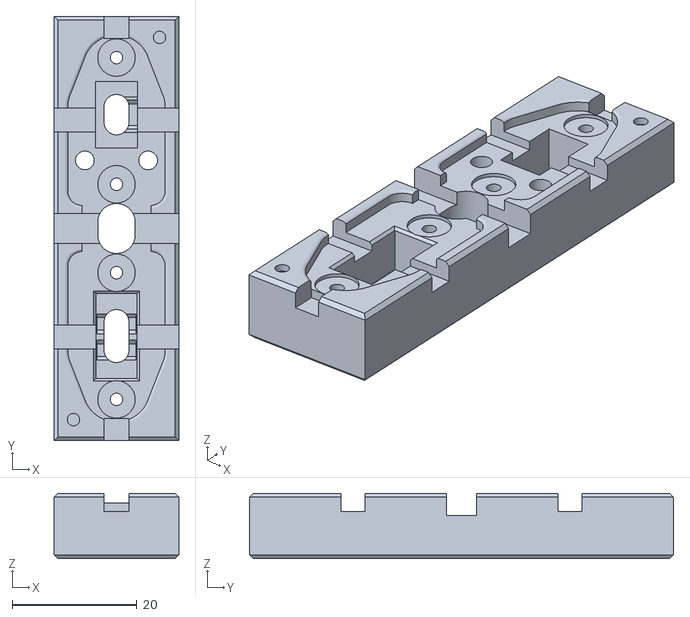
[picture p151: CAD file, 2022-02-07]
stls/Assembly Jigs/soldering_jigV5-0.3mm_margin.stl
20.0 x 68.0 x 10.5
