euclidprobe/euclidprobe.github.io/stls/BLTouch/BLTouch4HypercubeM3Nuts.stl

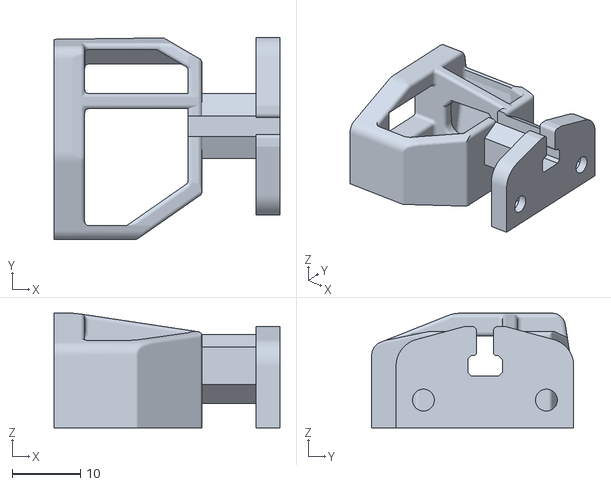
[picture p152: CAD file, 2022-02-07]
stls/BLTouch/BLTouch4HypercubeM3Nuts.stl
33.1 x 29.5 x 16.8
