euclidprobe/euclidprobe.github.io/stls/Building Blocks/Grafting_Dock_RegBoss_V3.stl

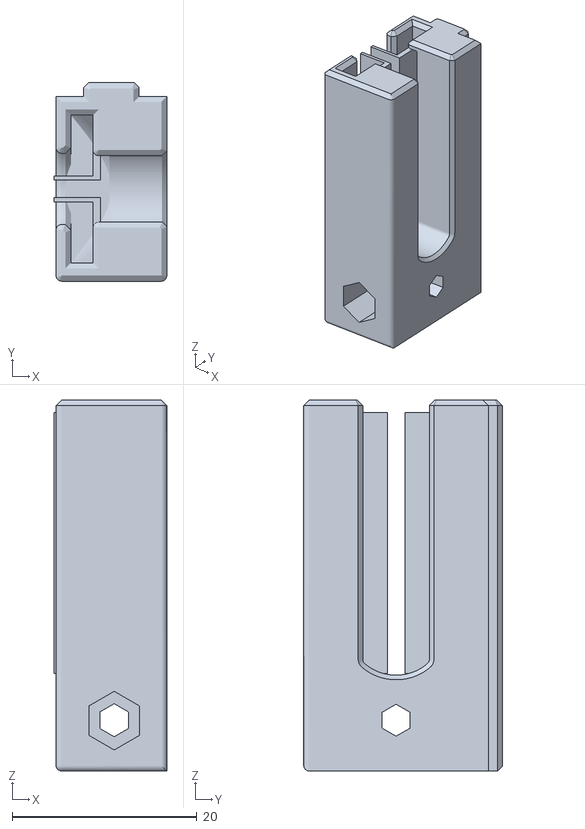
[picture p153: CAD file, 2022-01-30]
stls/Building Blocks/Grafting_Dock_RegBoss_V3.stl
12.2 x 21.5 x 40.2
