euclidprobe/euclidprobe.github.io/stls/Inductive/12mmInductive.stl

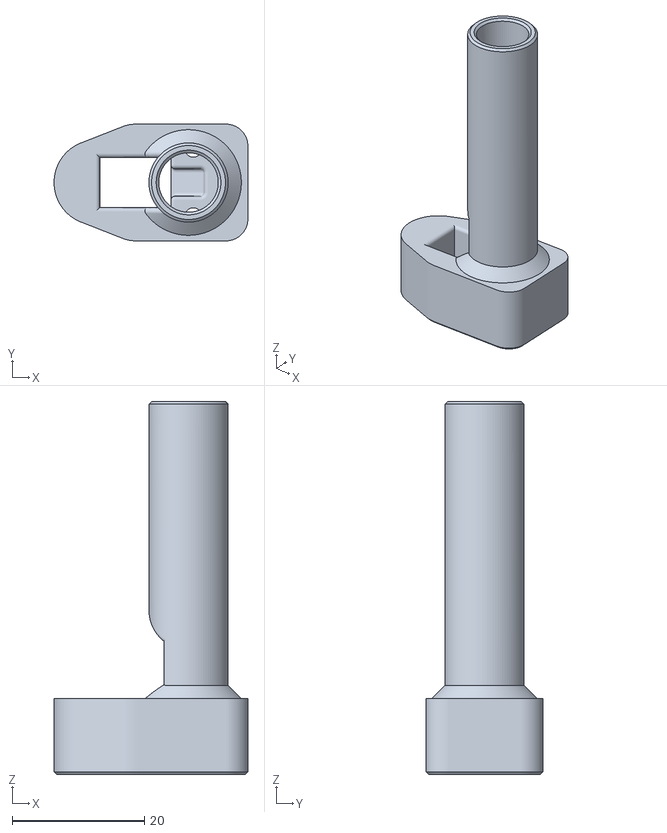
[picture p154: CAD file, 2022-01-24]
stls/Inductive/12mmInductive.stl
29.4 x 17.7 x 56.5
