euclidprobe/euclidprobe.github.io/stls/Omron/OmronFotekM3TapV3.stl

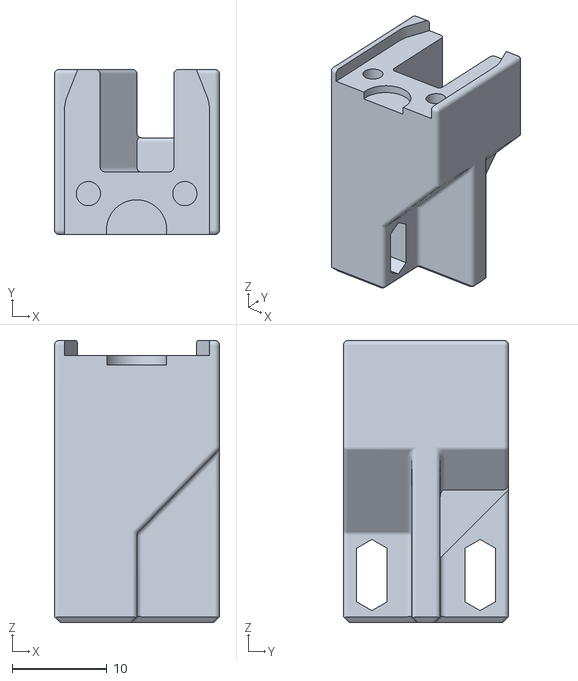
[picture p155: CAD file, 2022-02-07]
stls/Omron/OmronFotekM3TapV3.stl
17.4 x 17.4 x 29.7
