euclidprobe/euclidprobe.github.io/stls/BLTouch/BLTouchV3.stl

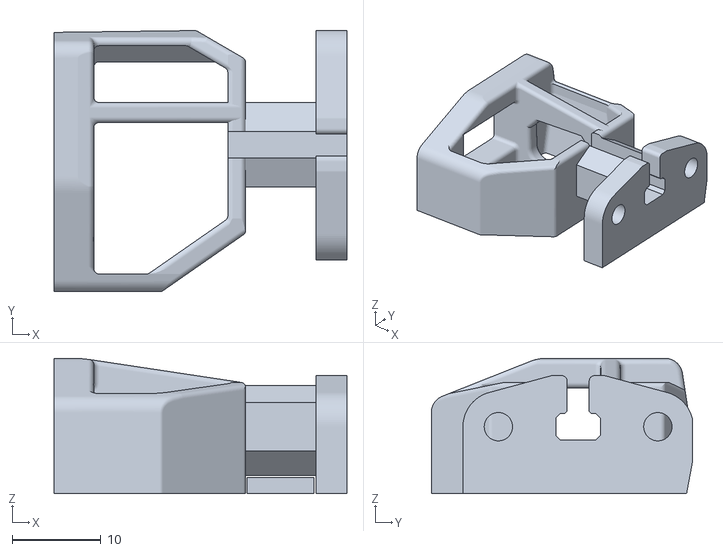
[picture p156: CAD file, 2022-02-07]
stls/BLTouch/BLTouchV3.stl
33.1 x 29.5 x 15.3
