euclidprobe/euclidprobe.github.io/stls/Building Blocks/Modular_Parts.stl

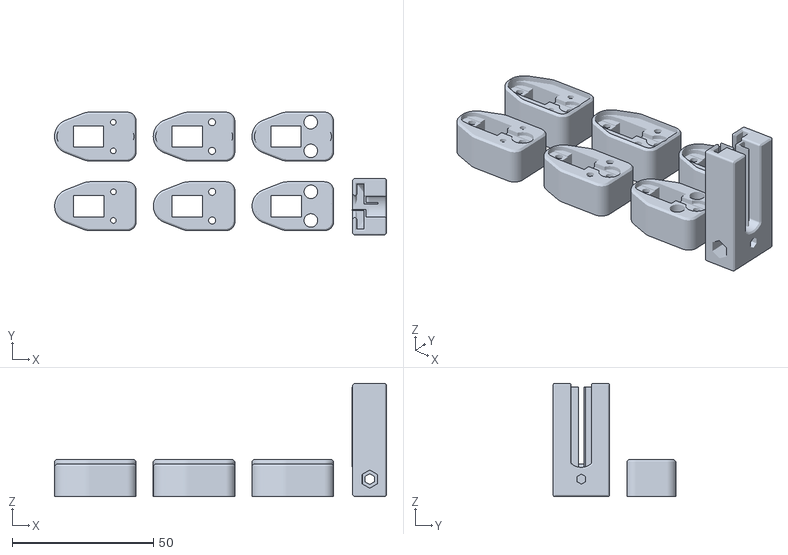
[picture p157: CAD file, 2022-01-30]
stls/Building Blocks/Modular_Parts.stl
117.7 x 43.5 x 40.2
