euclidprobe/euclidprobe.github.io/stls/Omron/OmronFotek90HeatsertV3.stl

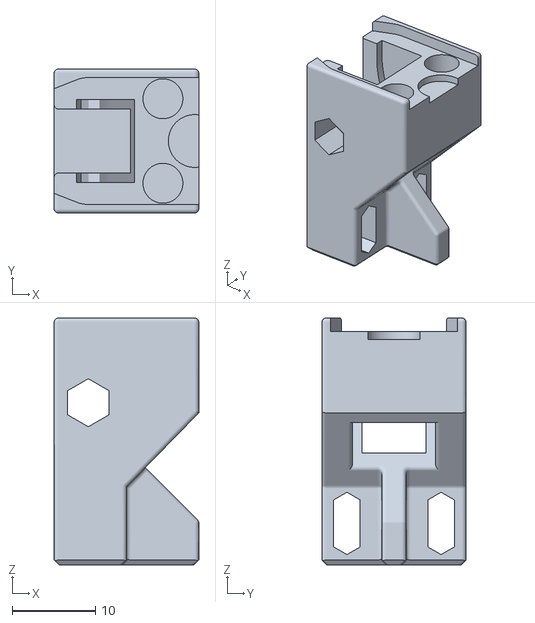
[picture p159: CAD file, 2022-02-07]
stls/Omron/OmronFotek90HeatsertV3.stl
17.4 x 17.3 x 29.7
