euclidprobe/euclidprobe.github.io/stls/Building Blocks/Grafting_DockV3.stl

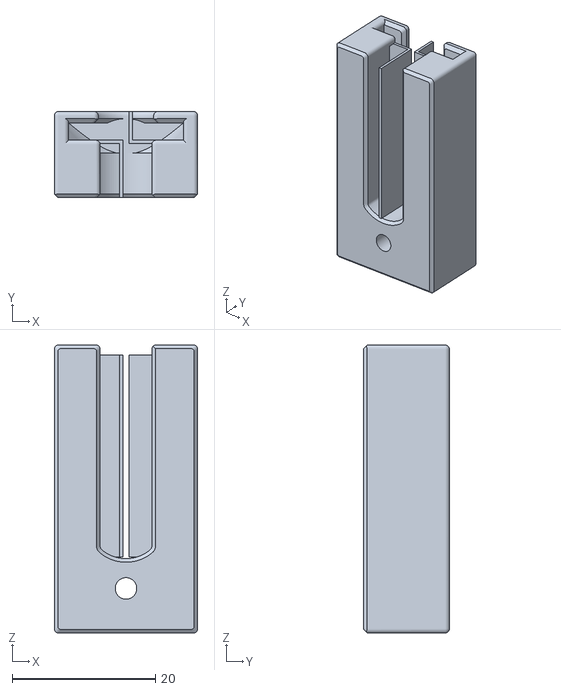
[picture p160: CAD file, 2022-01-30]
stls/Building Blocks/Grafting_DockV3.stl
20.0 x 12.0 x 40.2
