euclidprobe/euclidprobe.github.io/stls/Omron/OmronFotek90M2_V3.stl

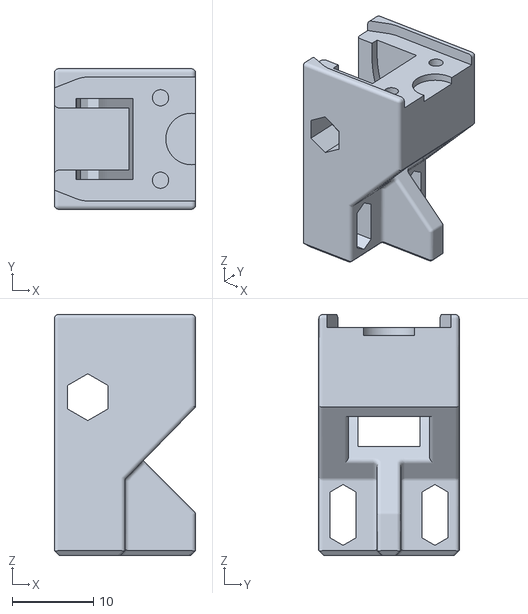
[picture p161: CAD file, 2022-02-07]
stls/Omron/OmronFotek90M2_V3.stl
17.4 x 17.3 x 29.7
