euclidprobe/euclidprobe.github.io/stls/BLTouch/BLTouch-M3HeatSerts.stl

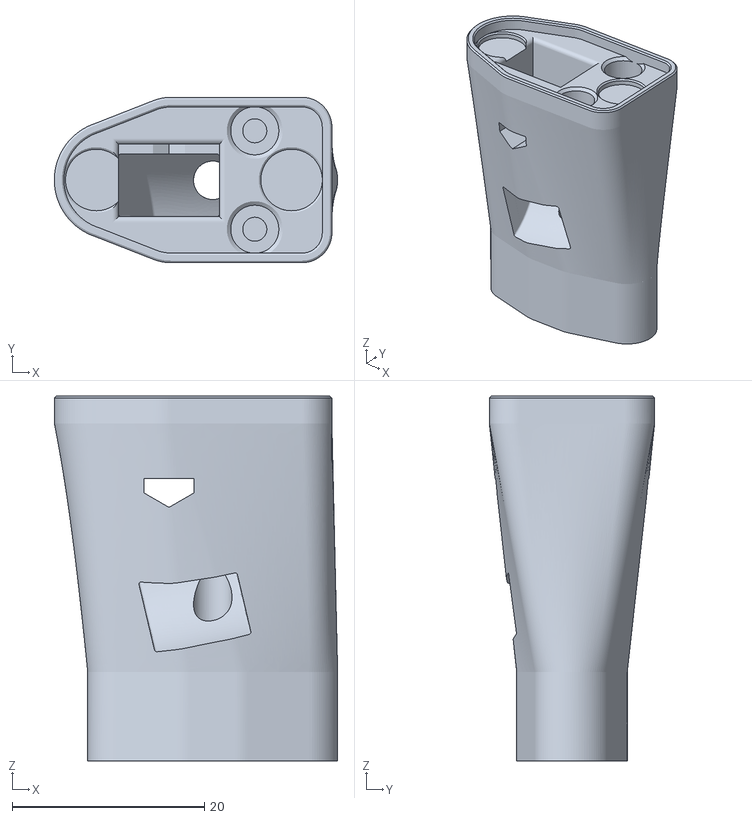
[picture p162: CAD file, 2022-01-24]
stls/BLTouch/BLTouch-M3HeatSerts.stl
29.5 x 17.2 x 38.0
