euclidprobe/euclidprobe.github.io/stls/Assembly Jigs/EuclidTappingJig2.stl

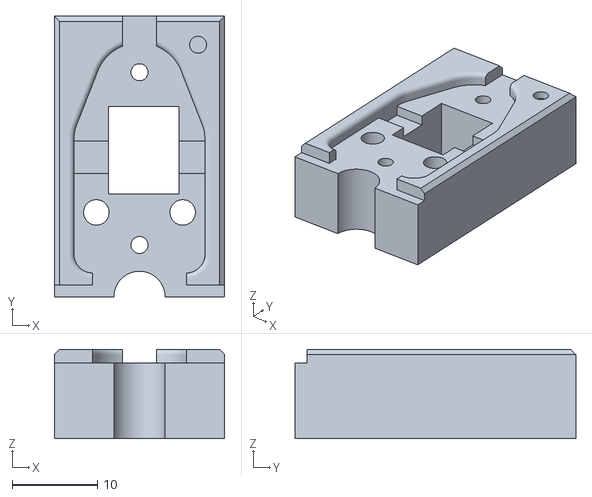
[picture p164: CAD file, 2022-01-30]
stls/Assembly Jigs/EuclidTappingJig2.stl
20.0 x 33.0 x 10.5
