euclidprobe/euclidprobe.github.io/stls/BLTouch/BLTouch-M3HeatSertsPIP.stl

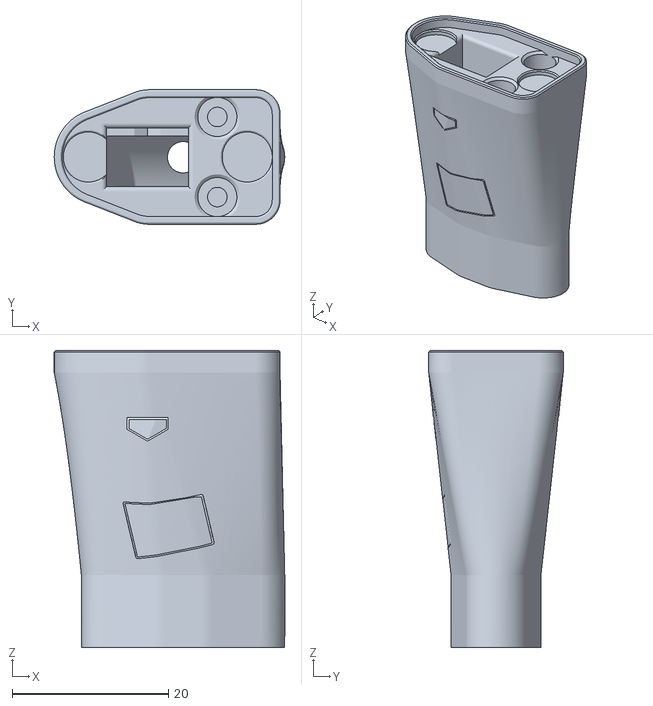
[picture p167: CAD file, 2022-01-24]
stls/BLTouch/BLTouch-M3HeatSertsPIP.stl
29.5 x 17.2 x 38.0
