euclidprobe/euclidprobe.github.io/stls/Building Blocks/Modular_Parts_M2.5Holes.stl

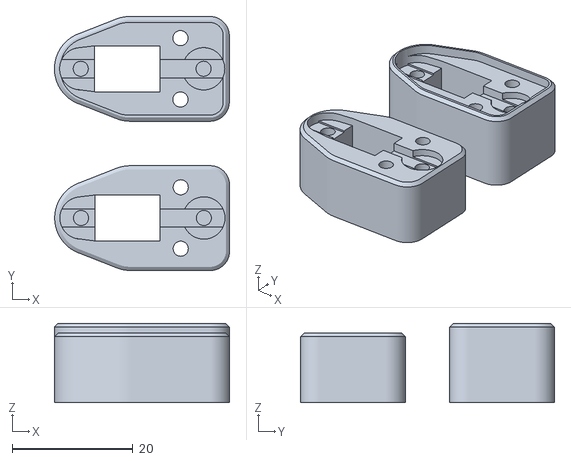
[picture p168: CAD file, 2022-01-30]
stls/Building Blocks/Modular_Parts_M2.5Holes.stl
29.0 x 42.0 x 13.1
