euclidprobe/euclidprobe.github.io/stls/BLTouch/BLTouch-M3PilotHolesPIP.stl

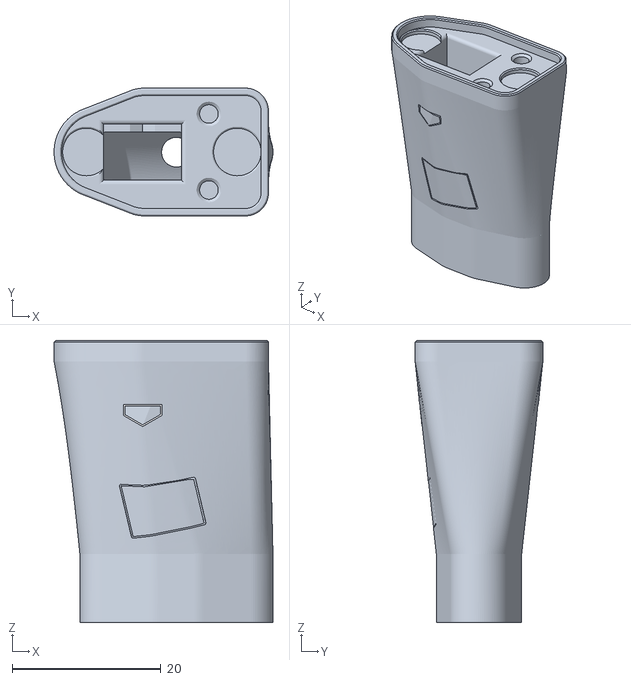
[picture p169: CAD file, 2022-01-24]
stls/BLTouch/BLTouch-M3PilotHolesPIP.stl
29.5 x 17.2 x 38.0
