euclidprobe/euclidprobe.github.io/stls/Building Blocks/Grafting_MountM2Holes_Recessed.stl

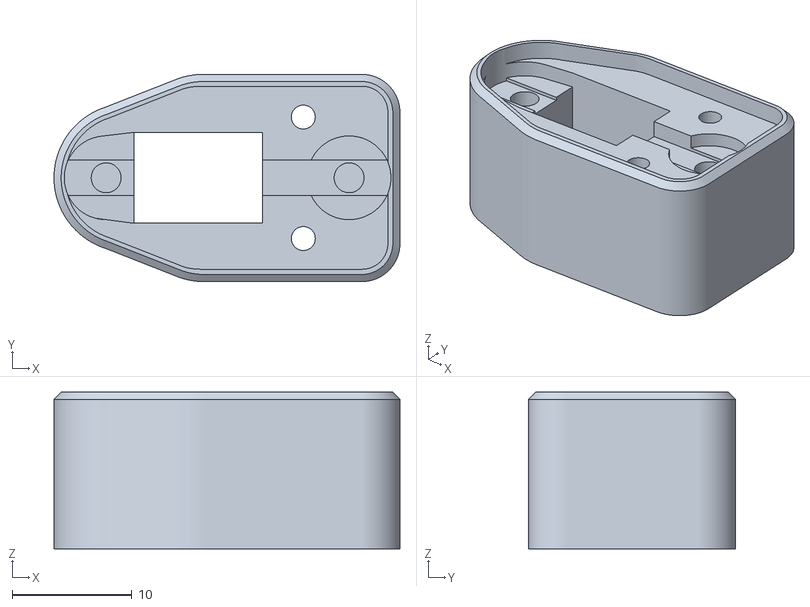
[picture p170: CAD file, 2022-01-24]
stls/Building Blocks/Grafting_MountM2Holes_Recessed.stl
28.9 x 17.3 x 13.1
