euclidprobe/euclidprobe.github.io/stls/Building Blocks/GraftingDockSurfaceMtM3Heatserts.stl

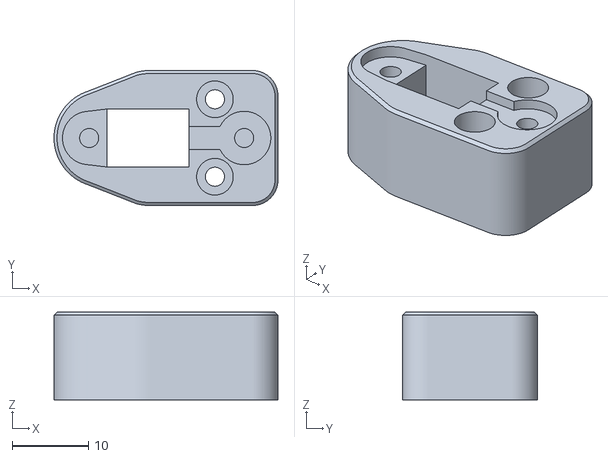
[picture p171: CAD file, 2022-01-24]
stls/Building Blocks/GraftingDockSurfaceMtM3Heatserts.stl
29.4 x 17.7 x 11.5
