euclidprobe/euclidprobe.github.io/stls/Building Blocks/GraftingDockFlushM3PilotHoles.stl

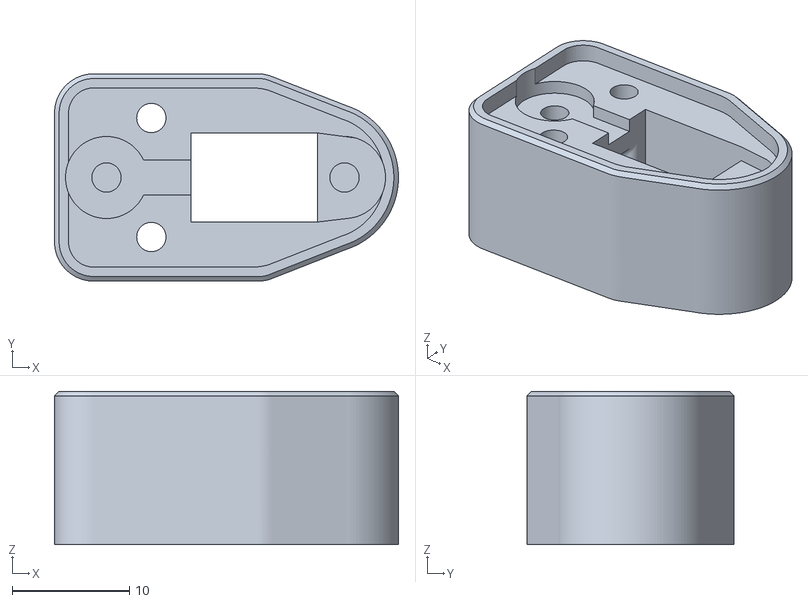
[picture p172: CAD file, 2022-01-24]
stls/Building Blocks/GraftingDockFlushM3PilotHoles.stl
29.4 x 17.7 x 13.1
