euclidprobe/euclidprobe.github.io/stls/Building Blocks/GraftingDockFlushM3Heatserts.stl

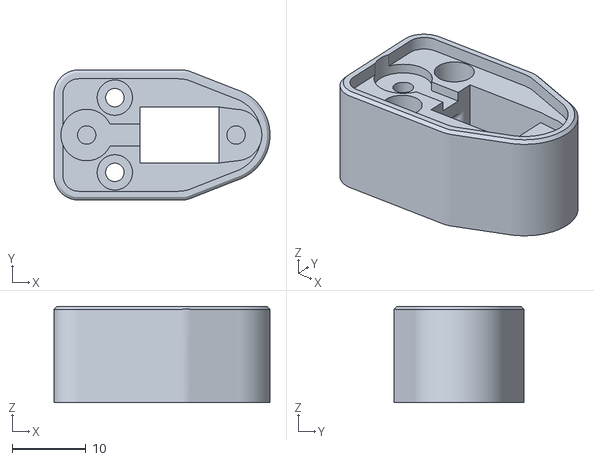
[picture p173: CAD file, 2022-01-24]
stls/Building Blocks/GraftingDockFlushM3Heatserts.stl
29.4 x 17.7 x 13.1
