euclidprobe/euclidprobe.github.io/stls/Building Blocks/Grafting_MountM2Holes.stl

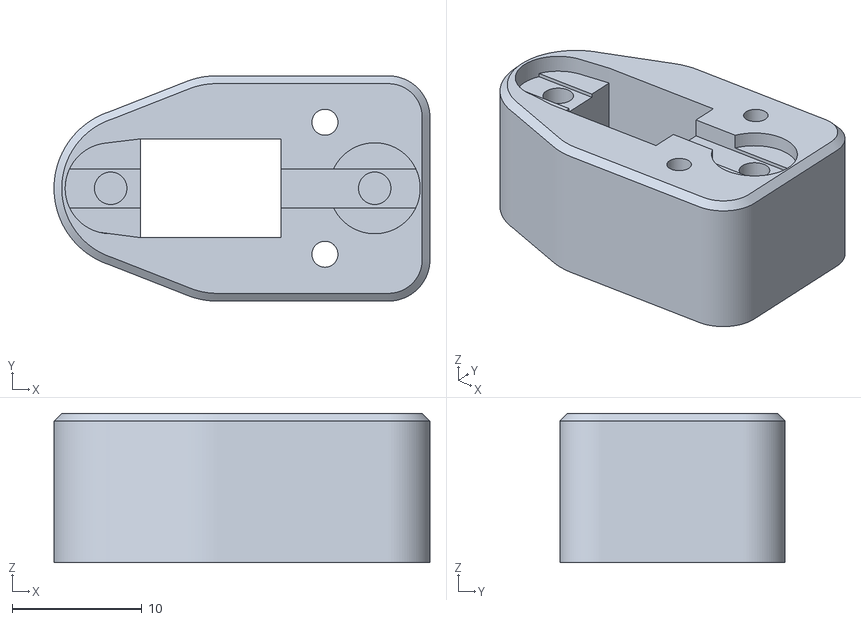
[picture p174: CAD file, 2022-01-24]
stls/Building Blocks/Grafting_MountM2Holes.stl
28.9 x 17.3 x 11.5
