euclidprobe/euclidprobe.github.io/(list of files, cad)

Other CAD files:
stls/Assembly Jigs/soldering_jigV5-0.5mm_margin.stl
stls/Assembly Jigs/soldering_jigV5-0.2mm_margin.stl
stls/BLTouch/BLTouch4HypercubeHtSrts.stl
stls/Assembly Jigs/soldering_jigV5-0.4mm_margin.stl
stls/Omron/OmronFotek90M3TapV3.stl
stls/Omron/OmronFotekM2_V3.stl
stls/Omron/OmronFotekHeatsertV3.stl
stls/Building Blocks/GraftingDockSurfaceMtM3PilotHoles.stl
stls/Building Blocks/Modular_PartsV2.stp
images/Old_site/1515ExpanderDrillingJigHeatsert85deg.stl
images/Old_site/4020FanPt3Left.stl
images/Old_site/4020FanPt3Right.stl
images/Old_site/5015V3Left-1.stl
images/Old_site/5015V3Left.stl
images/Old_site/5015V3Right.stl
images/Old_site/Ender3DockModularV3.2.stl
images/Old_site/Ender3DockPartsV3.3mf
images/Old_site/Ender3DockV3.stl
images/Old_site/Ender3PartsPlate-1.stl
images/Old_site/Ender3PartsPlate.stl
images/Old_site/Ender3PartsPlateV7.3mf
images/Old_site/Ender3PartsPlateV7.stl
images/Old_site/Ender5DockV7.stl
images/Old_site/Ender5MountV7.stl
images/Old_site/Ender5MountV8.stl
images/Old_site/Ender5MountV8_Alt.stl
images/Old_site/Ender5PlateV7.stl
images/Old_site/EnderDockFinal.stl
images/Old_site/EnderDockMountFinal.stl
images/Old_site/EuclidProbeDock-1.stl
images/Old_site/EuclidProbeDock.stl
images/Old_site/EuclidProbeEVAMountM3Heatserts-1.stl
images/Old_site/EuclidProbeEVAMountM3Heatserts.stl
images/Old_site/EuclidProbeEVAMount_M3PilotHoles-1.stl
images/Old_site/EuclidProbeEVAMount_M3PilotHoles.stl
images/Old_site/EuclidTappingJig.stl
images/Old_site/EuclidTappingJig0.stl
images/Old_site/Euclid_EVA_MountV3-1.stl
images/Old_site/Euclid_EVA_MountV3.stl
images/Old_site/Grafting_DockV3.stl
images/Old_site/Grafting_MountM2.stl
images/Old_site/MRW_SD_MountV6.stl
images/Old_site/Modular_Parts-1.stp
images/Old_site/OmronFotekTesterM3Tap.stl
images/Old_site/RCPetsfangDock.stl
images/Old_site/RCTopMount3.stl
images/Old_site/RCTopMountDock.stl
images/Old_site/RC_CornerDockV2.stl
images/Old_site/RC_CornerMountLongV2HtSrt-1.stl
images/Old_site/RC_CornerMountLongV2HtSrt.stl
images/Old_site/RC_CornerMountLongV2MePilot.stl
images/Old_site/RC_CornerMountShortV2HtSrt-1.stl
images/Old_site/RC_CornerMountShortV2HtSrt.stl
images/Old_site/RC_CornerMountShortV2M3Pilot-1.stl
images/Old_site/RC_CornerMountShortV2M3Pilot.stl
images/Old_site/RailCoreNativeMountV3.stl
images/Old_site/RailCoreNativeMountV3PIP.stl
images/Old_site/RailCorePfang.stl
images/Old_site/RailCore_1515_CornerMount_M3Heatsert.stl
images/Old_site/RailCore_1515_CornerMount_M3Pilot-1.stl
images/Old_site/RailCore_1515_CornerMount_M3Pilot.stl
images/Old_site/RailcoreMRWSDMountM3HtSrt-1.stl
images/Old_site/RailcoreMRWSDMountM3HtSrt.stl
images/Old_site/RailcoreMRWSDMountM3PilotHoles-1.stl
images/Old_site/RailcoreMRWSDMountM3PilotHoles.stl
images/Old_site/RailcoreMount713Native5.stl
images/Old_site/Railcore_1515_CornerDock.stl
images/Old_site/TopMountCloseV4.stl
images/Old_site/TopMountDockCloseV4.stl
images/Old_site/Voron2.4BedDockRev2.5-1.stl
images/Old_site/Voron2.4BedDockRev2.5.stl
images/Old_site/Voron2.4BedMountV2Rev2.6.stl
images/Old_site/VoronTridentBedMount-1.stl
images/Old_site/VoronTridentBedMount.stl
images/Old_site/Voron_Afterburner-NativeLeft.stl
images/Old_site/Voron_Afterburner-NativeRight.stl
images/Old_site/afterburner-nativeV3_Left.stl
images/Old_site/afterburner-nativeV3_Right.stl
