euclidprobe/euclidprobe.github.io/images/01-LED_Install.png

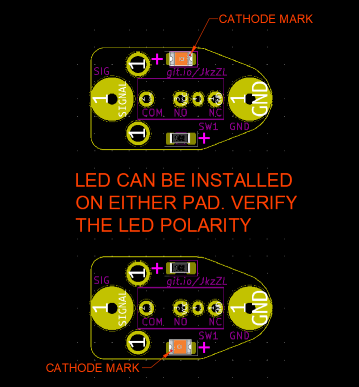
images/01-LED_Install.png
