euclidprobe/euclidprobe.github.io/images/01_assembly/01-switch_pins.jpg

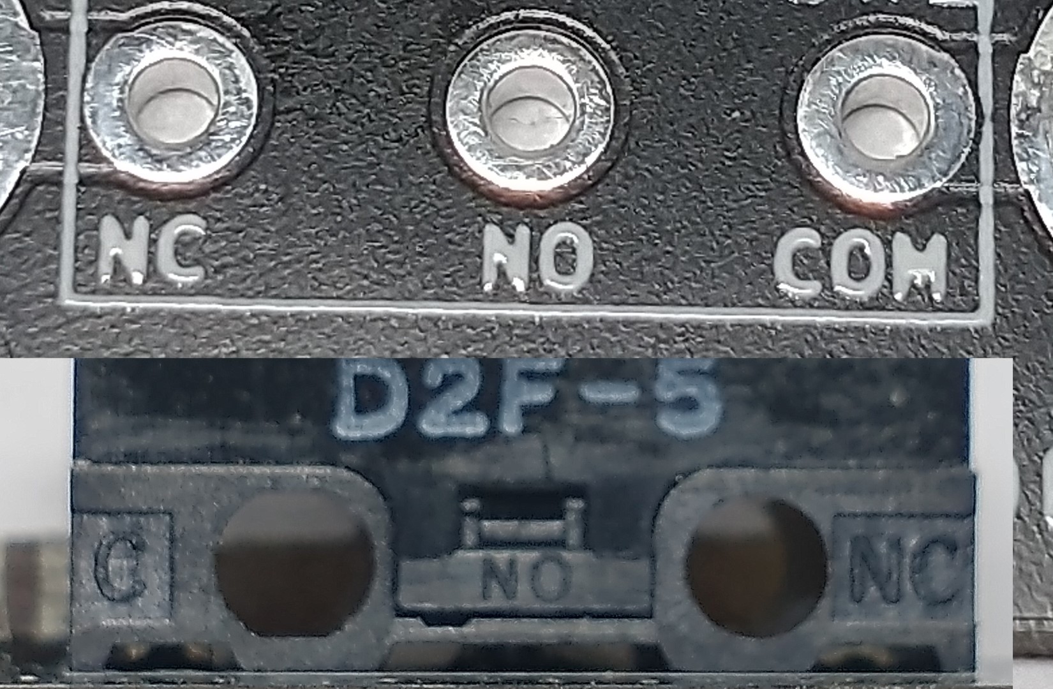
images/01_assembly/01-switch_pins.jpg
