euclidprobe/euclidprobe.github.io/images/01_assembly/01_insulate_clipd.jpg

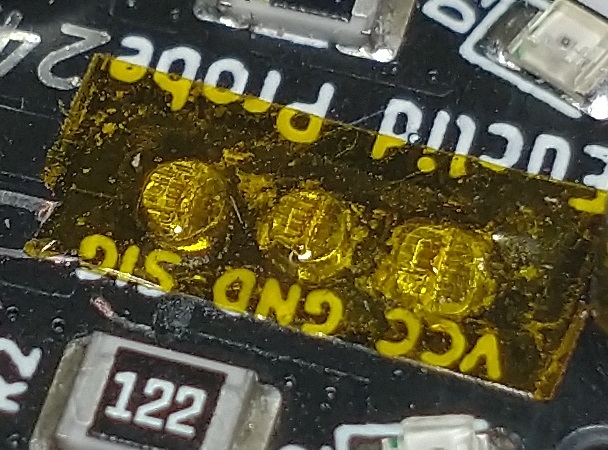
images/01_assembly/01_insulate_clipd.jpg
