euclidprobe/euclidprobe.github.io/images/01_assembly/01_jst-dtl.png

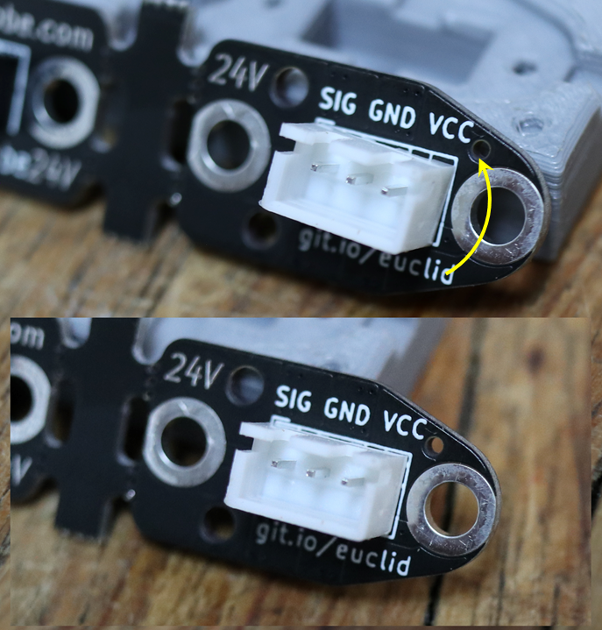
images/01_assembly/01_jst-dtl.png
