euclidprobe/euclidprobe.github.io/images/01_assembly/01_jst_solder.png

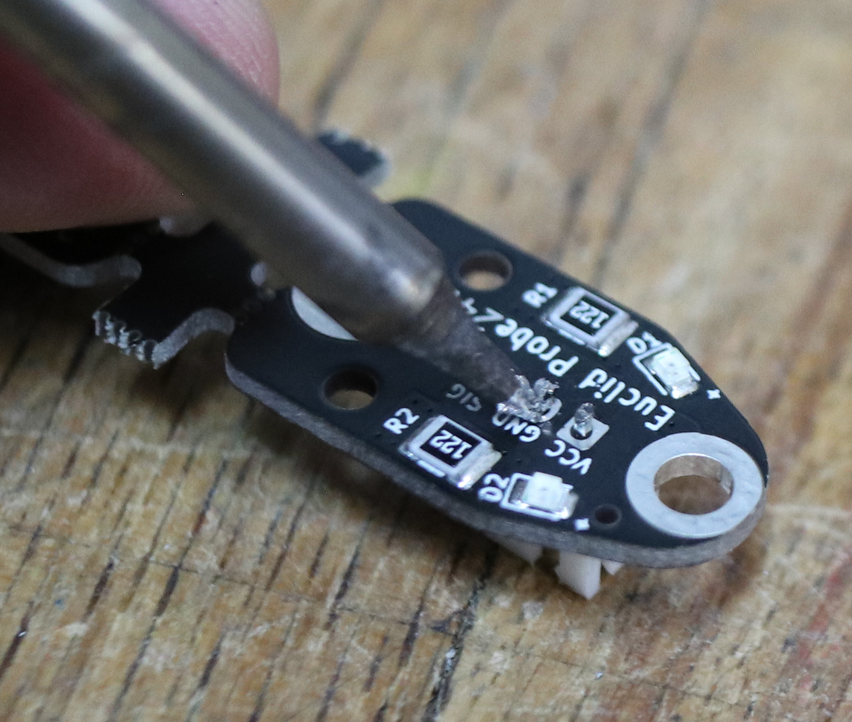
images/01_assembly/01_jst_solder.png
