euclidprobe/euclidprobe.github.io/images/01_assembly/01_kit_contents.jpg

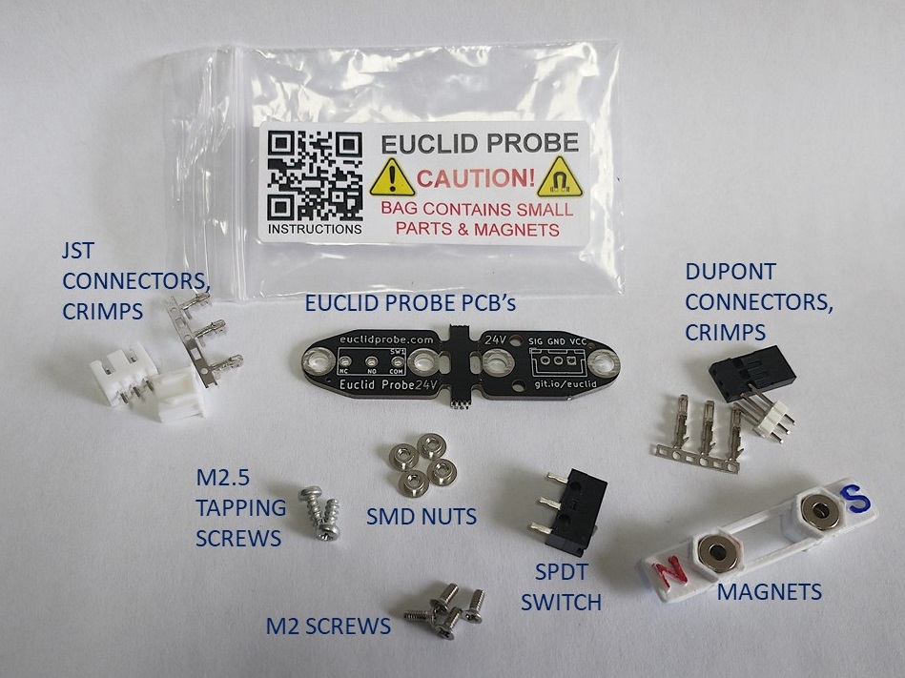
images/01_assembly/01_kit_contents.jpg
