euclidprobe/euclidprobe.github.io/images/01_assembly/01_mag_insertionB.jpg

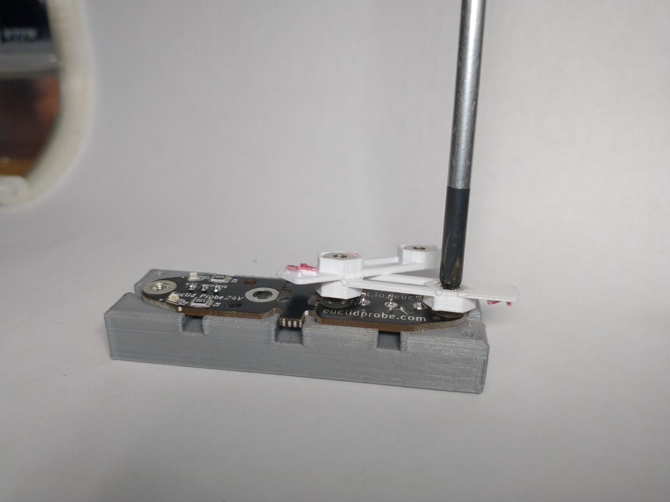
images/01_assembly/01_mag_insertionB.jpg
