euclidprobe/euclidprobe.github.io/images/01_assembly/01_mags_shipping.jpg

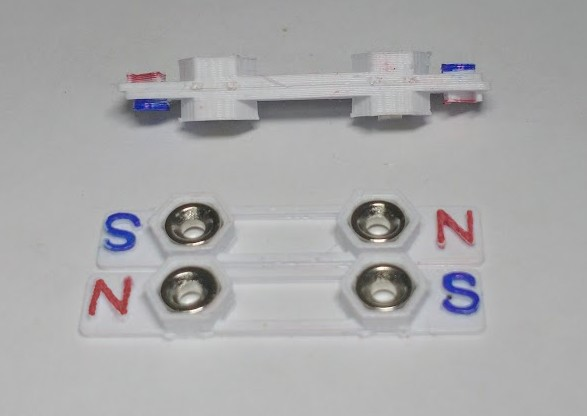
images/01_assembly/01_mags_shipping.jpg
