euclidprobe/euclidprobe.github.io/images/01_assembly/01_mountA.jpg

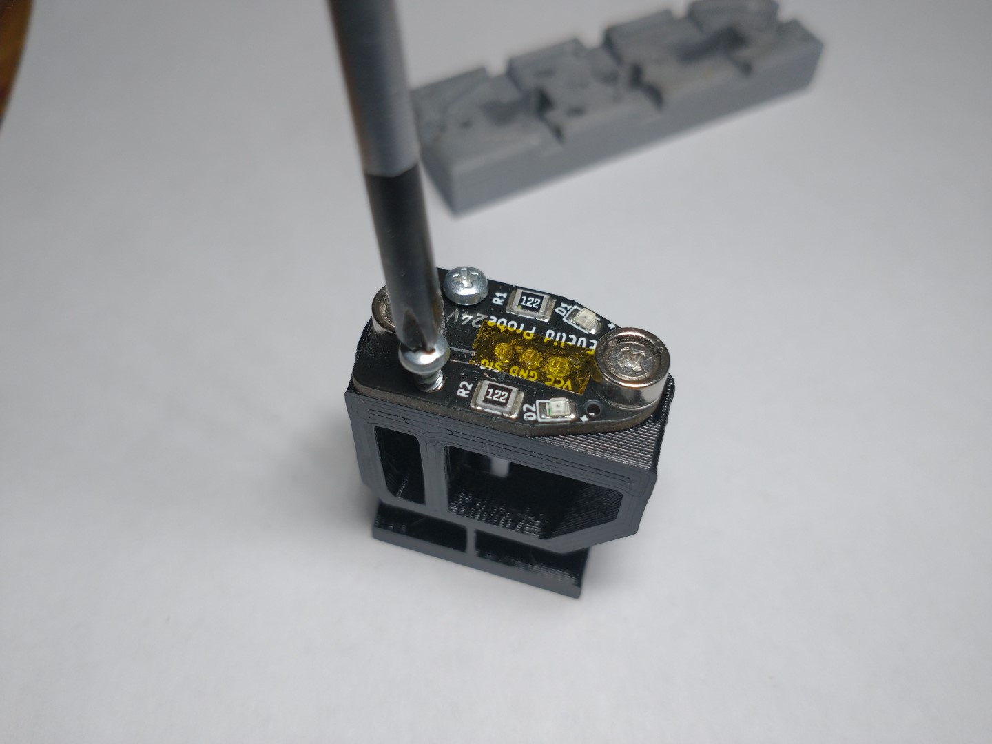
images/01_assembly/01_mountA.jpg
