euclidprobe/euclidprobe.github.io/images/01_assembly/01_mountB.jpg

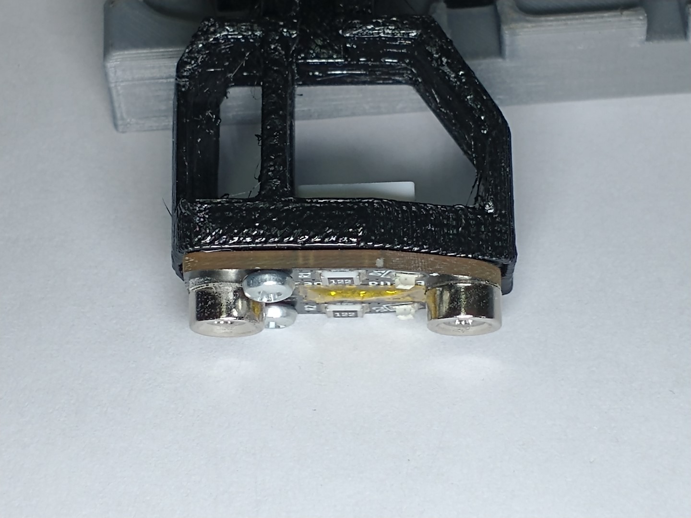
images/01_assembly/01_mountB.jpg
