euclidprobe/euclidprobe.github.io/images/01_assembly/01_pcb_smoothness.jpg

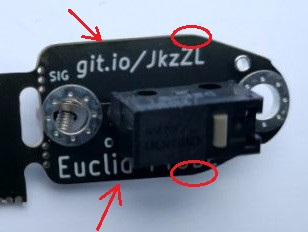
images/01_assembly/01_pcb_smoothness.jpg
