euclidprobe/euclidprobe.github.io/images/01_assembly/01_PCBA.jpg

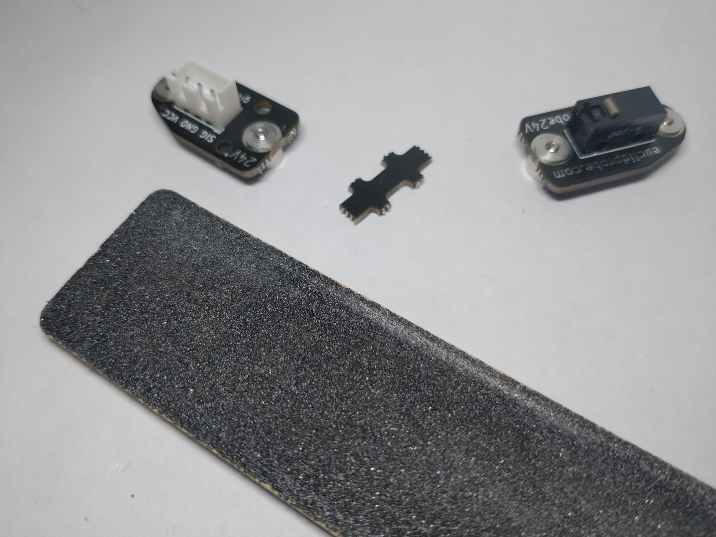
images/01_assembly/01_PCBA.jpg
