euclidprobe/euclidprobe.github.io/images/01_assembly/01_PCBB.jpg

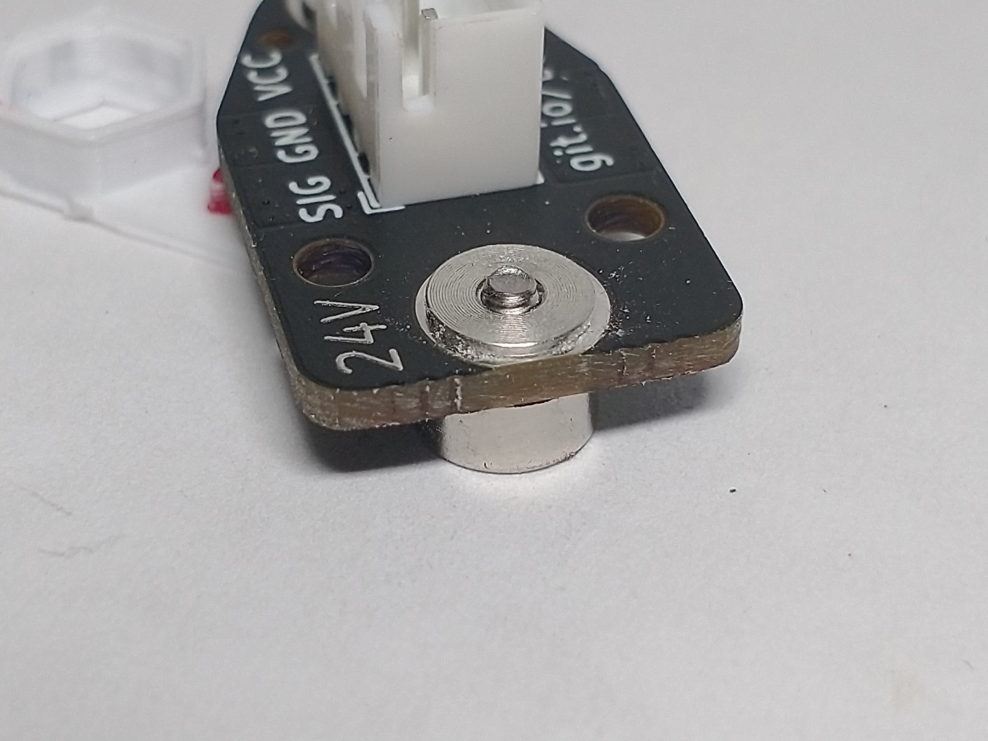
images/01_assembly/01_PCBB.jpg
