euclidprobe/euclidprobe.github.io/images/01_assembly/01_plunger_bias_front.jpg

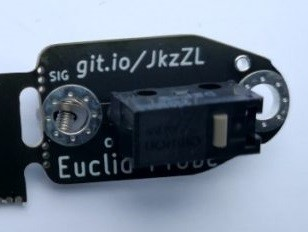
images/01_assembly/01_plunger_bias_front.jpg
