euclidprobe/euclidprobe.github.io/images/01_assembly/01_solder_jigA.jpg

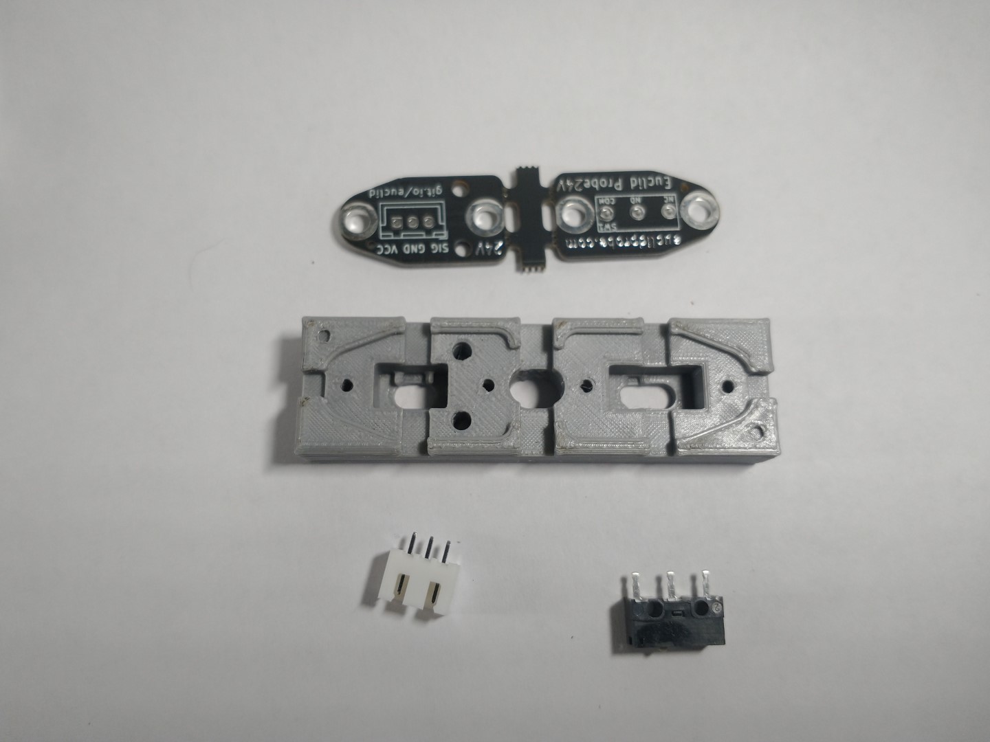
images/01_assembly/01_solder_jigA.jpg
