euclidprobe/euclidprobe.github.io/images/01_assembly/01_solder_jigB.jpg

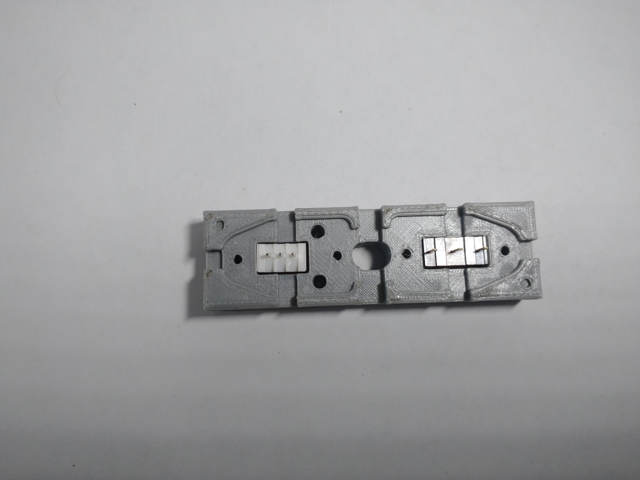
images/01_assembly/01_solder_jigB.jpg
