euclidprobe/euclidprobe.github.io/images/01_assembly/01_solder_jigC.jpg

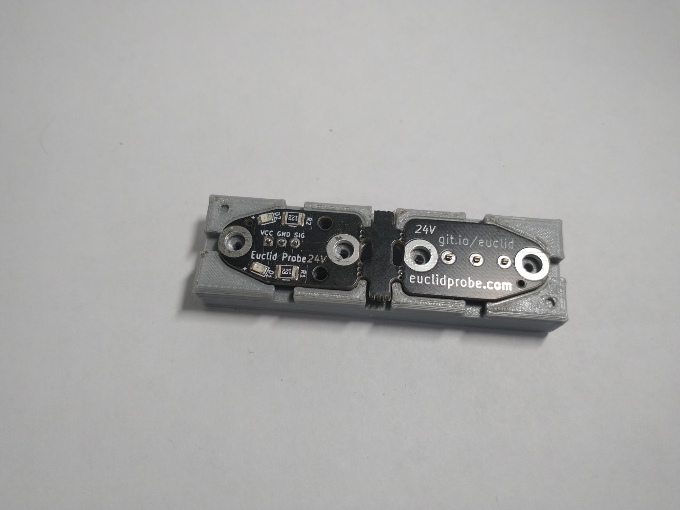
images/01_assembly/01_solder_jigC.jpg
