euclidprobe/euclidprobe.github.io/images/01_assembly/01_solder_jigE.JPG

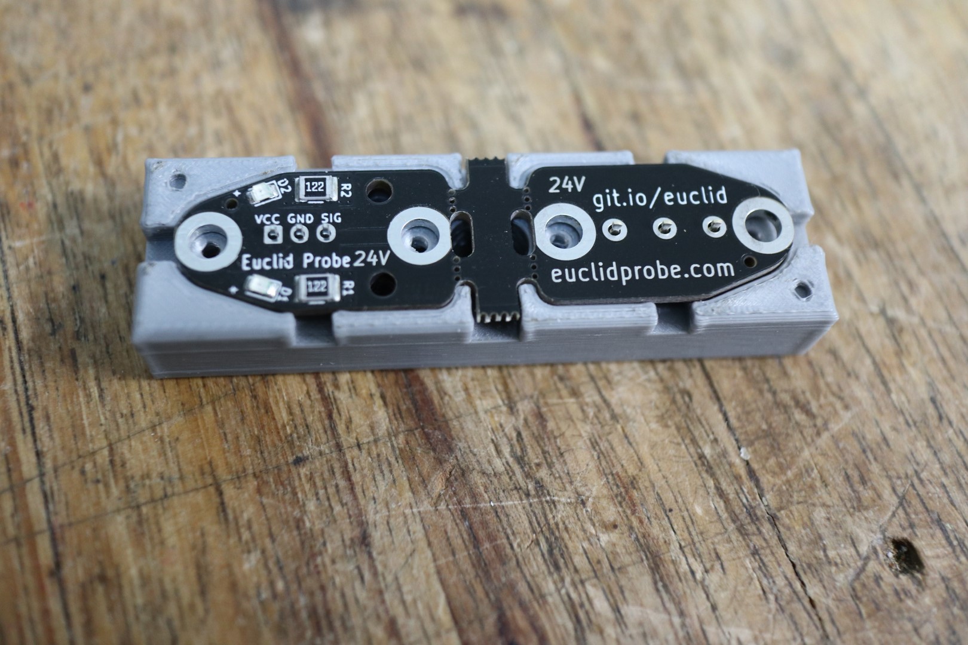
images/01_assembly/01_solder_jigE.JPG
