euclidprobe/euclidprobe.github.io/images/01_assembly/01_solder_jigF.jpg

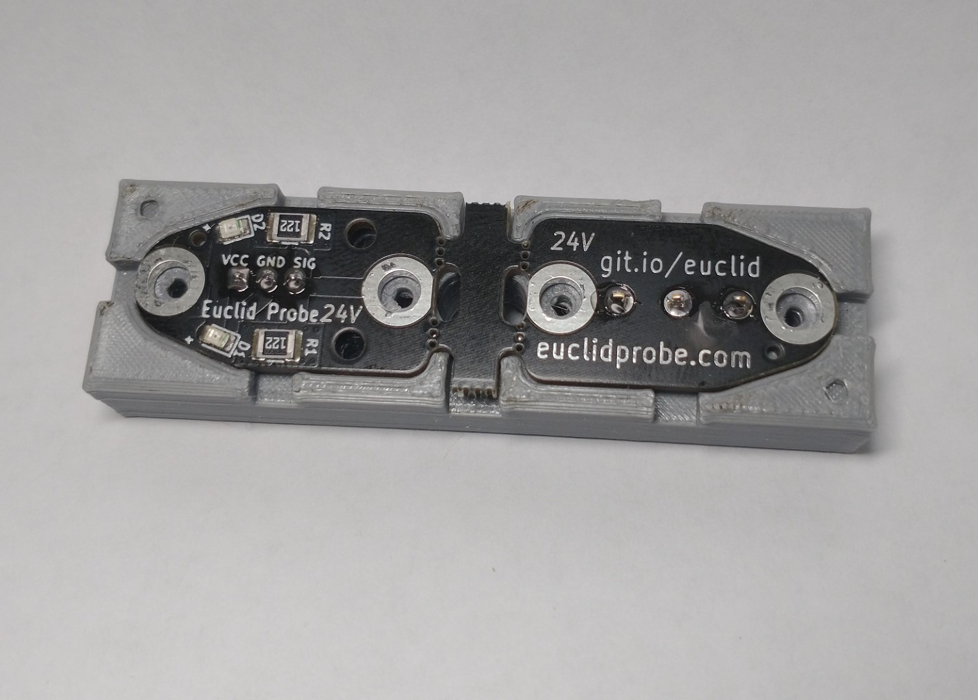
images/01_assembly/01_solder_jigF.jpg
