euclidprobe/euclidprobe.github.io/images/01_assembly/01_switch-dtl.png

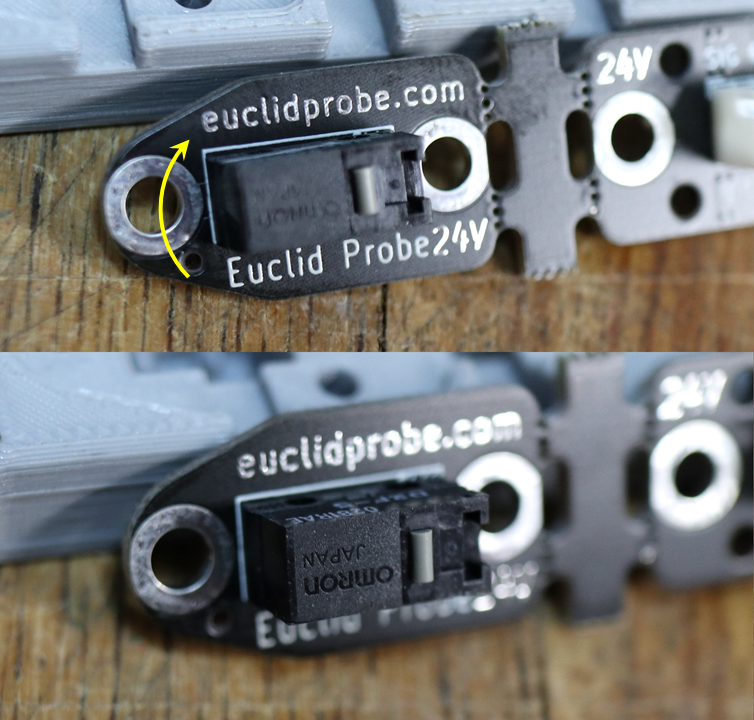
images/01_assembly/01_switch-dtl.png
