euclidprobe/euclidprobe.github.io/images/01_assembly/3.3V.jpg

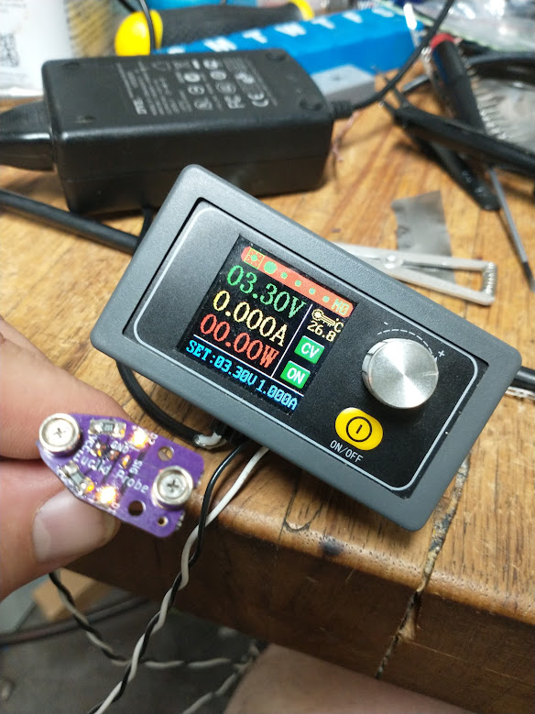
images/01_assembly/3.3V.jpg
