euclidprobe/euclidprobe.github.io/images/01_assembly/5V.jpg

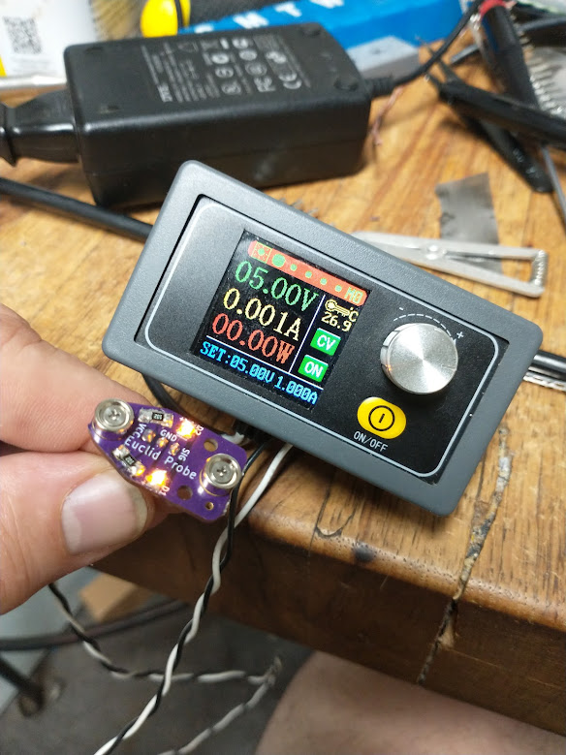
images/01_assembly/5V.jpg
