euclidprobe/euclidprobe.github.io/images/01_assembly/24V.jpg

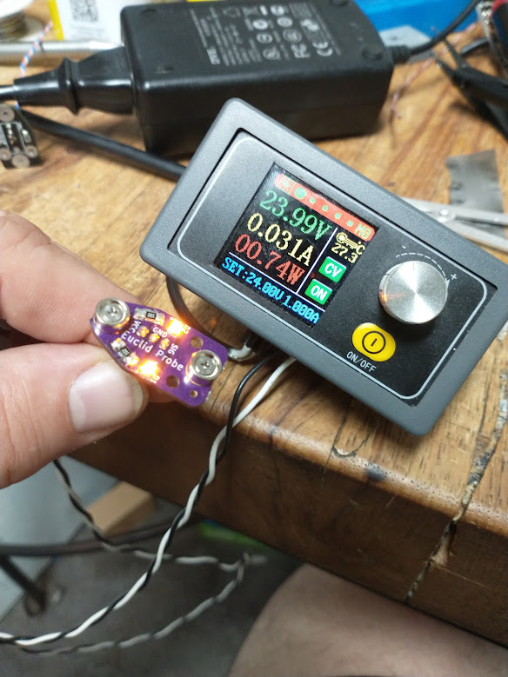
images/01_assembly/24V.jpg
