euclidprobe/euclidprobe.github.io/images/01_assembly/baggie-300x202.jpg

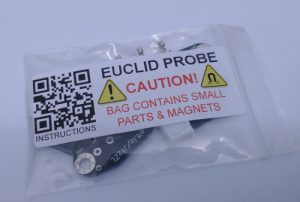
images/01_assembly/baggie-300x202.jpg
