euclidprobe/euclidprobe.github.io/images/01_assembly/IMG_20220206_114903771.jpg

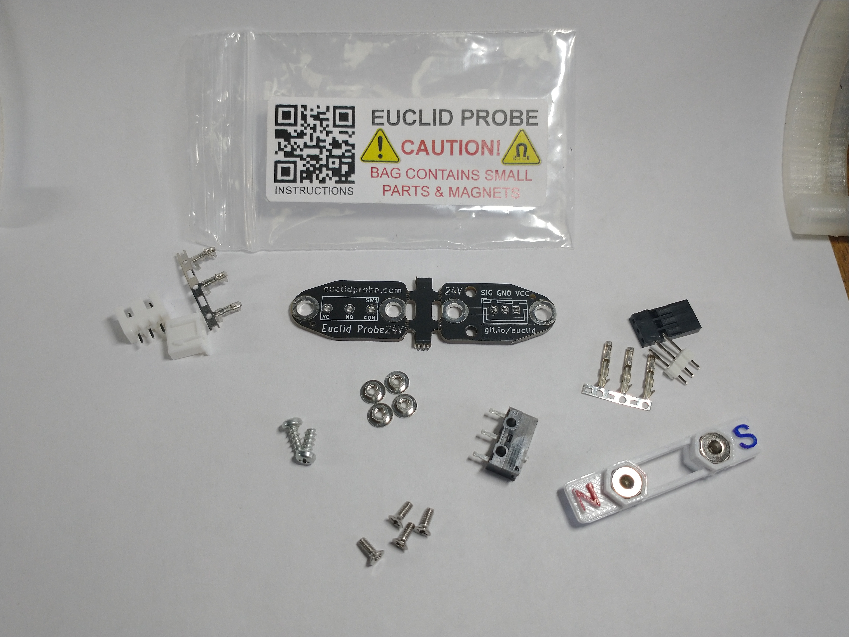
images/01_assembly/IMG_20220206_114903771.jpg
