euclidprobe/euclidprobe.github.io/images/01_assembly/IMG_20220206_115905781.jpg

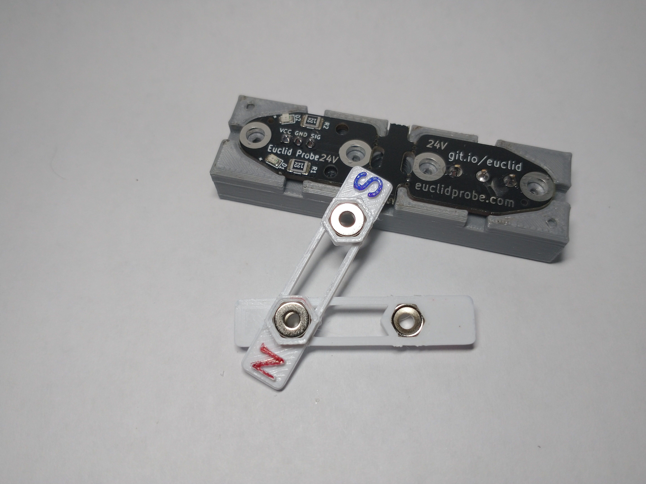
images/01_assembly/IMG_20220206_115905781.jpg
