euclidprobe/euclidprobe.github.io/images/01_assembly/IMG_20220206_115943464.jpg

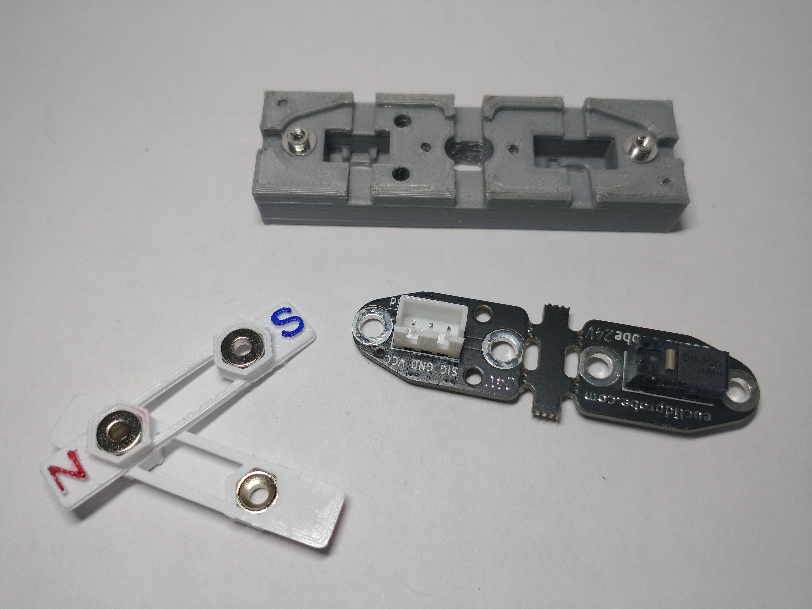
images/01_assembly/IMG_20220206_115943464.jpg
