euclidprobe/euclidprobe.github.io/images/01_assembly/IMG_20220206_120507253.jpg

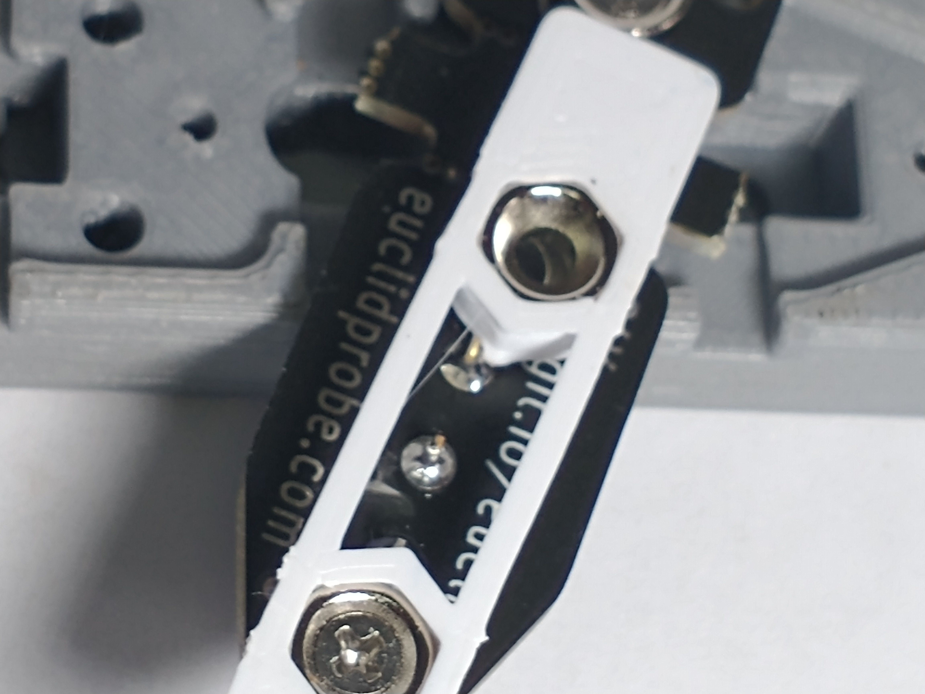
images/01_assembly/IMG_20220206_120507253.jpg
