euclidprobe/euclidprobe.github.io/images/01_assembly/IMG_20220206_120600603.jpg

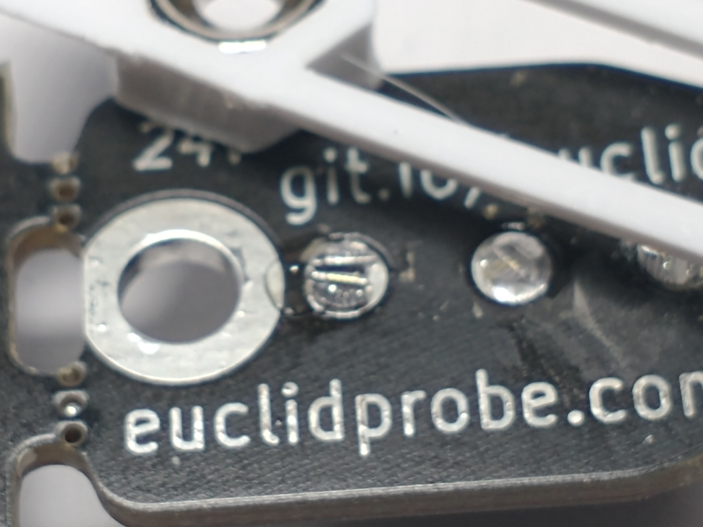
images/01_assembly/IMG_20220206_120600603.jpg
