euclidprobe/euclidprobe.github.io/images/01_assembly/IMG_20220206_121401530.jpg

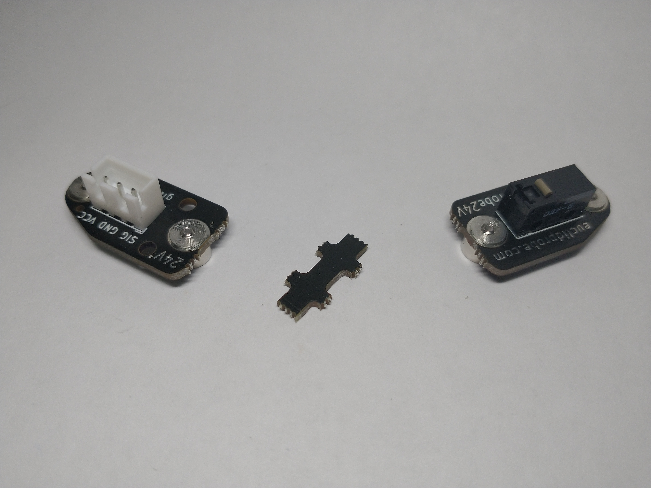
images/01_assembly/IMG_20220206_121401530.jpg
