euclidprobe/euclidprobe.github.io/images/01_assembly/IMG_20220206_121728274_BURST000_COVER.jpg

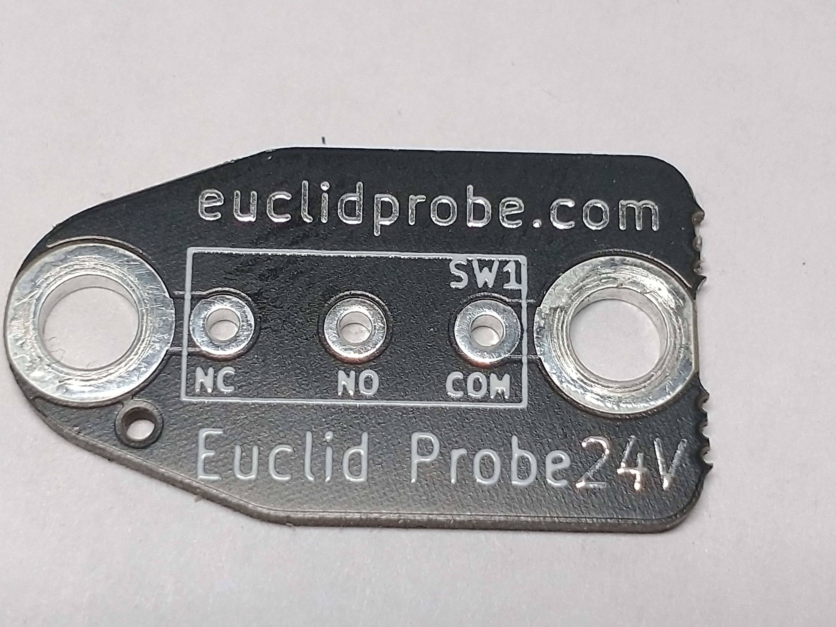
images/01_assembly/IMG_20220206_121728274_BURST000_COVER.jpg
