euclidprobe/euclidprobe.github.io/images/01_assembly/IMG_20220206_121804497.jpg

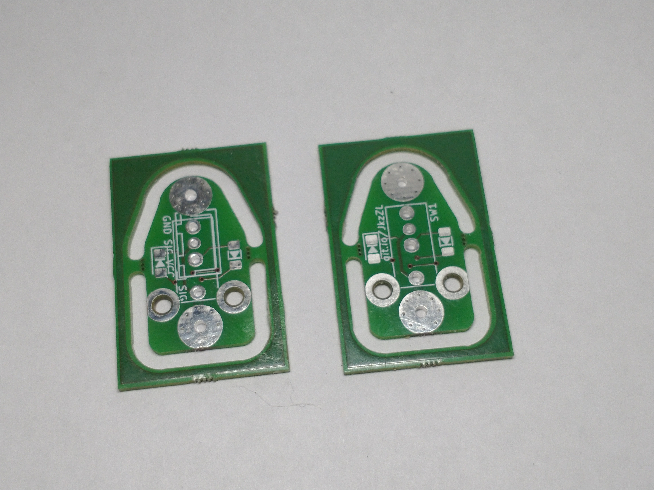
images/01_assembly/IMG_20220206_121804497.jpg
