euclidprobe/euclidprobe.github.io/images/01_assembly/IMG_20220206_122337664.jpg

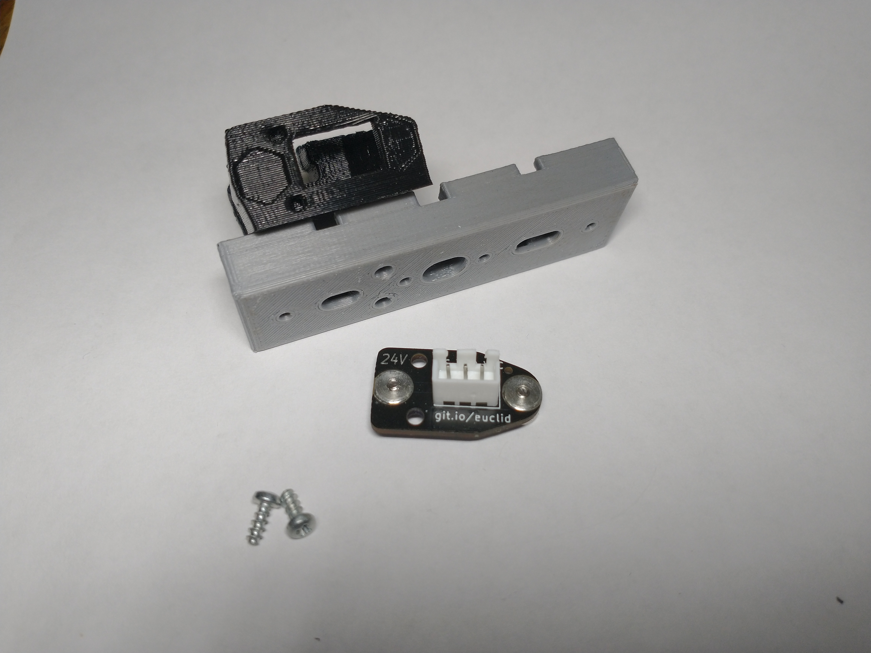
images/01_assembly/IMG_20220206_122337664.jpg
