euclidprobe/euclidprobe.github.io/images/01_assembly/IMG_20220206_122435717.jpg

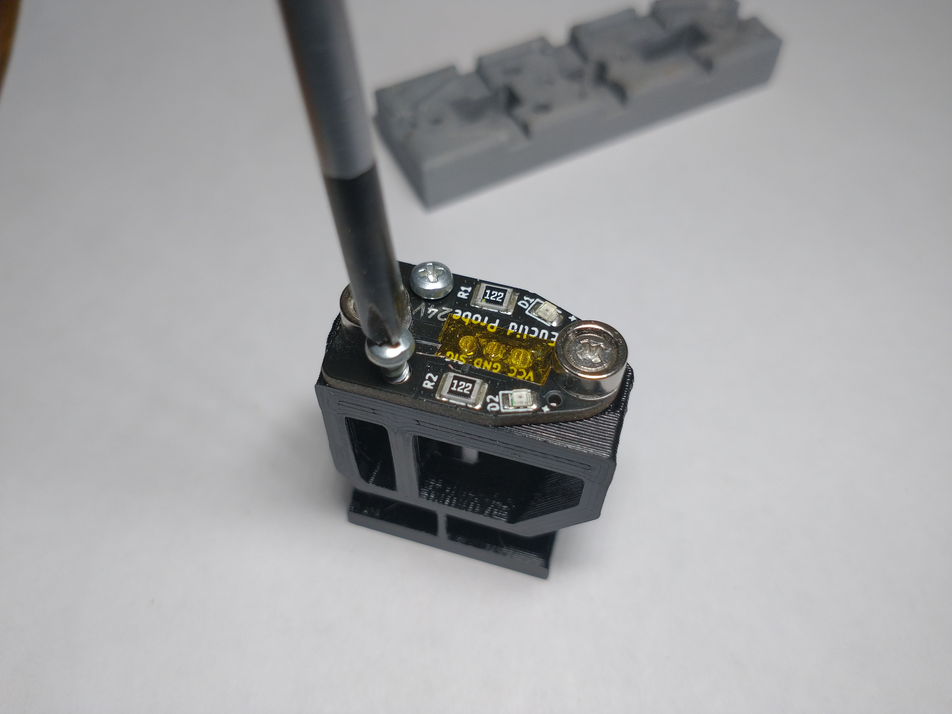
images/01_assembly/IMG_20220206_122435717.jpg
