euclidprobe/euclidprobe.github.io/images/01_assembly/IMG_20220206_122453520.jpg

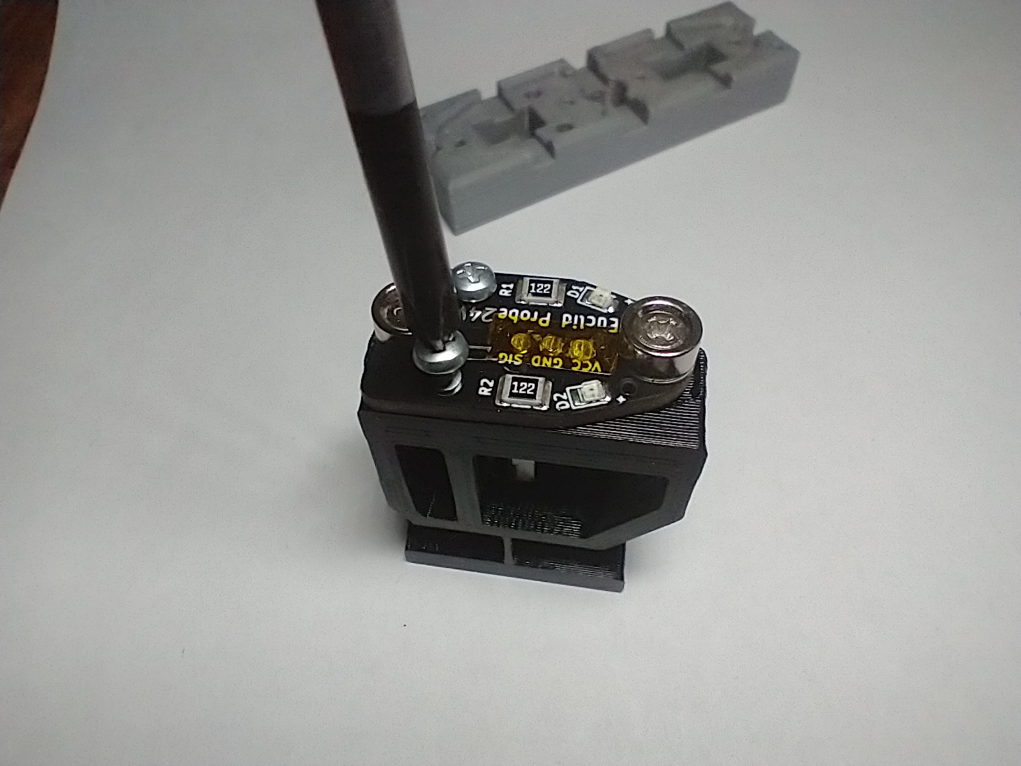
images/01_assembly/IMG_20220206_122453520.jpg
