euclidprobe/euclidprobe.github.io/images/01_assembly/IMG_20220206_122454851.jpg

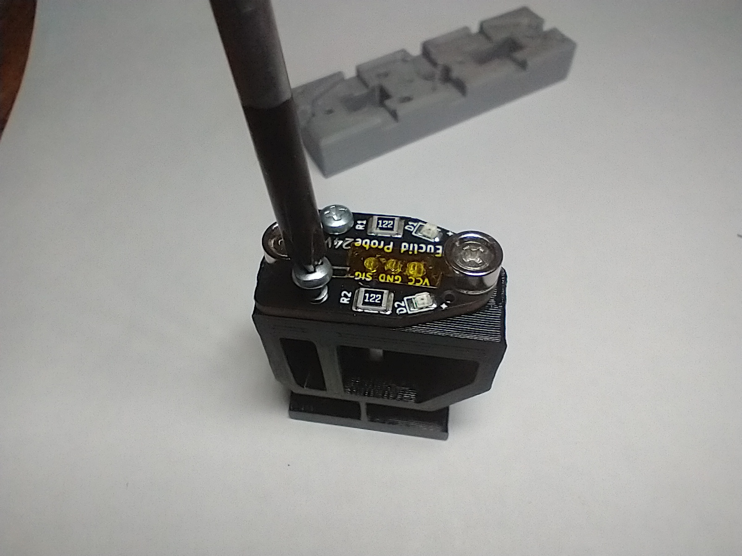
images/01_assembly/IMG_20220206_122454851.jpg
