euclidprobe/euclidprobe.github.io/images/01_assembly/mag_train.png

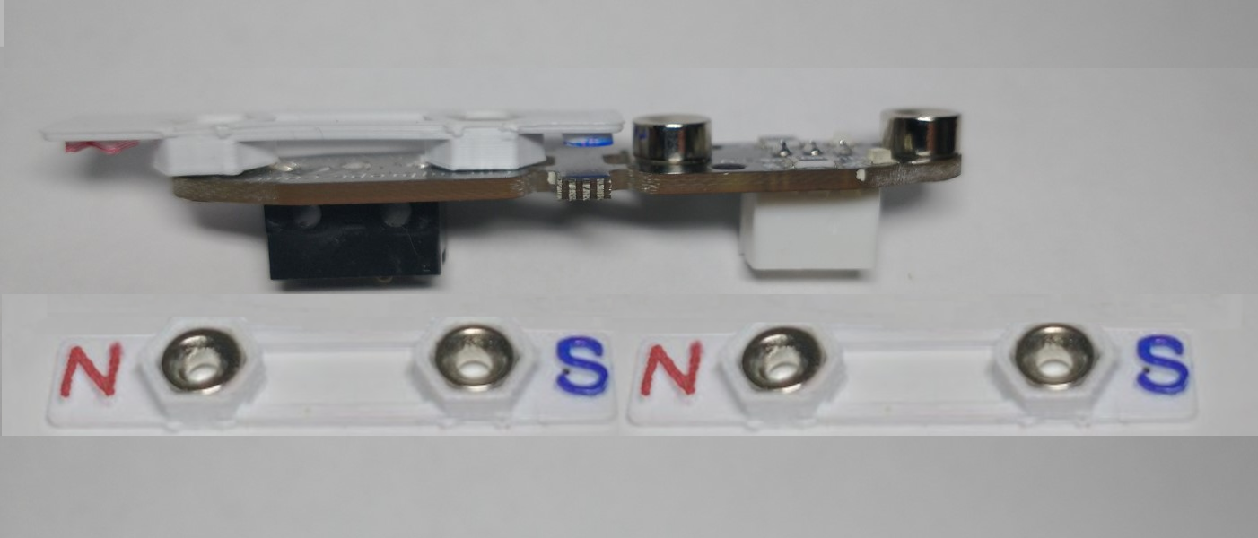
images/01_assembly/mag_train.png
