euclidprobe/euclidprobe.github.io/images/01_assembly/magprep1-150x150.jpg

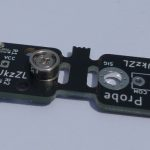
images/01_assembly/magprep1-150x150.jpg
