euclidprobe/euclidprobe.github.io/images/01_assembly/magprep1.jpg

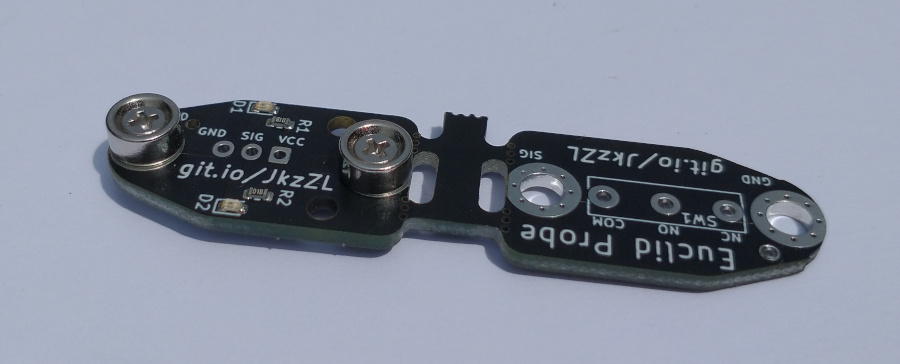
images/01_assembly/magprep1.jpg
