euclidprobe/euclidprobe.github.io/images/01_assembly/SolderPrep2.jpg

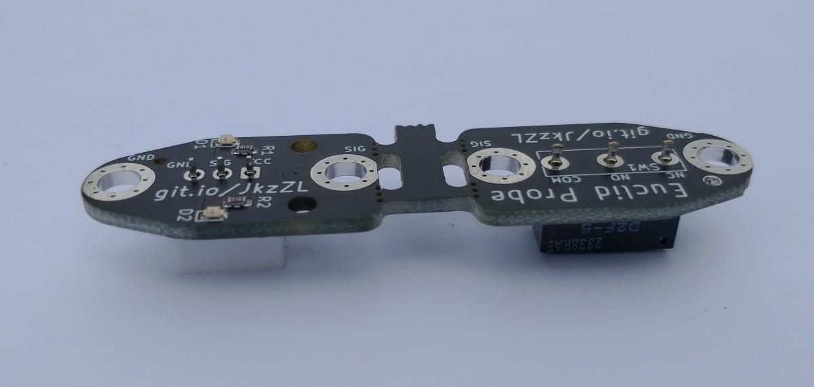
images/01_assembly/SolderPrep2.jpg
