euclidprobe/euclidprobe.github.io/images/01_assembly/SolderPrep.jpg

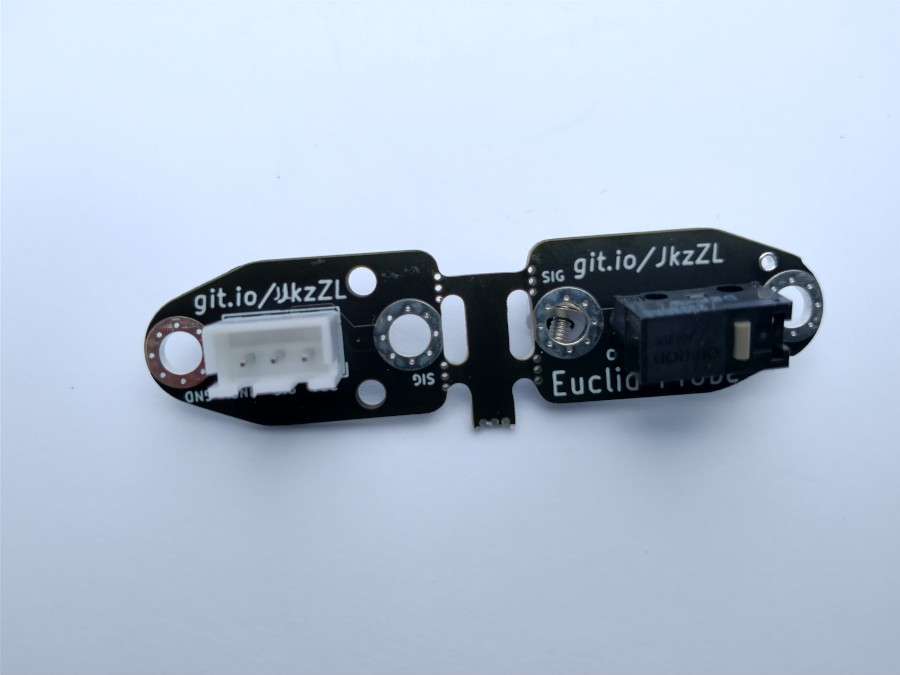
images/01_assembly/SolderPrep.jpg
