euclidprobe/euclidprobe.github.io/images/02-VCore/Print_Orientation.png

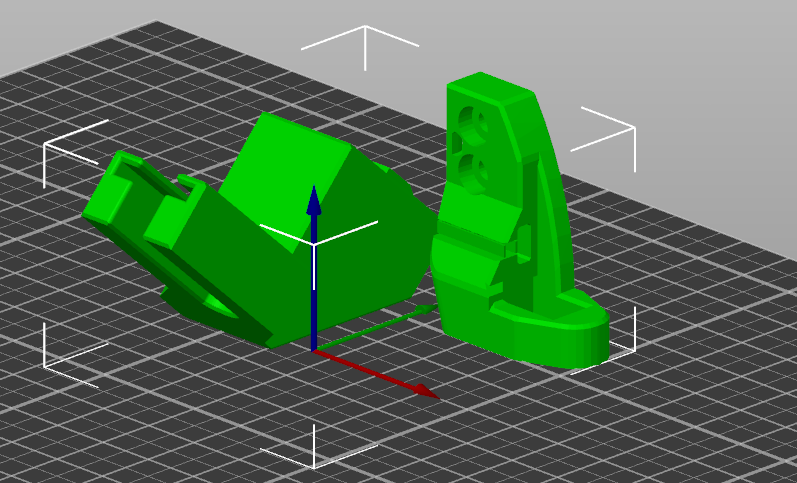
images/02-VCore/Print_Orientation.png
