euclidprobe/euclidprobe.github.io/images/04-wiring/boards_BTT/Slide4.PNG

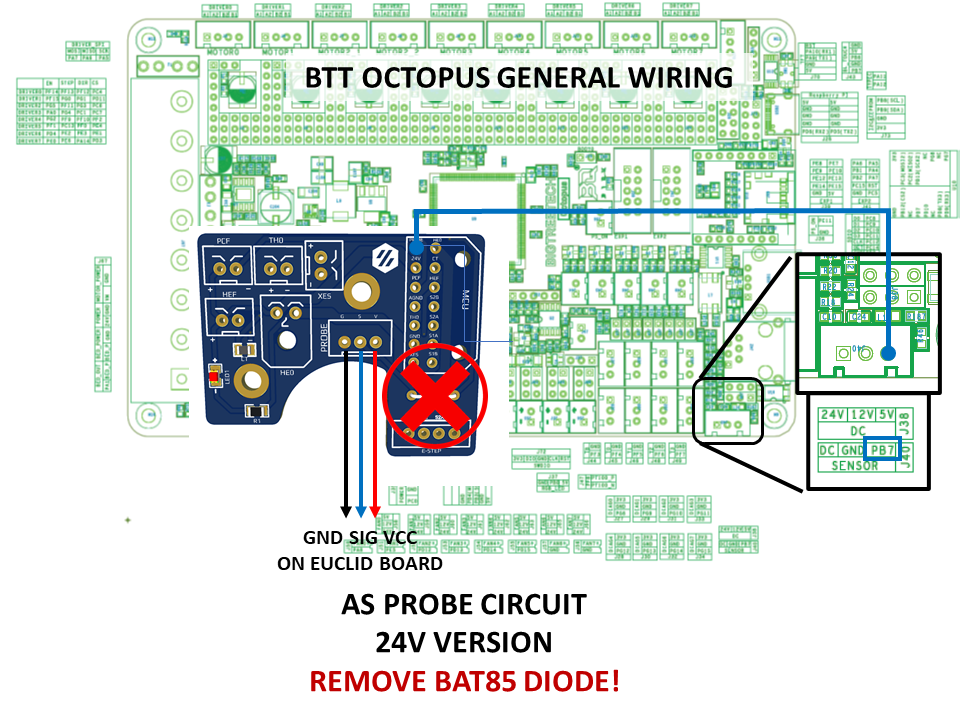
images/04-wiring/boards_BTT/Slide4.PNG
