euclidprobe/euclidprobe.github.io/images/04-wiring/boards_BTT/Slide5.PNG

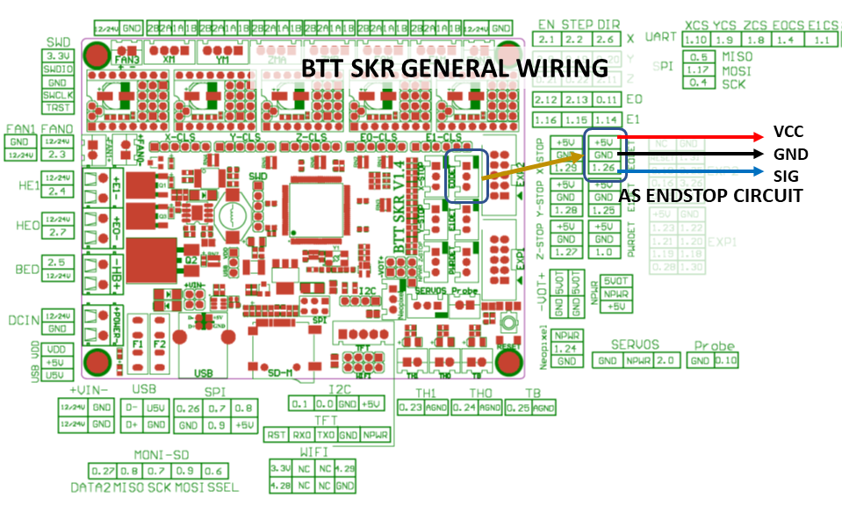
images/04-wiring/boards_BTT/Slide5.PNG
