euclidprobe/euclidprobe.github.io/images/04-wiring/boards_BTT/Slide13.PNG

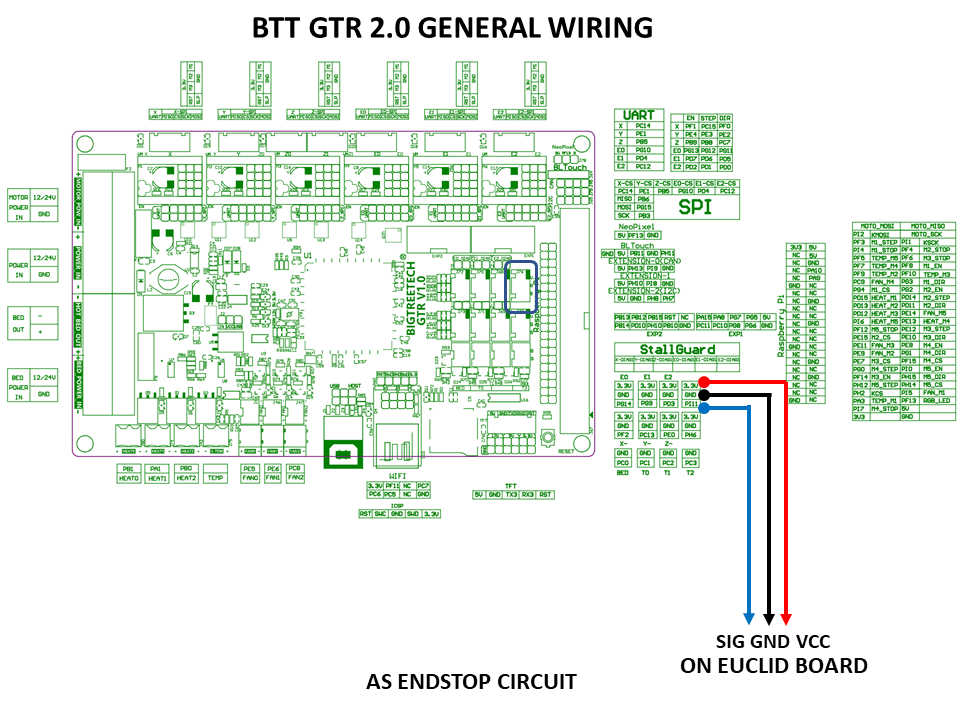
images/04-wiring/boards_BTT/Slide13.PNG
