euclidprobe/euclidprobe.github.io/images/04-wiring/boards_Duet/Slide4.PNG

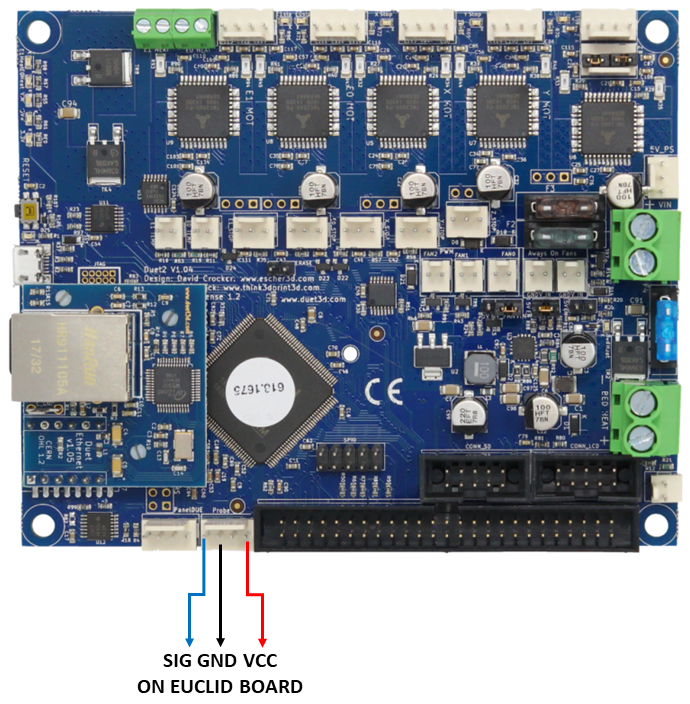
images/04-wiring/boards_Duet/Slide4.PNG
