euclidprobe/euclidprobe.github.io/images/04-wiring/boards_Duet/Slide7.png

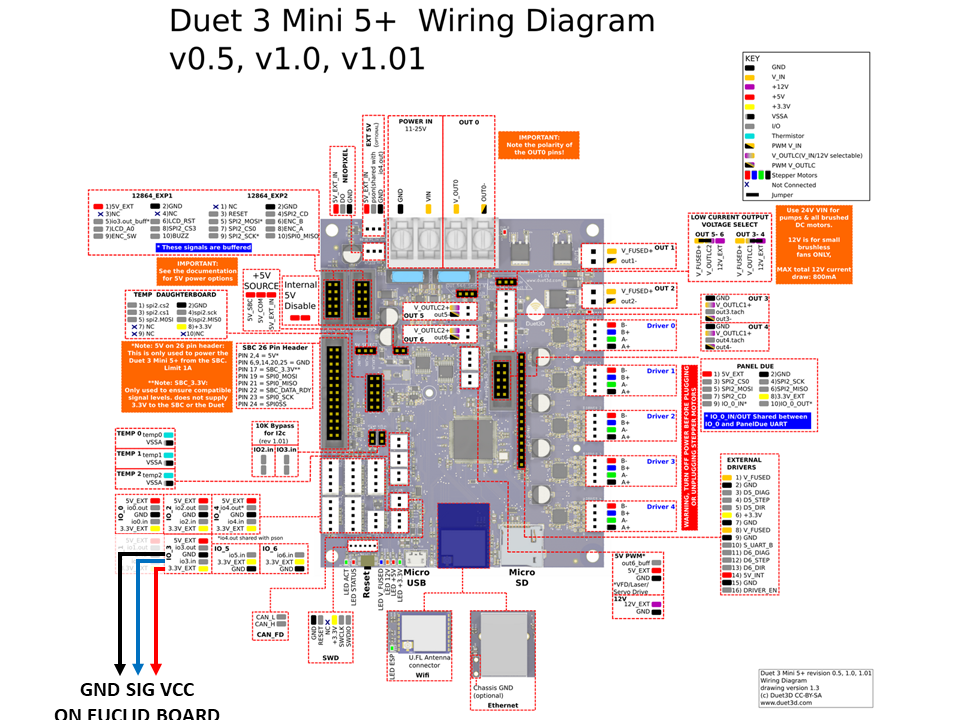
images/04-wiring/boards_Duet/Slide7.png
