euclidprobe/euclidprobe.github.io/images/04-wiring/boards_Fly/Slide2.PNG

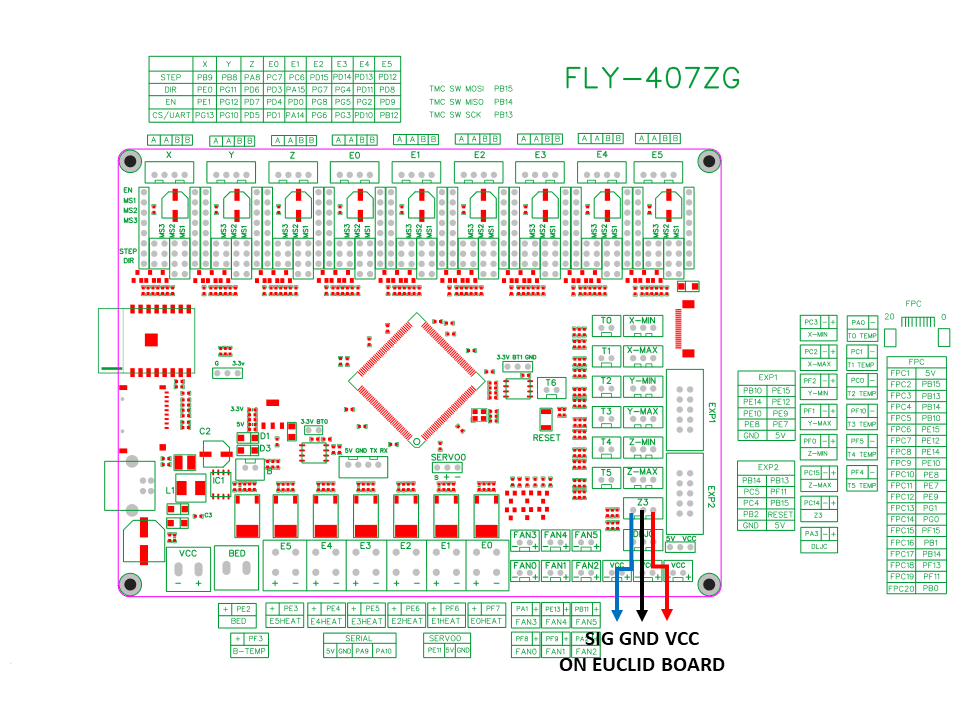
images/04-wiring/boards_Fly/Slide2.PNG
