euclidprobe/euclidprobe.github.io/images/04-wiring/boards_Fly/Slide3.PNG

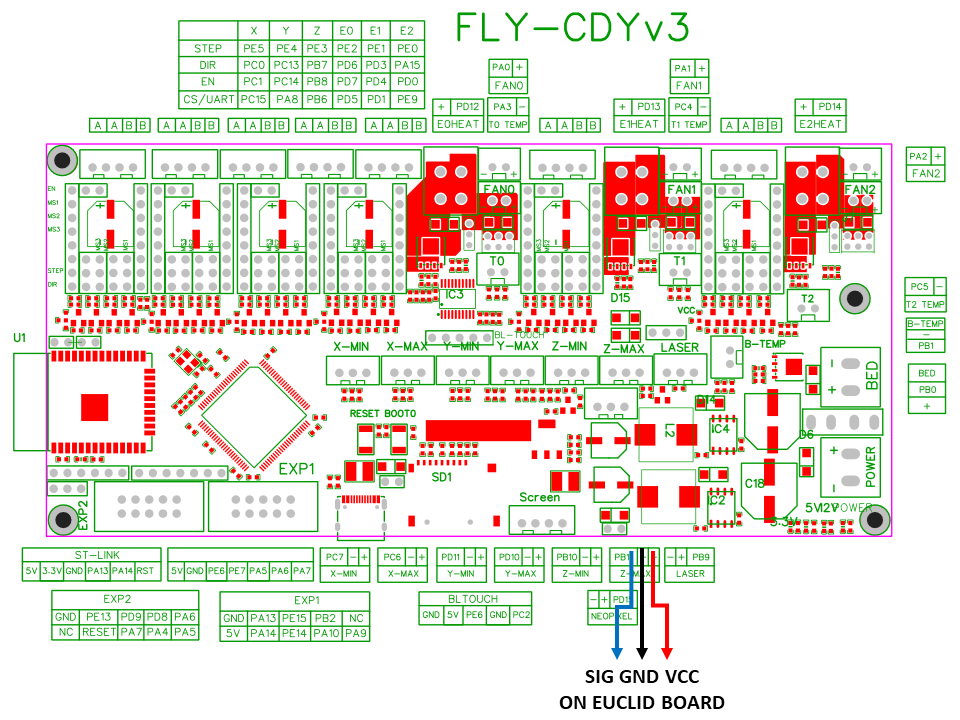
images/04-wiring/boards_Fly/Slide3.PNG
