euclidprobe/euclidprobe.github.io/images/04-wiring/boards_Fly/Slide4.PNG

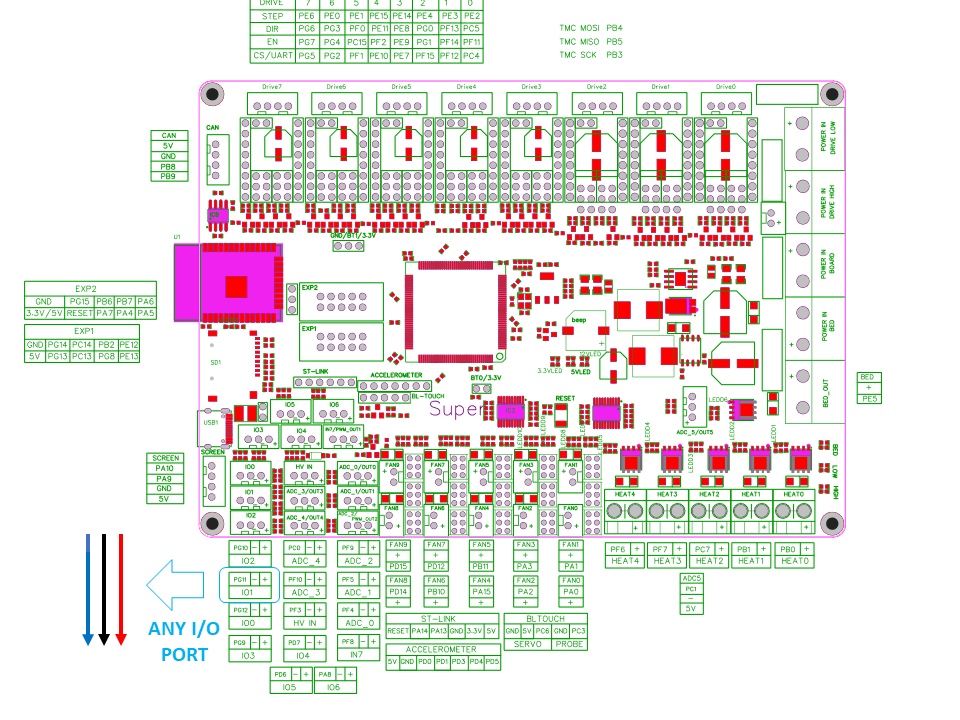
images/04-wiring/boards_Fly/Slide4.PNG
