euclidprobe/euclidprobe.github.io/images/04-wiring/boards_misc/Slide1.PNG

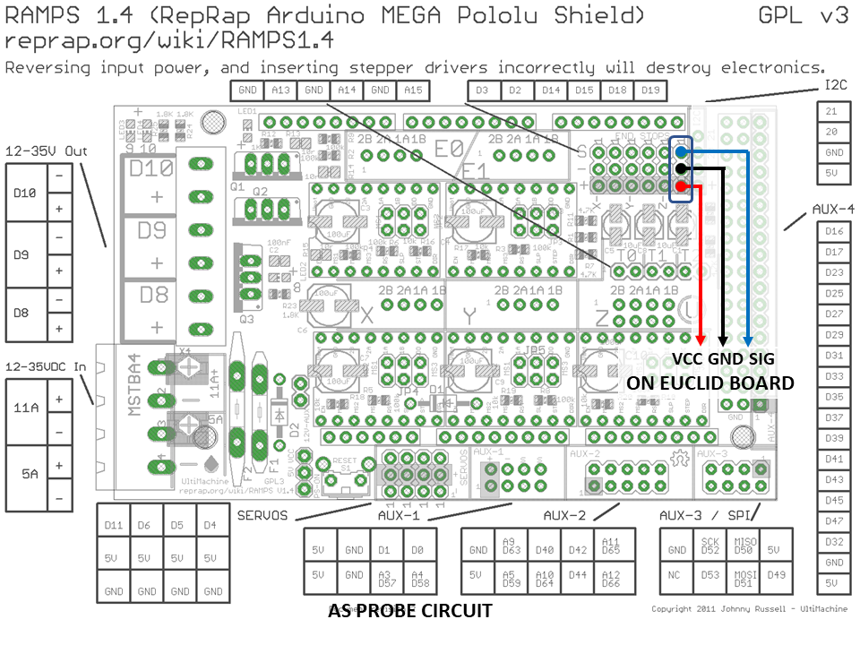
images/04-wiring/boards_misc/Slide1.PNG
