euclidprobe/euclidprobe.github.io/images/04-wiring/boards_misc/Slide2.PNG

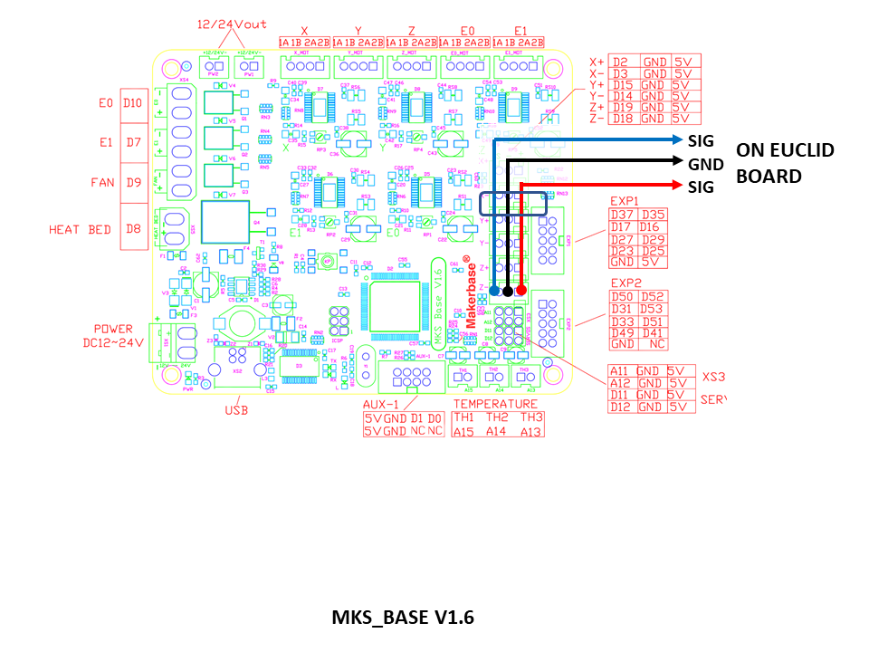
images/04-wiring/boards_misc/Slide2.PNG
