euclidprobe/euclidprobe.github.io/images/04-wiring/boards_misc/Slide3.PNG

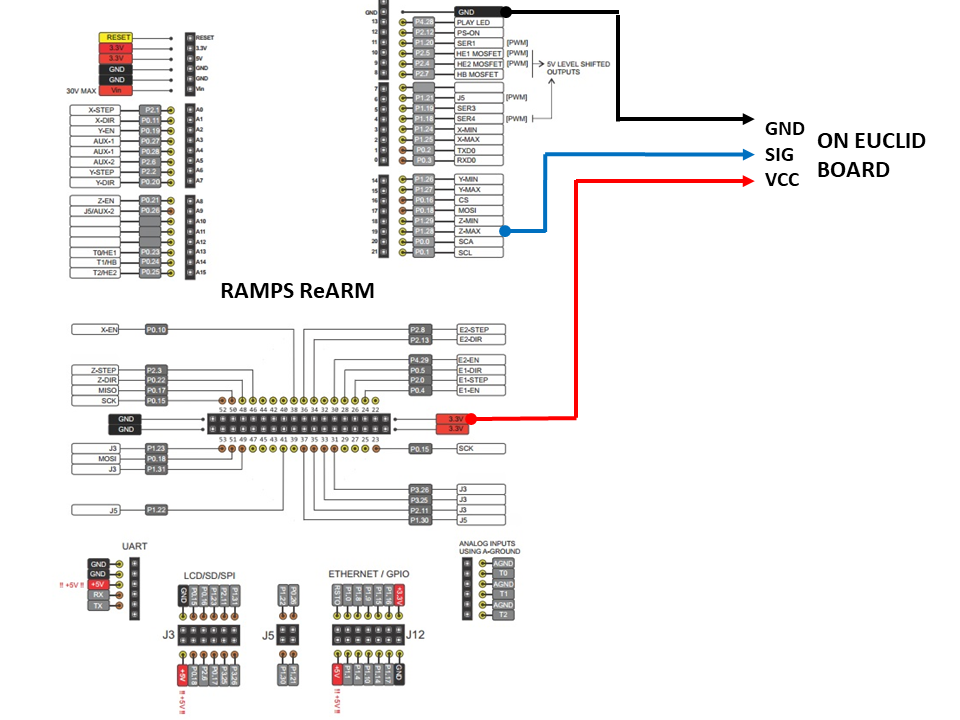
images/04-wiring/boards_misc/Slide3.PNG
