euclidprobe/euclidprobe.github.io/images/04-wiring/boards_misc/Slide5.PNG

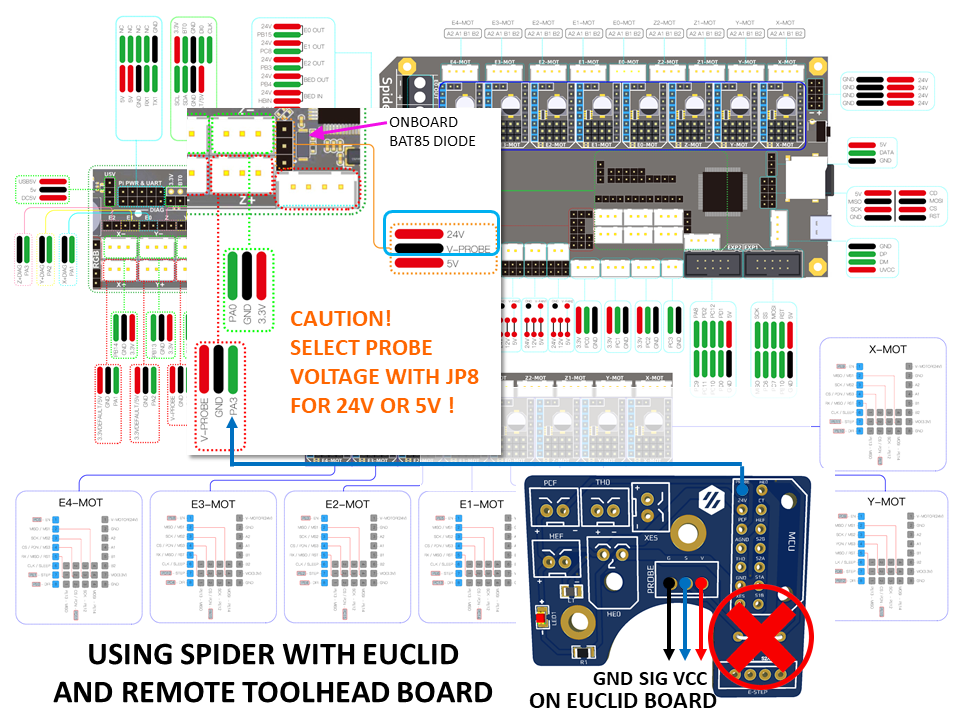
images/04-wiring/boards_misc/Slide5.PNG
