euclidprobe/euclidprobe.github.io/images/04-wiring/boards_misc/smoothieV1.png

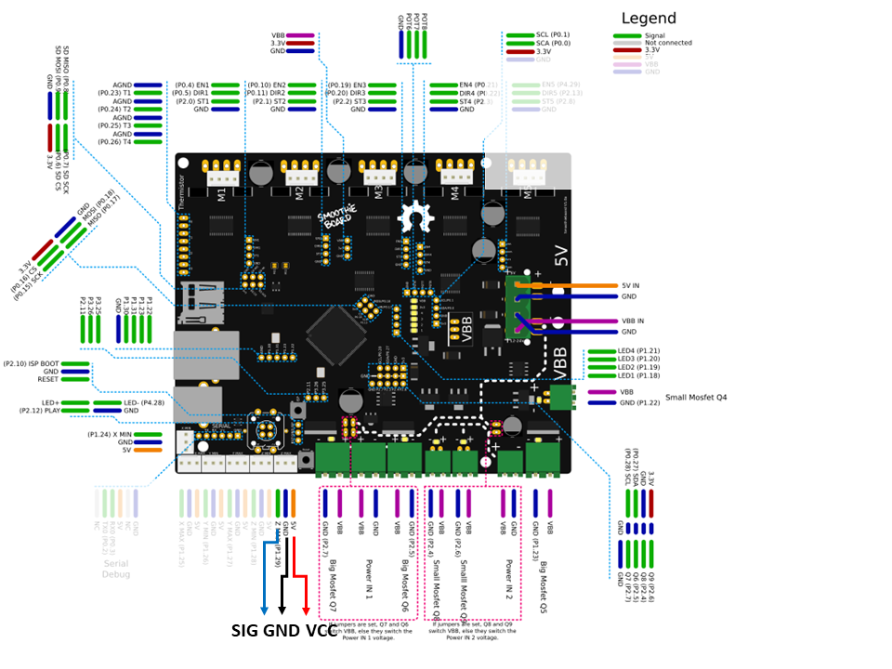
images/04-wiring/boards_misc/smoothieV1.png
