euclidprobe/euclidprobe.github.io/images/00-ProbeTest57_19_45-768x559.png

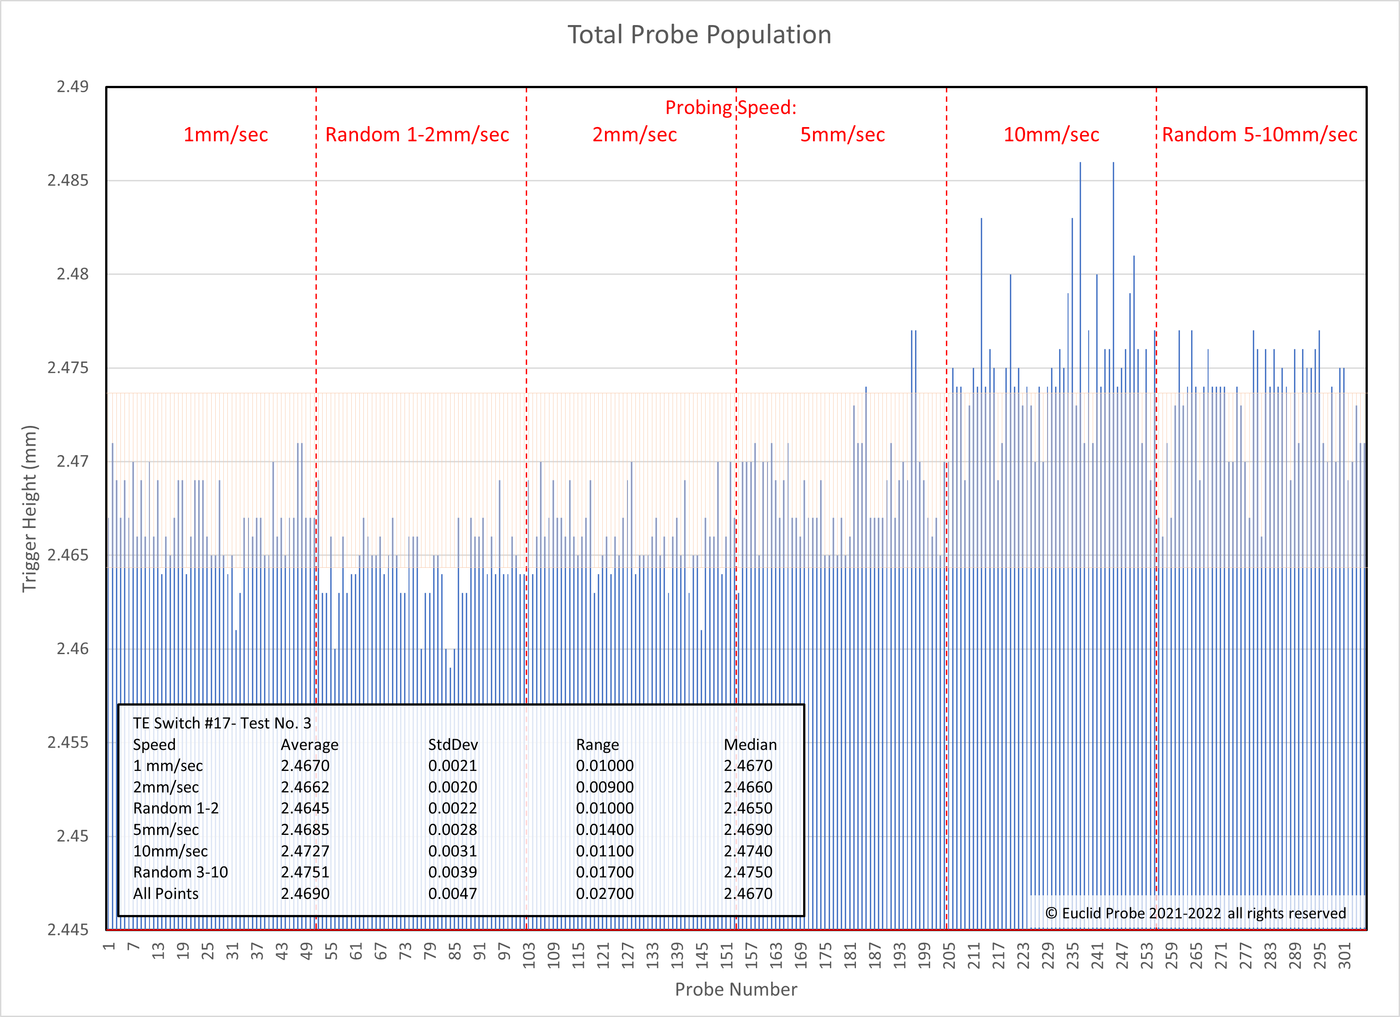
images/00-ProbeTest57_19_45-768x559.png
