euclidprobe/euclidprobe.github.io/images/troubleshooting/20230118_174606.jpg

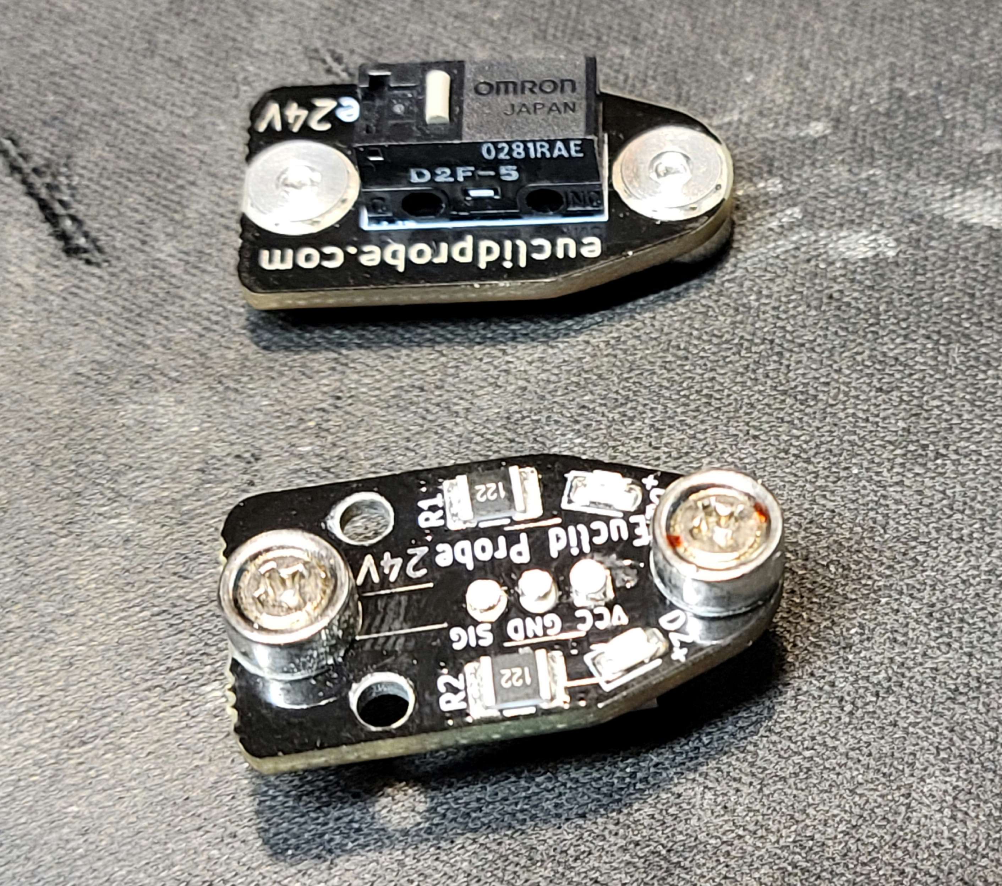
images/troubleshooting/20230118_174606.jpg
