euclidprobe/euclidprobe.github.io/images/troubleshooting/20230118_174620.jpg

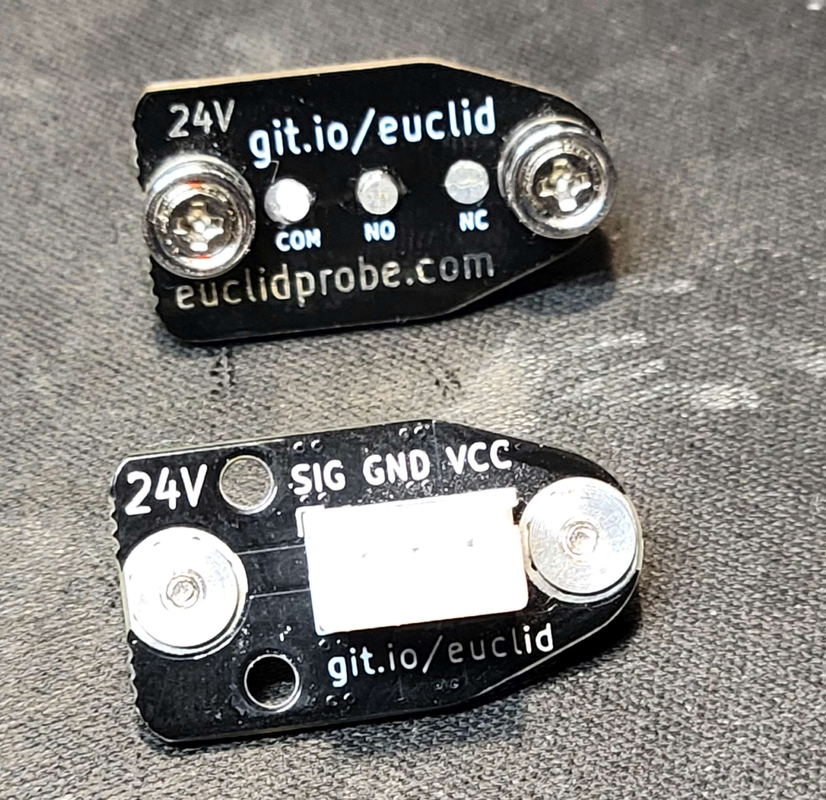
images/troubleshooting/20230118_174620.jpg
