euclidprobe/euclidprobe.github.io/images/troubleshooting/image.png

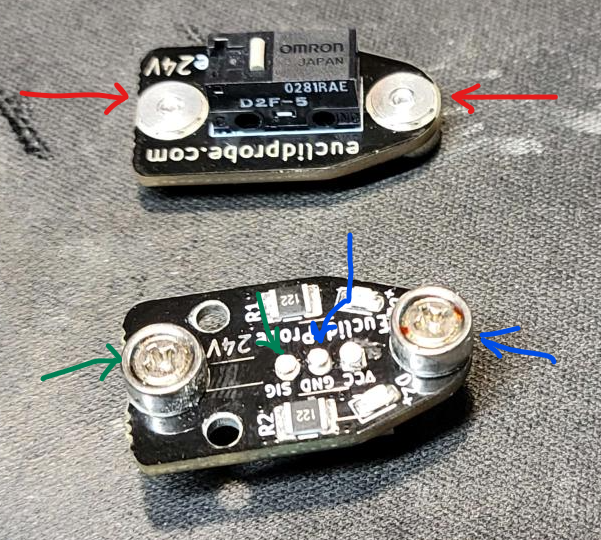
images/troubleshooting/image.png
