euclidprobe/euclidprobe.github.io/(commit log)

2022-01-24 1st push of homapage
    [12mmInductive-1.stl, 1515ExpanderDrillingJigHeatsert85deg.stl, 18mmInductive-1.stl, 4020FanPt3Left.stl, 4020FanPt3Right.stl, 5015V3Left-1.stl, 5015V3Left.stl, 5015V3Right.stl]
2022-01-30 stl file issues
    test upload of stls
    [EuclidTappingJig2.stl, GraftingDockFlushM3Heatserts.stl, GraftingDockFlushM3PilotHoles.stl, GraftingDockSurfaceMtM3Heatserts.stl, GraftingDockSurfaceMtM3PilotHoles.stl, Grafting_Dock1.stl, Grafting_Dock2.stl, Grafting_DockV3.stl]
2022-01-30 test stl viewer
    [soldering_jigV5-0.5mm_margin.stl]
2022-01-30 Dock files Added
    [Grafting_Dock1.stl, Grafting_Dock2.stl, Grafting_Dock_RegBoss_V3.stl, soldering_jigV5-0.2mm_margin.stl]
2022-01-30 Modular Mounts Added
2022-02-02 switch to lity
2022-02-05 broken sidebar at mounts by printer
2022-02-06 bulk insert of sections pre-copy
2022-02-07 Probe Mounts Added
    [12mmInductive.stl, 18mmInductive.stl, BLTouch-M3HeatSerts.stl, BLTouch-M3HeatSertsPIP.stl, BLTouch-M3PilotHoles.stl, BLTouch-M3PilotHolesPIP.stl, BLTouch-M3Pilots.obj, BLTouch-M3Pilots.stl]
2022-02-07 added wiring sections
2022-02-08 updated docks and mounts
2022-02-09 24v NOTES
2022-02-09 klipper updates
2022-02-10 wiring updates
2022-02-12 added printer files
2022-02-13 5V vs 24V summary added
2022-02-19 klipper warning
2022-02-22 klipper cfg
2022-02-23 updated klipper macro page
2022-02-24 wiring drawings typos
2022-02-25 pin order pics
2022-02-25 updated voltage pages
2022-02-27 updated PCBs
2022-02-28 voltage demos
2022-03-08 updated CAD links
2022-03-12 24V updates
2022-03-16 Voron Gantry Mount V2
2022-03-19 tweaked voron2.4 mount
2022-03-29 clarified Voron Mounts
2022-03-31 Voron Gantry Mount Revisions- Shorty
2022-05-03 Solder Jig clarifications
2022-05-04 voltage difference discussions
2022-05-12 fixed Voron Gantry links
2022-05-17 fixed broken voron 90 mount links
2022-10-14 corrected z-probe setting heights
2022-10-25 Added page for CANBUS boards, fixed OSHPark URL
2022-11-02 Corrected klipper macros V3
2022-11-03 added info for CANBUS boards
2022-11-08 updated klipper setup
