euclidprobe/euclidprobe.github.io/(notices)

Notices in the files:
index.md:
CC BY-NC-SA 4.0
