euclidprobe/euclidprobe.github.io/images/mrrf_sign.jpg

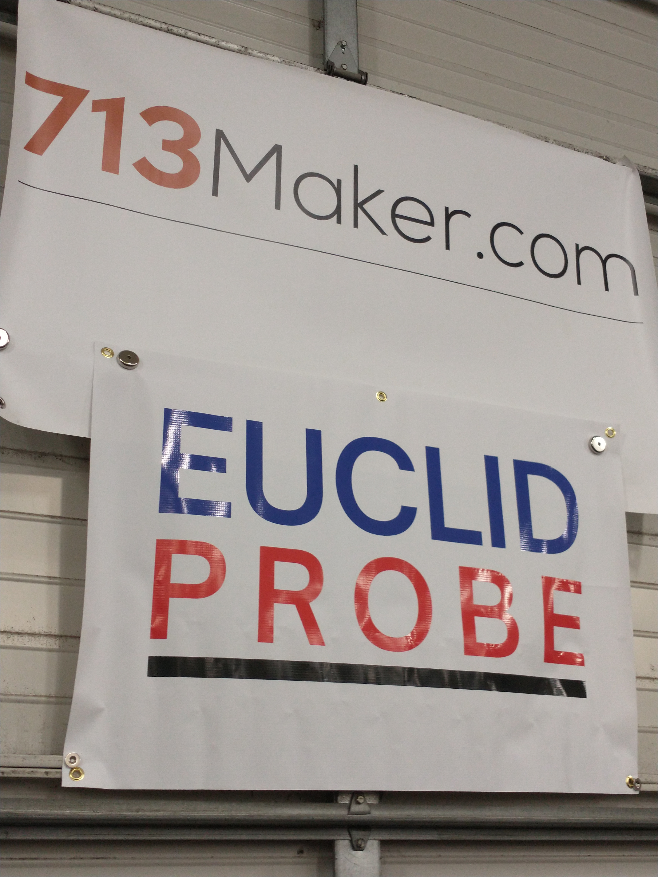
images/mrrf_sign.jpg
