euclidprobe/euclidprobe.github.io/images/01_assembly/IMG_20220206_115426347.jpg

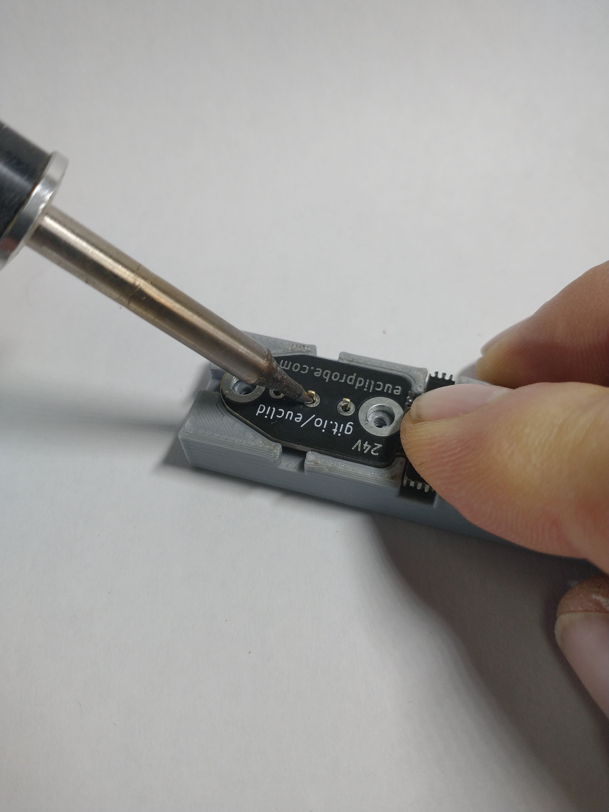
images/01_assembly/IMG_20220206_115426347.jpg
